TDX33029/Cubli-STM32F407-ESP32/Hardware/gif-demo.gif

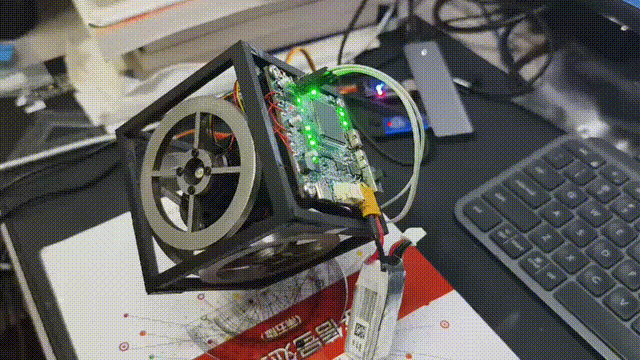
Hardware/gif-demo.gif
