TDX33029/Cubli-STM32F407-ESP32/Hardware/MB_RC.PNG

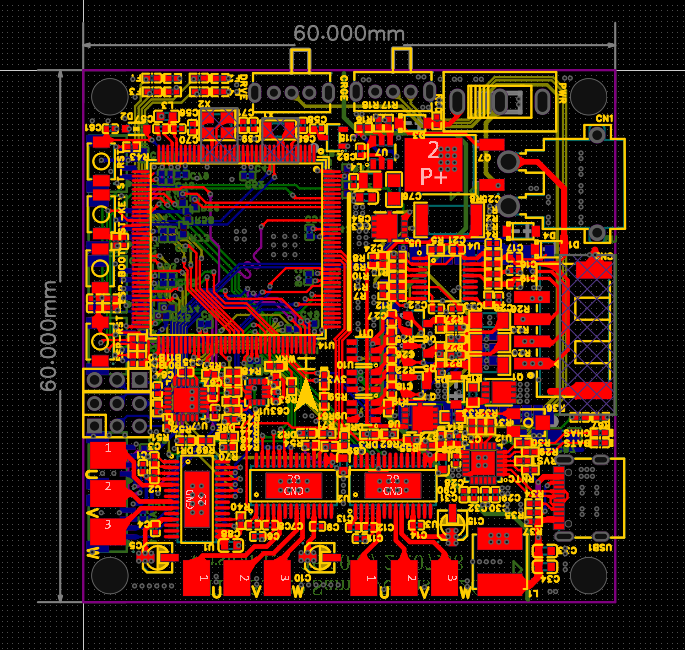
Hardware/MB_RC.PNG
