TDX33029/Cubli-STM32F407-ESP32/README.md

# Cubli Wireless

[🇨🇳 简体中文](README.md) | [🇬🇧 English](README_EN.md)

> LQR 平衡控制器算法 · STM32F407ZGT6 + ESP32-WROOM32 联合工程 支持二次开发学习

## 简介

本工程为 Cubli 平衡控制器的完整开源实现，包含固件、硬件、机械结构、上位机软件及全部必要文档，所有材料均已提供，不再赘述。

## 编译与构建

| 组件 | 工具链 |
| --- | --- |
| STM32F407ZGT6 固件 | Keil MDK V5.06 |
| ESP32-WROOM32 固件 | PlatformIO |

## 文件结构

| 目录 | 内容 |
| --- | --- |
| `Docs/` | 必要的数据手册文档 |
| `Firmware/` | STM32F407ZGT6 与 ESP32-WROOM32 固件源码 |
| `Hardware/` | PCB 相关资源文件 |
| `History/` | 历史提交归档 |
| `Mechanical/` | 机械结构相关资源文件 |
| `Software/` | 上位机控制器源码与可执行文件 |
| `Statistics/` | 参数统计数据与曲线 |

## 演示与预览

### 平衡控制器演示

https://github.com/user-attachments/assets/ebfe2009-a91b-4555-8b46-bfa3d13127df

### PCB 渲染与 Layout

| PCB 正面渲染 | PCB 背面渲染 |
| :---: | :---: |
| MB-3D-TOP | MB-3D-BOTTOM |

<p align="center">
  PCB Layout
  <br />
  <em>PCB 本体 Layout</em>
</p>

### 机械结构

<p align="center">
  3D 结构框架透视图
  <br />
  <em>3D 结构框架透视图</em>
</p>
