TDX33029/Cubli-STM32F407-ESP32/Hardware/README.md

# Hardware

[🇨🇳 简体中文](README.md) | [🇬🇧 English](README_EN.md)

> PCB 相关设计工程、生产制造文件及渲染图

## 文件列表

| 文件 | 说明 |
| --- | --- |
| `Cubli-Ver1.4-BLE.epro2` | 嘉立创PCB工程文件 包含主板与编码器小板 |
| `Gerber_MB.zip` | Gerber工程制板文件 |
| `Netlist_MB_Schematic.net` | 主板网表文件 |
| `MB_RC.PNG` | PCB隐藏铺铜透视图 |
| `MB-3D-TOP.PNG` | PCB顶层3D渲染图 |
| `MB-3D-BOTTOM.PNG` | PCB底层3D渲染图 |
