TDX33029/Cubli-STM32F407-ESP32/Hardware/README_EN.md

# Hardware

[🇨🇳 简体中文](README.md) | [🇬🇧 English](README_EN.md)

> PCB design project files, fabrication files, and renderings

## File List

| File | Description |
| --- | --- |
| `Cubli-Ver1.4-BLE.epro2` | JLC PCB project file, including the mainboard and encoder board |
| `Gerber_MB.zip` | Gerber fabrication files |
| `Netlist_MB_Schematic.net` | Mainboard netlist file |
| `MB_RC.PNG` | PCB hidden copper pour perspective view |
| `MB-3D-TOP.PNG` | PCB top-layer 3D rendering |
| `MB-3D-BOTTOM.PNG` | PCB bottom-layer 3D rendering |
