TDX33029/Cubli-STM32F407-ESP32/Firmware/README.md

# Firmware

[🇨🇳 简体中文](README.md) | [🇬🇧 English](README_EN.md)

> STM32F407ZGT6 与 ESP32-WROOM32 固件源码及调试工具链

## 文件结构

| 目录 | 内容 |
| --- | --- |
| `Cubli-ST/` | STM32F407ZGT6固件源码 |
| `Cubli-ESP/` | ESP32-WROOM32固件源码 |
| `Diagnostics/` | 硬件与功能块诊断代码 |
| `Tests/` | 测试代码 |
| `README/` | 详细调试与验证说明文档归档 |
