TDX33029/Cubli-STM32F407-ESP32/Firmware/README_EN.md

# Firmware

[🇨🇳 简体中文](README.md) | [🇬🇧 English](README_EN.md)

> STM32F407ZGT6 and ESP32-WROOM32 firmware source code and debugging toolchain

## Directory Structure

| Directory | Contents |
| --- | --- |
| `Cubli-ST/` | STM32F407ZGT6 firmware source code |
| `Cubli-ESP/` | ESP32-WROOM32 firmware source code |
| `Diagnostics/` | Hardware and functional block diagnostic code |
| `Tests/` | Test code |
| `README/` | Detailed debugging and verification documentation archive |
