TDX33029/Cubli-STM32F407-ESP32/Statistics/06_平衡性能指标对比/README.md

# 图 6：平衡性能指标对比

## 目标

在同一台设备、同一中性参考种子下，对比三组 LQR 参数的平衡性能：

- 基线：`Kp=80, Kd=5, Kw=-0.030, Ki=0`
- 低增益：`Kp=60, Kd=4, Kw=-0.030, Ki=0`
- 高增益：`Kp=110, Kd=7, Kw=-0.030, Ki=0`

## 实验与数据

每组 30 s 连续平衡，参数切换与数据采集由 `capture_compare.py` 自动完成。每组开始前
都重新下发同一组配置：

```
BREF -0.702828789 0.397786931 0.589743377
BNEUTRAL 1 0.00025 0.5 5 23.40 48.60
LQR1/2/3 <Kp> <Kd> -0.030 0
BAUTO 1 2
```

> 必须保持 `BNEUTRAL` 种子，否则固定 `BREF` 的 1–2° 重心偏置会使飞轮在 3 s 内
> 饱和跌倒（见 `05_扰动恢复能力测试/README.md`）。

| 数据文件 | 参数 | 平衡时长 | 数据帧 |
|---|---|---|---|
| `compare_base.csv` | 80 / 5 | 30.14 s | 604 |
| `compare_low.csv` | 60 / 4 | 30.07 s | 603 |
| `compare_high.csv` | 110 / 7 | 30.13 s | 604 |

采集过程中三组都出现了 **2–4 次重复扰动**（角速度峰值 30–38°/s，间隔约 6 s），
可能是线缆牵拉、桌面滑动或连续轻敲，并非单次受控冲击。因此本图的“恢复时间”取
每组检测到的扰动的**中位数**，并在括号内给出范围；单次受控三次冲击的重复性测试
见 [图 5](../05_扰动恢复能力测试/README.md)。

## 指标定义

| 指标 | 定义 |
|---|---|
| RMS 倾角 | 30 s 内 `sqrt(ePitch²+eRoll²)` 的 RMS |
| 最大倾角 | 30 s 内姿态偏差模长的最大值 |
| 恢复时间 | 扰动后平滑偏差回到冲击前包络并保持 0.5 s；取各组扰动中位数 |
| 初始稳定时间 | 从接管起，偏差连续 1 s 保持在 ±0.5° 内所需时间 |
| 飞轮转速峰值 | 三只飞轮 `|S|` 的最大值 |
| 电压峰值 / RMS | 三只电机控制电压的最大值 / RMS |

## 结果

| 指标 | 基线 80/5 | 低增益 60/4 | 高增益 110/7 |
|---|---|---|---|
| RMS 倾角 | **0.61°** | 0.87° | 0.63° |
| 最大倾角 | **3.04°** | 5.08° | 3.89° |
| 恢复时间中位数 | 1.30 s | 1.24 s | **0.70 s** |
| 恢复时间范围 | 1.29–1.31 s | 1.19–1.83 s | 0.44–2.79 s |
| 扰动次数 | 2 | 3 | 4 |
| 初始稳定时间 | 0.81 s | 0.00 s | 0.57 s |
| 飞轮峰值 | 103 rad/s | 108 rad/s | 122 rad/s |
| 电压峰值 | 4.65 V | **4.32 V** | 6.00 V |
| 电压 RMS | 0.95 V | 0.85 V | 1.21 V |

## 解读

1. **基线 80/5 是综合最稳的一组。** RMS 0.61° 最低，最大倾角 3.04° 最小，两次
   扰动的恢复时间几乎一致（1.29–1.31 s），电压峰值 4.65 V 仍有余量。
2. **低增益 60/4 抗扰最差。** RMS 0.87°、最大倾角 5.08°，约为基线的 1.4/1.7 倍；
   虽然控制电压最低（RMS 0.85 V），但姿态误差和振荡幅度明显变大，不建议用于
   需要抗扰的场合。
3. **高增益 110/7 恢复最快但不稳定。** 恢复时间中位数 0.70 s，明显快于基线；
   代价是电压峰值顶到 6 V 限幅、飞轮峰值 122 rad/s、电压 RMS 最高，而且有一次
   扰动需要 2.79 s 才恢复，说明一致性较差、接近权限边界。
4. **初始稳定都很快（<1 s）。** 三组接管时都在 0.5° 入位窗口内，初始稳定时间
   差异不显著；真正的差别体现在持续扰动下的 RMS 和最大偏差。
5. **建议：** 保留基线 80/5 作为默认参数。如果确实需要更快的扰动恢复，可把
   `Kp/Kd` 提高到 100/6 左右，同时把 `U` 限幅提高到 7 V 或降低重心偏置；不建议
   直接使用 110/7 + 6 V 限幅，因为已经出现饱和。

## 文件

| 文件 | 说明 |
|---|---|
| `capture_compare.py` | 三组参数自动切换 + BAUTO + 30 s 采集 |
| `compare_base.csv` / `compare_low.csv` / `compare_high.csv` | 三组原始遥测 |
| `compare_meta.csv` | 组别、增益、帧数、结果 |
| `plot_compare.m` | 指标计算与三联图（时序 + 6 项柱状图） |
| `performance_compare.png` | 输出图 |

## 复现

```bash
py capture_compare.py COM10 --balance=30 --wait=600
matlab -batch "cd('<本目录>'); plot_compare"
```

现场共 3 轮，每轮扶到 **PG8 常亮**、PG6 亮起瞬间松手；原计划每组敲一次，
实际数据中每组检测到 2–4 次扰动。若要做严格单次冲击对比，请使用图 5 的
`capture_seeded.py` / `plot_disturbance.m` 流程。
