TDX33029/Cubli-STM32F407-ESP32/Firmware/单点姿态观测对照_2026-10-16.md

# 单点姿态观测对照

三轴正负脉冲支持现有 BAXIS2/3/1 和 BDIR-1/-1/-1；启动电机校准用于编码器映射、方向与换相零点，脉冲的主要用途是测整机响应与轴间耦合。完整配对响应反推惯量违反主惯量三角不等式，未用于推荐增益。

四条控制日志中，融合姿态与 FAST 陀螺仪逐帧预测有约0.14～0.21°的20ms中位差，校正量与倾斜角加速度呈负相关，拟合系数约-0.017～-0.026秒。相关性有重力、采样和接触误差，不能直接认定IMU故障；见 diagnostics/2026-10-16/corner_observer_acceleration_consistency_review.json。

固定支点转动会在偏离支点的IMU上产生 `alpha x r + omega x (omega x r)`。这些加速度的方向会影响加速度计的倾角估计，即使加速度模长接近1g。用生产姿态估计代码进行已知真值仿真（3Hz、角速度幅值0.15rad/s、传感器位置y35mm/z70mm），加速度校正时间常数0.25秒时RMS误差0.1762°，1秒时0.0372°。该结果只是仿真，不能替代实机验证。

## 可选试验参数

新增失能命令 `BATTAU .25..2`，状态回读 `ATune:1 / AttTau`。默认仍为0.25秒；换模式、重新校准或复位恢复0.25秒。STOP保留当前值。拒绝活动状态、功率级仍使能、非有限值及越界值。

有限试验 `serial_corner_trial.py --attitude-tau 1` 会验证固件能力并回读实际值；未指定时在支持的固件上显式恢复0.25秒。既有长期自动脚本也恢复0.25秒，避免实验值留入旧基线。入位、陀螺仪积分、校准、传感器有效性与所有电机/倾倒保护不变。

第一轮只改变该时间常数：Kp80/Kd8/Kw-0.040（三轴）、Ki0、BYAW6、BTRIM0、参考24.70°/49.72°、自动寻点关闭、1°入位/2秒倒计时、6V、主机220rad/s/1.5rad/s/10°、固件L240/BTRIP20。先最多5秒，依据日志延长；不调方向、不增加电压或保护阈值。

## 软件验证与固件

生产C控制/UART测试通过，包括固定支点传感器仿真、静态收敛、参数边界、非有限数据、活动设置拒绝、模式/校准复位及既有控制律和保护回归。42项串口诊断测试通过，含默认清除实验值、显式设置回读及不支持/设置失败拒绝启动。实际UART六位小数回读修复沿用。

固件单独保存于 Cubli-ST/MDK-ARM/CubeMX-corner-observer。38个ARMCC输入、0错误、0警告；HEX校验和、烧录及实机结果以该目录 review_manifest.json 和后续日志为准。历史镜像保留。

## 首次实机结果

`corner_observer_tau1_comref_kd8_kw040_yaw6_trial5s_01` 的 ATune/AttTau 回读确认1.00秒，运行3.875秒后主机角速度1.614rad/s保护。M1=-163.64rad/s、M3=-193.38rad/s，两轴均达到-6V；最终三轴失能。没有完成5秒，不提升为默认配置。

逐帧观测校正率中位值由历史0.25秒日志约7.98°/秒降为这轮4.56°/秒，但释放条件和运动轨迹有差异，不能当作精确因果比较；幅度降低没有自动带来稳定。详见 diagnostics/2026-10-16/corner_observer_tau1_correction_review.json。下一轮在同一固件/同一次校准恢复0.25秒，保持所有其他参数，进行5秒对照。

该0.25秒对照 `corner_observer_tau025_comref_kd8_kw040_yaw6_trial5s_01` 在600秒等待中始终平放，未接管，active_samples=0；不能记为平衡失败或定时完成。已自动STOP/FAST0并确认 `Bal0/EN000/Auto0/Fault0/Aligned111/Cal1/AttTau0.25/NOn0`，停机限压2.5V、轮速15。后台仅剩只读角度窗口PID27020，没有电机调控进程。下一步待现场能手扶原角点时，直接重启同配置5秒对照；不复位就无需重新自检，不重新询问电池/支点/线材，不重新辨识转向。

用户选择后续每轮用弹出消息提醒。已在只读实时窗口实现无模态提醒：每个新试验首次进入等待/倒计时弹出一次，显示试验内容、实时和目标角度；没有确认或记录按钮，关闭消息不影响试验，摆好后MCU自动倒计时。PG6接管、停机或姿态过期时收起提示。元数据由有限试验脚本发布，窗口不发送控制命令/心跳。12项窗口测试和42项串口测试通过。串口连接正常但缺姿态时也不再误写成“自动重连”，会显示等待姿态数据。

## 弹窗版实机继续

窗口已重启为PID19356，系统枚举确认准备提醒在右上角可见（1432,20～1908,289），主实时窗口在中间，可同时看数据。`_trial5s_02` 开始前检测到设备复位（Aligned000/Cal0），没有启动；用户确认准备后 `corner_observer_popup_reset_prep01` 重新完成自检/校准。因此后续0.25秒数据与之前1秒数据不是严格同一次校准配对，不以时长差直接判断滤波优劣。

`corner_observer_tau025_comref_kd8_kw040_yaw6_trial5s_03` 完成真实入位与接管，运行2.672秒角速度1.548rad/s保护，M3约-204.61rad/s/-6V。随后只换旧参考23.44°/50°，`corner_observer_oldref_tau025_kd8_kw040_yaw6_trial5s_01` 运行3.735秒角速度1.735保护，M1/M3均-6V。两轮最终三轴失能。均未完成5秒；单独换参考/滤波尚未解决。

下一轮以同一次校准恢复历史已确认5秒的完整备份参数80/5/-0.040/0、BYAW6、旧参考23.44/50，τ0.25、寻点关闭；只把Kd8恢复Kd5，先5秒复现，记录 `corner_observer_verified_profile_kd5_trial5s_01`。尚未验证，不视为恢复成功。

另用六次既有启动扫描离线检查等电场相位的编码器重复性：正反向均值的电角度偏移跨度M1约34°、M2约44°、M3约43°。动态扫描的跟随滞后、齿槽和编码器非线性均可能贡献；M3谐波拟合的留出误差反而较大，不能据此建立校正表或断言编码器损坏。数据见 diagnostics/2026-10-16/encoder_bidirectional_phase_repeatability_review.json。没有改编码器校正、极对数或换相零点算法。

## 用户暂停断点

完整历史参数复测 `corner_observer_verified_profile_kd5_trial5s_01` 实际运行4.110秒后角速度1.914rad/s保护，M1=-211.47rad/s/-6V，M3=-70.22rad/s/-5.10V，最终确认EN000/Bal0。没有复现5秒成功，不能当成恢复完成。

下一候选只提高Kp80→120，保留Kd5/Kw-0.040/BYAW6/τ0.25、旧参考23.44/50、寻点关闭、6V及原保护，最多5秒。`corner_observer_oldref_kp120_kd5_trial5s_01` 打开串口即失败：CH340/COM7不存在，仅蓝牙COM3/COM4，active_samples=0、没有发送命令，**该Kp120试验尚未执行**。

用户明确要求“先停止等待我手动恢复”。已停止等待和调试，不后台轮询或自动重试。恢复必须由用户消息触发，再发现实际CH340端口、读取新STATE，检查是否复位；只在需要时恢复常规自检/校准。只读窗口原PID19356已不存在，恢复时按实际端口重新启动弹窗版窗口。最后一次实际失能确认来自Kd5复测；离线期间无法验证设备状态，不能把live.json缓存当作当前状态。下次Kp120试验需新tag，避免覆盖已有失败日志。
