TDX33029/Cubli-STM32F407-ESP32/Firmware/单点自动寻点说明_2026-10-16.md

# 单点自动寻点试验

目的：在原始重心候选附近缓慢移动控制目标，减少固定姿态偏差导致的持续飞轮加速。它是待实机验证的慢速外环，不保证真实重心已识别，也不增加电机力矩或改变保护阈值。

## 控制与边界

- 快环保留 Kp=80、Kd=8、Kw=-0.040（三轴）、BYAW=6 的试验配置；Ki=0、BTRIM=0。
- 将飞轮转速按已确认轴映射和机械方向转成机体向量，去除原始重力方向分量，只用倾斜平面的分量移动目标。相同飞轮惯量是此投影的前提。
- 低通时间常数 0.3 秒，轮速向量死区 3 rad/s。首轮增益 0.00025、最大速度 0.5°/秒；首轮失败后增加有界调参，默认降为 0.000025 和 0.1°/秒。总角度仍不超过原始参考的 2°。
- 接管前 300 ms、角速度达到 0.5 rad/s、跟踪误差超过 5°、任一电机输出达到限压的 95%、传感器异常或数据过期时冻结调整并清除轮速滤波值。
- 原始参考仍作保护锚点。相对原始参考或动态目标任一偏差超过固件倾倒阈值均保护；主机仍检查原始参考 10°、机体 1.5 rad/s、飞轮 220 rad/s。6 V 限压和固件 240 rad/s 立即超速阈值沿用有限试验设置。
- STOP 保留本次学习偏移，清除瞬态滤波；重新设参考、换模式/轴/方向、校准或复位清除学习。没有写入 Flash，也没有自动覆盖备份参数。

## 使用

新增失能时命令 `BNEUTRAL 0/1 [gain rate_deg_s]`，默认关闭。NTune:2 允许增益 0.000005～0.00025、最大速度 0.01～0.5°/秒，越界拒绝。启用要求单点模式、有效参考/IMU 校准、三轴映射与方向确认，且 Ki/BTRIM 均为零；启用后拒绝非零积分设置。

有限试验脚本 `diagnostics/serial_corner_trial.py` 增加 `--neutral-learning`、`--neutral-gain`、`--neutral-rate`，要求显式固定参考，校验 NTune/NOn/NLimit/NRate/NGain 回读，并记录动态目标、相对原始参考最大偏移及实际跟踪偏差。主机额外检查遥测目标没有越过 2°（含 0.03°显示量化余量）。默认试验与既有自动长测脚本显式关闭学习，保证历史配置可复测；尚未把本功能提升为长期自动默认配置。

STATE 新增 NTune/NOn/NPit/NRol/NOff/NLimit/NRate/NGain。FAST 启用学习时以 NPit/NRol 替换三个始终为零的倾角积分字段，保持原 280 字节预算。只读角度窗口持续采样并显示“自动寻点目标”，定时剩余秒数和停机原因不变。

## 验证记录

生产 C 控制/UART 测试通过：开关条件、机械方向、纯自转不漂移、目标单位长度、范围/速度限制、异常冻结、STOP 保留与配置重置、学习后入位，以及原始参考保护不会随目标移动。35 个串口诊断测试及 10 个只读窗口测试通过。关闭功能时原控制律回归测试仍通过。

ARMCC 编译 38 个输入，0 错误、0 警告。固件单独保存在 `Cubli-ST/MDK-ARM/CubeMX-corner-neutral`，历史可用版本保留。实机效果与烧录状态见该目录 review_manifest.json 和后续试验日志；本文件的测试通过仅指软件测试。

## 首轮实机结果

`corner_neutral_comref_kd8_kw040_yaw6_trial5s_01` 实际运行 4.36 秒，触发主机角速度保护（1.645 rad/s），最终三轴失能确认。动态目标移动约 1.47°，从 24.70°/49.72° 到 23.53°/48.75°，M3 仍达到约 -200 rad/s、-6 V。相对动态目标最大偏差约 3.89°（不含最终保护帧），没有完成 5 秒运行，也没有证明找到重心。用户要求以日志分析为主。

调整在 M3 饱和后正确冻结，但此轮稳定时间没有改善。初始释放姿态与固定参考对照并非完全相同，不能仅凭一次时长断言因果。下一步只降低慢环增益/速度，与原快环做对照，不把该学习结果提升为默认参考。

## 慢速对照与回读修复

慢速镜像初次试验 `_trial8s_01` 没有接管：新增 NGain 回读需要 6 位小数，原 UART 固定格式最多输出 3 位，脚本发现回读不符后拒绝启动。已修复真实 UART 格式器并补充其输出回归测试；修复后 HEX SHA256 为 `fb1c4312be9587ca89f76d03fda778fde98983ccb7b5320dfa6ae2769876db68`，重新完成三轴自检及校准。

`corner_neutral_slow_comref_kd8_kw040_yaw6_trial8s_02` 使用增益 0.000025、速度 0.1°/秒，运行 5.797 秒后角速度 1.538 rad/s 保护，最终失能。目标移动约 0.43°，末值 Pitch24.40°/Roll49.38°。M3 轮速从约 -84 转到 +197 rad/s 并达到 +6 V。未完成 8 秒，不能称为长期平衡成功。

结合四条日志，以 0.2 秒积分窗口拟合电机电压/轮速响应，排除释放最初 0.4 秒和角速度超过 0.5 rad/s 的窗口，等效速度电压系数约为 0.0239/0.0235/0.0262 V/(rad/s)。留一轮验证的增量误差约 0.9～4.3 rad/s，故它只是观测模型，不能当作准确反电势、力矩或惯量测量。详细数据见 `diagnostics/2026-10-16/neutral_search_motor_response_review.json`。下一次只将 Kw 从 -0.040 小幅改为 -0.035，其余沿用慢速对照，不提高保护阈值。

## 本次收尾状态与下一步

Kw=-0.035 的对照 `corner_neutral_slow_comref_kd8_kw035_yaw6_trial8s_01` 运行 6.000 秒，仍以角速度 1.593 rad/s 保护，M3 为 +163.31 rad/s、+6 V，目标移动约 0.48°到 Pitch24.24°/Roll49.60°。也没有完成 8 秒。

| 试验 | 寻点增益 / 最大速度 | Kw | 实际运行 | 结果 |
| --- | --- | --- | --- | --- |
| 首轮 | 0.00025 / 0.5°每秒 | -0.040 | 4.36秒 | 角速度保护，偏移约1.47° |
| 慢速 | 0.000025 / 0.1°每秒 | -0.040 | 5.797秒 | 角速度保护，偏移约0.43° |
| 轮速项对照 | 0.000025 / 0.1°每秒 | -0.035 | 6.000秒 | 角速度保护，偏移约0.48° |

入位误差和释放瞬态不完全相同，因此时长差不是严格的因果证明。现有证据仅证明有界参考调整、保护和日志链路按设计运行，**没有证明长期平衡或重心识别收敛**。三轮均在 M3 达到限压后出现较大机体角速度；下一步应先验证多轴动态响应、控制余量与姿态估计的一致性，分离执行器补偿、耦合和重心误差，不应继续仅靠扩大寻点范围或提高保护阈值解决。

本次已执行 `corner_neutral_restore_baseline_disabled01`（仅配置、没有接管）：恢复测试前的 80/8/-0.040/0、BYAW6、BTRIM0、原始候选 Pitch24.70°/Roll49.72°。最终 `Bal0 / EN000 / Auto0 / Fault0 / NOn0 / NOff0`，三轴对齐和 IMU 校准有效；停止后限压回到 2.5 V、轮速限制 15 rad/s。自动寻点保留为默认关闭的实验功能，所有学习结果只在日志中保存。

当前固件为 `CubeMX-corner-neutral-slow`（含六位回读修复），SHA256 `fb1c4312be9587ca89f76d03fda778fde98983ccb7b5320dfa6ae2769876db68`。只读窗口 PID6760 持续读取 COM7（不发送心跳）；没有后台电机调控脚本。后续从日志和该文档继续，无需重复询问电池、支点、线材或每轮记录按钮。
