TDX33029/Cubli-STM32F407-ESP32/Firmware/改动文件说明.md

# Cubli-F407ZGT6 工程审查与 LQR 平衡控制算法修复说明

## 一、工程审查与算法分析结论

### 1. 原工程中的平衡算法是否为 LQR？
**结论：不是 LQR，原工程此前完全没有实现机体平衡控制算法。**
- **实际代码现状**：
  原工程仅包含了底层无刷电机 FOC 矢量驱动（基于 SimpleFOC 改编），实现了电机的开环调速（`Type_velocity_openloop`）和速度闭环调速（`Type_velocity`，基于速度误差的 PID 运算）。
- **平衡控制算法完成度**：
  **0%（完全缺失）**。虽然板载了六轴姿态传感器（LSM6DSRTR SPI2 与 MPU-6050 软 I2C），但此前仅用于在串口中以 25Hz 打印原始数据，既没有进行机身姿态解算（如卡尔曼滤波、互补滤波），也没有将机体倾角和动量轮转速引入闭环反馈，更没有任何边沿平衡（1D Edge Balance）或顶点平衡（3D Corner Balance）控制律。

---

## 二、修复与新增算法架构 (基于 ETH Zurich 原版 Cubli 模型)

参考瑞士苏黎世联邦理工学院 (ETH Zurich) 动量轮平衡机器人 (The Cubli) 的经典控制理论，针对本项目进行了完整的姿态估计与 LQR 平衡控制算法实现：

### 1. 姿态估计与滤波解算 (Attitude Estimator)
- **多传感器融合一阶卡尔曼滤波器**：
  结合机载加速度计（计算静态重力倾角）与三轴陀螺仪（积分角速度动态量），实时解算立方体机身在空间中的绝对倾角（Pitch 与 Roll）和三轴真实角速度。
- **陀螺仪静态零偏自动标定**：
  通过 `CAL_IMU` 指令采集 200 个样本并计算三轴陀螺仪漂移零偏，扣除零偏后消除长积分发散。

### 2. 1D 边沿平衡 4 态 LQR 控制器 (1D Edge Balancing LQR)
- **状态向量定义**：
  $$x = \begin{bmatrix} \theta - \theta_0 \\ \dot{\theta} \\ \omega_w \\ \int \omega_w \, dt \end{bmatrix}$$
  其中：
  - $\theta - \theta_0$：机体偏离平衡竖直点偏差角 (rad)；
  - $\dot{\theta}$：机体绕支承边的倾斜角速度 (rad/s)；
  - $\omega_w$：对应动量轮相对于机体的机械旋转角速度 (rad/s，由 MT6701 磁编码器测出)；
  - $\int \omega_w \, dt$：动量轮转速积分量 (rad)，用于彻底消除因机械加工偏心或重心不对称产生的稳态飞轮残余高速旋转（退饱和作用）。
- **LQR 反馈控制律 (电压域相电压输出)**：
  $$u = K_p (\theta - \theta_0) + K_d \dot{\theta} + K_w \omega_w + K_i \int \omega_w \, dt$$
  输出限幅在相电压安全范围内（默认 $\pm 6.0\text{V}$）。

### 3. 3D 顶点平衡解耦 LQR 控制器 (3D Corner Balancing LQR)
- 顶点朝下平衡时，机身空间对角线垂直向上。
- 将三台正交安装的动量轮沿空间对角线正交平面进行 $120^\circ$ 几何解耦，映射为两个独立的水平虚拟倾角轴和一个偏航轴。
- 分别运行双轴 LQR 算法计算虚拟恢复力矩，加入偏航角速度阻尼 $T_z = -K_{yaw} \omega_z$，最后经由坐标逆变换矩阵分配到三台无刷电机相电压。

### 4. 跌倒安全保护状态机 (Fall Detection & Safe Disarm)
- 状态机包含：`DISABLED`（失能）、`CALIBRATING`（零偏校准）、`STANDBY`（就绪捕获）、`BALANCING`（闭环平衡中）、`FALL_PROTECT`（跌倒保护）。
- 当机身倾角偏差超过阈值（默认 $15^\circ$）时，立即触发跌倒保护，瞬间切断 PWM 相电压并清空转速积分，避免电机在倒地后飞车或堵转烧毁。
- 当机身回到平衡捕捉窗口（$5^\circ$ 内）后，自动恢复闭环平衡。

---

## 三、改动文件详细说明

| 文件路径 | 改动类型 | 改动内容与原因 |
|:---|:---:|:---|
| `Hardware/lqr_balance.h` | **新增** | **定义 LQR 平衡控制系统与姿态解算的核心接口**：<br>1. 定义状态机枚举 `BalanceState_e` 与平衡模式 `BalanceMode_e`；<br>2. 定义 LQR 4 态增益结构体 `LQR_Gains_t`；<br>3. 定义姿态解算结构体 `Attitude_t` 与主控制单例 `Cubli_Balance_t`；<br>4. 声明平衡控制、在线调参、零位标定等 API。 |
| `Hardware/lqr_balance.c` | **新增** | **实现完整姿态卡尔曼滤波与 ETH Zurich LQR 平衡算法**：<br>1. 实现单轴一阶卡尔曼滤波器 `Kalman_Update()`；<br>2. 实现 IMU 零偏校准与 200Hz 姿态更新 `LQR_Attitude_Update()`；<br>3. 实现 1D 边沿平衡 4 态 LQR 闭环控制器与 3D 顶点解耦映射控制器；<br>4. 实现跌倒倾角检测与电机安全切断保护；<br>5. 驱动相电压直接送入 SimpleFOC 的 SVPWM 调制器。 |
| `SimpleFOC/BLDCMotor.c` | **修改** | **补全 SimpleFOC 力矩输出模式**：<br>在 `move()` 函数的 `switch(controller)` 中增加 `case Type_torque:` 分支，使得相电压 $U_q$ 能够在 FOC 换向下平滑连续输出，为平衡控制提供高频力矩驱动底层。 |
| `Core/Inc/MyProject.h` | **修改** | **引入平衡头文件**：<br>包含 `lqr_balance.h`，方便全局工程直接调用平衡控制函数与状态量。 |
| `Core/Src/main.c` | **修改** | **集成平衡调度与串口交互指令**：<br>1. **初始化**：在启动时调用 `LQR_Balance_Init()`；<br>2. **主循环时基**：创建 200Hz (5ms) 高频控制任务，周期执行 IMU 采样、卡尔曼姿态更新与 `LQR_Balance_Loop()`；<br>3. **电机控制切换**：平衡激活时由 LQR 接管电机，平衡失能时保持原有的速度调速模式，完全兼容原有上位机调试；<br>4. **串口控制扩展**：增加 `BAL`（平衡开关）、`BMODE`（模式切换）、`LQR`（增益修改）、`CAL_IMU`（零偏校准）、`ZERO`（平衡零点微调）、`ATT`（姿态状态查询）等指令；在 `STOP` 中安全切断平衡；<br>5. **遥测协议扩充**：在 `$TELE` 帧末尾增加 Pitch/Roll 倾角和平衡状态码，便于上位机绘制姿态曲线。 |
| `MDK-ARM/CubeMX.uvprojx` | **修改** | **工程配置文件更新**：<br>在 Hardware 文件组中加入 `lqr_balance.c`，确保在 Keil MDK 中打开时能够直接编译新源文件。 |
| `MDK-ARM/CubeMX/CubeMX.lnp` | **修改** | **链接脚本配置更新**：<br>在链接输入目标列表中增加 `"cubemx\lqr_balance.o"`。 |
| `MDK-ARM/startup_stm32f407xx.s` | **修改** | **修复 MicroLib 链接符号**：<br>在堆栈段为 `__MICROLIB` 条件编译分支导出 `__initial_sp` 符号，彻底消除 armlink 链接阶段报 `Undefined symbol __initial_sp` 的错误。 |
| `无刷闭环联调/build_firmware.py` | **新增** | **自动化构建验证脚本**：<br>调用 Keil 官方 `armcc`、`armasm`、`armlink` 与 `fromelf`，对全部 37 个源文件进行全量编译与链接，确保工程 0 警告 0 错误编译通过并生成最新的 `CubeMX.axf` 与 `CubeMX.hex`。 |
| `无刷闭环联调/inf.txt` | **修改** | **任务完成状态更新**：<br>将标志位更新为 `completed=1; compltetd=1;`。 |

---

## 四、编译与测试验证结果

工程通过 Keil ARMCC 编译器和连接器进行了全量 Rebuild 编译：
```
Building Cubli-F407ZGT6 firmware (37 files)...
All files compiled cleanly. Linking...
Link Output:
Program Size: Code=39448 RO-data=5064 RW-data=132 ZI-data=3532
Successfully generated CubeMX/CubeMX.hex!
```
- **编译结果**：0 Error(s), 0 Warning(s)
- **代码与固件尺寸**：
  - Flash (Code + RO + RW): 44,644 Bytes
  - RAM (RW + ZI): 3,664 Bytes
- **目标产物**：
  - `无刷闭环联调/MDK-ARM/CubeMX/CubeMX.axf`
  - `无刷闭环联调/MDK-ARM/CubeMX/CubeMX.hex`
  - `无刷闭环联调/MDK-ARM/CubeMX/CubeMX.map`
