TDX33029/Cubli-STM32F407-ESP32/Firmware/本次检查与双模式联调说明.md

# 2026-10-12 检查修复与双模式联调记录

本次实际检查 `Cubli-ST`、`Cubli-ESP`、`Software` 和 `Netlist_MB_Schematic_2026-10-07.net`，并修改源码。现已实现上位机控制的**单电机调试模式**和**平衡工作模式**，三端协议配套更新。历史改动说明中的算法与构建记录属于旧版本，以本文及当前源码为准。

## 网表核对

| 对象 | 硬件连接 | 当前软件配置 |
| --- | --- | --- |
| M1 DRV8313 | EN=PD0，IN1/2/3=PE9/PE11/PE13 | TIM1三路PWM |
| M2 DRV8313 | EN=PD1，IN1/2/3=PA6/PA7/PB0 | TIM3三路PWM |
| M3 DRV8313 | EN=PD2，IN1/2/3=PD12/PD13/PD14 | TIM4三路PWM |
| 驱动故障 | FAULT1/2/3=PG9/PG10/PG11，低有效 | 新增上拉输入与1ms故障检查，故障关闭全部EN |
| MT6701 | M1=I2C1 PB6/PB7；M2=I2C2 PF1/PF0；M3=I2C3 PA8/PC9 | 默认绝对角度读取，固定网表映射 |
| 主IMU | LSM6DSR SPI2 PB12～PB15 | 416Hz输出，200Hz重力姿态更新 |
| 备用IMU | MPU6050 PB10/PB11软件I2C | 200Hz采样，减少原5Hz滤波造成的延迟 |
| 板载无线 | PA9→ESP IO26；ESP IO25→PA10 | USART1，115200/8N1，TCP3333 |
| 晶振 | 网表25MHz | PLLM=25，系统168MHz，与配置匹配 |

DRV8313的SLEEP由网表中的硬件开关控制，RESET上拉；软件通过每颗驱动共用的三个EN实现失能。未虚构可控的SLEEP/RESET引脚。

## 已修复问题

1. **HAL时基重复累加**：原SysTick、TIM6都调用HAL_IncTick，延时和控制周期约快一倍。现在只有SysTick维护HAL时间，TIM6用于1ms安全检查和遥测计数。
2. **没有独立调试/工作模式**：增加APP状态，固件强制互锁；调试只能使能选中的一台电机，工作模式拒绝手动调速和驱动使能。
3. **退出平衡恢复历史速度**：全部模式/轴/开闭环切换先清零、失能并复位控制状态；BAL 0和STOP同样处理。
4. **校准会自行启动平衡**：IMU校准只校准，不使能；连续200个静止样本后回到失能状态，启动必须单独执行BAL 1。
5. **跌倒后自动复转**：改为锁存停机，重新扶正后必须显式启动。
6. **平衡换相只有200Hz**：把200Hz姿态/状态反馈与主循环中的快速编码器采样/SVPWM换相分开。200Hz保持的是Uq目标，电角度持续更新；实际换相频率受I2C吞吐限制，尚未在板上测量。
7. **顶点模式越界**：原LQR/ATT等按mode=3访问长度3数组。参数接口统一通过边沿/顶点的三轴参数组访问，避免越界，也可回读顶点增益。
8. **顶点姿态与输出轴不一致**：取消把机体Euler角直接当水平虚拟轴角的120°分配；改为机体系归一化重力方向与目标方向的叉乘误差，三轴分配与机体轴一致。M3边沿也使用重力投影，不再依赖漂移的yaw积分。
9. **安装方向与编码器方向混用**：增加独立BDIR机架方向，编码器自动旋向只用于FOC/测速；BZERO采集真实平衡姿态。
10. **对齐可能假成功**：编码器离线、扫动无位移、位移与7极对数明显不符或停机中止，均判为失败。单轴自检/对齐完成保持失能，不再自动使能所有已安装电机。
11. **串口连续命令丢失**：将原单条接收标志改为16槽队列。PING和STOP由接收中断优先处理；超长/损坏行整行丢弃，队列溢出停机。严格解析命令token和有限数值，避免前缀误匹配和NaN控制量。
12. **printf可能阻塞控制**：发送缓冲满时不再自旋等待；遥测根据缓冲余量跳过整帧。状态周期改为5Hz，避免和25Hz遥测一起占满115200链路。
13. **没有断链停机**：上位机250ms心跳、STM32 1500ms超时失能；ESP不代发心跳。ESP仅允许一个控制客户端，连接/断开均发送STOP。TCP EOF和发送/接收错误向界面报告并关闭链路。
14. **急停可能被防抖队列覆盖**：上位机急停清空待发指令和速度防抖，STOP置于队首；断开/重连清空历史队列。
15. **驱动/阻塞/堵转保护不足**：新增nFAULT检测、主循环超过30ms未更新停机；调试与平衡持续高输出但低速堵转800ms时失能。异常处理器也拉低EN。停止不是主动制动，动量轮可能继续惯性旋转。
16. **界面状态错误**：开闭环按钮不再按文字猜测或提前显示成功；APP、轴、使能、校准、故障、倾斜、Uq由固件STATE回读。调试显示单轴卡片，工作显示平衡配置；增加参数查询、安装方向、姿态采集和停机复位入口。
17. **正交编码器时基边界**：修复备用TIM7微秒计数在溢出待处理时的读取竞争。默认仍用I2C；正交模式无法仅凭计数器判断编码器掉线，且每圈计数配置必须与器件设置一致。
18. **构建可信度**：构建脚本检查链接输入都有源码并完整编译，显示编译警告并检查HEX导出返回值；栈扩为4KB以留出串口解析、浮点printf和中断嵌套空间。

原PP长时间扫场、SCAN与三轴自动映射自检不再由命令入口执行。网表映射保持固定，自检采用选定单轴电角度对齐，避免无意驱动其它电机或覆盖已校准映射。

## 验证结果

- **STM32**：Keil ARMCC 全量编译38个输入，0错误、0警告，链接及HEX导出成功。Code=36256、RO=1912、RW=164、ZI=10876；ROM合计38332字节，RAM合计11040字节。
- **ESP32**：PlatformIO espressif32 7.1.3 / Arduino 2.0.17 构建成功；RAM 45024字节，Flash 751749字节。输出为应用分区固件；首次烧录通过PlatformIO上传会包含引导程序与分区表。
- **控制C回归**：MSVC运行生产解析器、状态机、FOC、SVPWM、姿态及平衡控制函数，仅替换硬件边界。覆盖单轴互锁、旧目标清零、校准不启动、顶点参数访问、机架/编码器方向分离、捕获、跌倒锁存、IMU过期、编码器故障、nFAULT、心跳超时、主循环超时、堵转、计时回绕、零速输出。
- **UART回归**：运行实际接收中断与队列代码，验证粘连多条命令、混合大小写STOP/PING、超长行、ORE错误、队列溢出、发送缓冲满不阻塞。
- **上位机**：13项自动测试通过，覆盖模式互锁、急停清队列、单轴指令、防抖取消、闭环按钮应答、顶点轴完整性、增益回读、新旧遥测、非法状态帧、方向编辑、TCP EOF和实际本地TCP心跳/断开。
- **界面**：窗口实例化与Windows Qt渲染检查通过。未连接真实串口/电机，没有烧录或启动实机。

测试入口在 `tests/`。产物及关键源码SHA256见 `tests/verification.json`。

## 使用与实机待确认项

详细操作见 `Software/README.md`。通常先进入调试模式，逐轴自检/对齐、切闭环并单轴调速；之后切工作模式，选择边沿/顶点、静止校准IMU、扶在实际平衡点采集姿态、确认安装方向和增益，最后显式启动平衡。

**软件构建和模拟测试已完成，实际稳定平衡未验证。** 网表只确定电气连接，不能确定IMU与轮轴的机械坐标、重心、惯量及电机力矩常数。当前默认增益为待整定电压域状态反馈参数，没有根据本机模型求解最优LQR；其数值、飞轮反馈符号和输出能力需要实机识别。默认轴映射要求M1/M2/M3沿IMU的X/Y/Z正交安装，BDIR仅能修改正负方向。

本机当前没有有效相电流闭环、母线电压/温度反馈，软件失能与堵转检测不能等同于电流保护。实机验证应在限流电源、单轴固定机架条件下先确认换相方向、测速、急停和故障保护，再验证平衡；不应将本次测试结果当作可直接无人值守运行的证明。所有参数和标定结果仅在RAM保存，掉电需重新设置。

## F4正交方法复查补充

已进一步核对三路AB引脚与四倍频配置，修复任意PPR回绕、分辨率换算和计数器就绪检查，新增独立正交版HEX与模拟回归。公共宏按1024 PPR（4096 CPR）配置，可分轴修改，默认I2C版保持可用。详细结论见 `F4硬件正交编码器检查说明.md`。
