TDX33029/Cubli-STM32F407-ESP32/Firmware/联调记录_2026-10-18.md

# 2026-10-18 单点调试

用户恢复设备并要求开始调试，串口现为COM9。工作区新增的b1c5f7a仅为结构/硬件资料清理，控制源码未变。

## 固件版本核对与默认输出修正

初始STATE没有NTune/ATune。只读SWD HOTPLUG回传64KB并逐字节比对，板上是旧默认CubeMX/entry2s（49940数据字节），不是当前控制源码对应镜像。读回备份、比对、初始STATE见 diagnostics/2026-10-18/initial_*。

从当前源码完整重建默认CubeMX（38输入，0错误0警告），新HEX与已验证observer镜像完全一致，SHA256 `fc2b4c2bd48e200d78c7fb094de2150e3ce23f0787d696df2477db035051adec`，52524数据字节。默认目录已烧录并通过校验，历史entry2s保留。没有更改控制源码或默认参数。后续使用MDK-ARM/CubeMX/CubeMX.hex，参见同目录《当前固件说明.md》。此块提交97aa872。

用户确认飞轮悬空静止后，startup_prep01完成三轴自检/IMU校准：映射3/1/2、传感器方向+1、PP7，Aligned111/Cal1/EN000/Fault0，固件NTune2/ATune1。已知机体映射BAXIS2/3/1、BDIR全部-1，不重复物理方向辨识。

只读弹窗窗口PID8072，COM9，live文件 `.codex-debug/20261018-validation/live.json`。每轮等待入位会弹出无模态提醒，摆好后自动倒计时，PG6亮即松手；GUI不发心跳或电机命令。

## 已完成测试

共同设置：旧参考Pitch23.4399°/Roll50°，Kw=-0.040三轴，Ki/BTRIM0，BYAW6，自动寻点关闭，1°/2秒入位，6V，固件L240/BTRIP20，主机220rad/s、1.5rad/s、相对原参考10°。不放宽保护来延长运行。

| 日志tag | Kp/Kd | 姿态常数 | 实际运行 | 结果 |
| --- | --- | --- | --- | --- |
| kp120_kd5_trial5s_01 | 120/5 | 0.25秒 | 1.563秒 | 角速度1.530保护；M1-158.59/-6V，M2+171.01/+3.57V |
| kp120_kd10_trial5s_01 | 120/10 | 0.25秒 | 2.516秒 | 角速度1.562保护；M1-193.09/-6V，M3-146.65/-6V |

两轮均最终EN000/Bal0/Fault0。更强角度反馈/阻尼尚未稳定，也未完成5秒。结合FAST角度、陀螺仪和轮速重建第一轮的生产控制律，三轴电压RMSE约0.028/0.031/0.022V，说明控制输出与参数相符；首次限压约0.78秒。结果见 kp120_kd5_control_reconstruction.json，不能凭某个时刻角度与角速度不同就证明IMU故障。

下一轮仅将姿态校正常数0.25→2秒，保持120/10及其他参数：kp120_kd10_tau2_trial5s_01，最多5秒。目的是检查动态加速度校正造成的角度摆动是否减轻，不是已验证配置；需要依据实际日志继续。

该τ2试验实际运行2.079秒，角速度1.631rad/s保护，M1/M3均-6V，最终EN000。尚未改善。

## 用户指定自动寻点与角速度保护调整

用户观察到先保持、飞轮持续加速后保护，要求改为自己寻找平衡点，并提出增加角加速度/提高角速度保护。此前本日三轮为单独比较增益/观测参数，NOn均为0，未启用寻点。

下一组恢复80/5/-0.040/BYAW6/τ0.25和旧参考，只启用有界寻点：增益0.000075、最大目标速度0.3°/秒、2°总范围，排除竖直自转分量，限压/大角速度等条件仍冻结学习。先8秒，判断目标调整是否降低轮速积累，不能把达到偏移边界当作真实重心已找到。

按用户本次明确提出的保护调整，有限诊断增加 --body-rate-bound：默认仍1.5rad/s，显式允许到2.0rad/s；本轮用2.0。硬件3rad/s保护不改，电压6V、飞轮220rad/s、主机相对原参考10°/固件20°保护不变。该参数指机体陀螺仪角速度，不是飞轮速度。脉冲辨识继续限制1.5，不能借此提高脉冲保护。45项串口模拟测试通过，验证新阈值、超阈值停机、倾倒保护与正确停机原因。此改变不需要烧录/重新校准。

## 2°寻点结果与5°范围扩展

`neutral_mid_oldref_rate2_trial8s_01` 实际5.109秒后角速度2.295rad/s、相对原参考倾角约10°触发主机保护。目标偏移1.060°，由23.4399°/50°移至23.27°/48.86°，M1轮速回到+15.25，M3仍-200.42且-6V。目标有移动，但未找到长期平衡，不将其记为成功。

用户明确授权扩大至5°。实现NTune3：BNEUTRAL可设2～5°总范围，仍以原始BREF为锚；单位重力向量的旋转范数限制目标，速率限制仍独立，5°不是每轴可累加5°。缺省/旧命令保持2°，模式切换/IMU校准后恢复默认；失能时可用附加种子角恢复已学目标，越界种子、低于已有偏移的缩范围、运行中配置均拒绝。原20°倾倒保护仍以原始参考判断。

诊断脚本新增 `--neutral-limit`、`--resume-neutral-from`、`--seed-neutral-from`。同一次上电STOP后可验证固件/校准/映射/参数/目标快照并跳过会清空学习量的配置命令；复位后使用保存目标作为种子，保留原始23.4399°/50°锚点。保存的是运行记录，未声称固件掉电自动持久化。默认/固定参考路径显式关闭NTune3学习。

验证：生产C测试（5°夹紧/速率/种子方向与单位长度、越界和运行中拒绝、原始20°保护、遥测容量）通过；50项串口模拟和12项提示窗测试通过。默认CubeMX完整重建、烧录及校验通过，镜像详情见MDK当前说明。下一轮从23.27°/48.86°种子继续，80/5/-0.040、yaw6、tau0.25、gain0.000075、rate0.3°/秒、总范围5°，6V/220rad/s/机体2rad/s/原参考10°主机保护不变，最多8秒。

### 5°首轮真机结果

`neutral5_seed_trial8s_01` 已确认板上NTune3/NLimit5.00，种子23.27°/48.86°、NOff1.060°读取匹配。实际7.110秒后机体角速度2.098rad/s保护（原锚点倾角7.48°），最后M1+145.19/M2+19.32/M3-189.18rad/s，M3-6V。失能读回EN000/Bal0/Fault0，学习目标23.32°/47.58°、NOff2.227°，没有清空原BREF。已越过旧2°上限，但没有完成8秒；不能据此声称长期稳定。

下一轮同参数使用resume，严格快照匹配后不重发BMODE/BAXIS/BDIR/BREF，不清学习，从2.227°继续。用户无需点击或逐轮确认，弹窗后自动等入位。

### 第二轮与竖直轮速反馈隔离

`neutral5_resume_trial8s_02` 新鲜状态验证保留2.227°后直接运行，无重发BREF/模式映射。实际6.219秒后机体角速度2.279保护；最后M1+162.11/M2+64.53/M3-191.50rad/s，目标22.94°/48.11°、偏移1.811°，最终EN000。目标未碰5°上限，单纯扩大范围尚未解决持续加速。

对两轮按原参考g分解陀螺仪与轮速（neutral5_two_run_comparison.json）：第二轮前3秒角速均值0.04～0.06rad/s，4～5秒竖直自转分量开始增长，5秒段机体角速均值0.246、自转分量0.220rad/s，随后M3限压、倾倒。旧控制的Kw=-.04给每轴+.04*wheel电压，自转分量也有同一反馈，原寻点器却正确排除了竖直动量，不能靠改变重心参考消除这条自转通道。

修正WPlane1：以机械轴/符号把每轴Kw*wheel+Ki*wheel_int转换为机体系，去掉沿当前控制参考重力的分量，再分配给电机；保持倾斜反馈的原强度、PG接管时刻、独立BYAW阻尼和单边公式。不是提高保护阈值。新生产C测试验证不同机械符号下纯竖直轮速输出为0、纯倾斜反馈不变、不同Kw/Ki时加权反馈仍无竖直分量、自转阻尼仍有效；原保护/遥测容量测试仍通过，50串口模拟/12窗口测试通过。

WPlane1已从默认CubeMX重建（38输入0错误0警告）并烧录校验。NTune3初版保存在592f998，当前HEX详情见review_manifest。用户已确认本次自检就绪，neutral5_plane_startup_prep01进行中。计划用第二轮最终22.94°/48.11°种子做8秒对照，其余80/5/-.04/yaw6/tau.25/5°/.3°每秒/6V/220rad/s/2rad/s不变。此修正仍需真机验证。

### WPlane1首轮8秒完成

`neutral5_plane_trial8s_03` 满8.000秒定时结束，无主机或固件保护。相对学习目标最大偏角1.268°、相对原锚点最大2.577°；三轴轮速范围M1[-28.92,12.18]、M2[-12.86,47.80]、M3[-18.27,28.75]rad/s，较修正前约190rad/s大幅下降。目标由22.94/48.11移至23.60/47.81、最终偏移2.012°，未碰5°边界。最终EN000已确认；停机后的大姿态/角速度变化不算控制期间失稳。现场自由释放条件沿用用户既定操作，不再次问同一条件，也不把hands_off_verified自动改为true。

下一组保持同参数、resume保留学习，延长至15秒；未将8秒结果称为长期稳定。

### WPlane1续测15秒完成

`neutral5_plane_resume_trial15s_04` 满15.000秒定时结束，无保护。学习目标最大跟踪偏角1.421°、原锚点最大2.876°；M1[-12.00,88.28]、M2[-36.10,14.68]、M3[-10.88,17.92]rad/s。轮速并非持续增长，末段已回落到个位数。目标23.60/47.81→23.36/49.05，最终偏移0.877°。读回EN000，保留学习。

为继续观察，将有限诊断的可设时长从最多15秒扩展至120秒；缺省仍3秒，所有逐帧倾角、角速度、轮速、遥测超时与最终STOP/失能确认保持不变。新增60秒模拟完成及运行中轮速越界立即停机测试，51项通过。无需烧录或再次校准。正在同参数60秒resume，neutral5_plane_resume_trial60s_05。

### WPlane1续测60秒完成

`neutral5_plane_resume_trial60s_05` 满60.000秒定时结束，无主机/固件保护、最终EN000。学习目标跟踪最大1.3335°，原锚点最大2.4454°，三轴M1[-61.27,16.66]、M2[-13.61,31.29]、M3[-32.12,14.57]rad/s；没有重现持续加速至超速。目标最终23.49°/48.20°、偏移1.649°。此为60秒有界观察，不能等同无限时长认证。当前同参数继续120秒resume：neutral5_plane_resume_trial120s_06，不重置已学目标。
