TDX33029/Cubli-STM32F407-ESP32/Firmware/Software/界面精简说明_2026-10-18.md

# 上位机界面精简说明（2026-10-18）

本次只修改上位机 `Software/main.py` 与 `tests/test_upper_computer.py` 及配套文档，**固件源码、烧录镜像、串口协议均未改动**，无需重新烧录或校准。

## 修改原因

1. 左侧界面包含大量单电机工作模式（三轴独立调速、同步联动、速度环 PID、开/闭环切换、单轴电角度对齐）控件，日常平衡操作不需要，界面复杂。
2. 平衡流程里只有“M1硬件自检”，缺少三电机校准入口；仅 M1 对齐时三轴 `Aligned` 不是 111，顶点平衡无法启动。

## 界面调整内容

左侧面板现为三段：**三轴自检/对齐互锁卡片 → 平衡控制 → 参数配置与驱动限制**。

### 移除（改为终端手动命令，协议不变）

- M1/M2/M3 单电机控制卡片（调速滑条/数值框、独立使能、换向）
- 三轴同步联动卡片（此前默认隐藏）
- 速度闭环卡片的开/闭环模式切换（`MODE`）、PID 在线整定（`PID`/`TF`）、单轴电角度对齐按钮（`ALIGN`）
- 运行模式下拉框（调试/工作 `APP`）、自检轴下拉框（`DBG`）
- 备用传感器切换按钮（`SENSOR`）与重复的“查询IMU”按钮

### 新增/变化

- **三轴自检/对齐**：自检卡片主按钮与平衡面板“三轴自检/对齐”按钮等效，点击后自动按 M1→M2→M3 依次发送 `TEST 1/2/3`，逐轴显示结果；单轴失败不中断其余轴，全部结束统一判定，三轴通过才解锁。停止/急停会中止检测。
- **自动模式切换**：上位机自动管理固件 `APP 0/1`——自检/对齐前自动 `APP 0`，启动平衡/倒计时/自动平衡前自动 `APP 1`，界面不再暴露该选项。
- **通道映射显示**：自检卡片新增一行 `通道映射: M1→ENCx(PPx) | ...`，由 `$STATE` 的 Map/PP 字段刷新。
- 右侧“M1/M2/M3 目标 / 实测转速”指标框改为显示实测飞轮转速。
- “复位停机锁存”按钮保留在平衡控制顶部（发送当前 `APP` 清锁存）。
- 参数区保留相电压限制（`U`）、极速限制（`L`）、遥测开关（`TELE`）、查询状态（`?`）、查询编码器（`HALL`）。

### 不变

- 平衡相关全部功能：BMODE 选择、CAL_IMU/BZERO、平衡启停、倒计时入位、自动平衡（BAUTO）、已验证配置加载、BAXIS/BDIR、平衡增益、BTRIP/BFULL/BCAP、遥测与波形、串口终端与自定义指令。
- 心跳、看门狗、互锁拦截逻辑（未自检时终端仍拦截致动类命令）。

## 验证

- `python tests/test_upper_computer.py`：38 项全部通过（含新增的三轴自检序列、合并判定、失败锁定、急停中止、自动 APP 切换、通道映射显示用例）。
- `python tests/test_pose_monitor.py`：12 项全部通过（姿态弹窗未受影响）。
- 固件 C 测试与串口模拟测试未运行，因为本次未改动固件与诊断脚本。

## 补充（同日晚些时候）：单点验证配置同步

此前的自动寻点单点调参是通过 `diagnostics/serial_corner_trial.py` 脚本完成的，参数一直没写进上位机，导致界面“加载已验证单点配置”仍按旧参数（80/5/−0.030/0、BYAW 3、BCAP 0.5、无寻点）运行。本次把实测参数组同步进 GUI，**同样只改上位机与测试**。

### 配置变化

- 已验证单点配置改为：三轴 80/5/−0.04/0、`BYAW 6`、`BATTAU .25`、`BCAP 1`、BTRIM 0、U/BU6V、L330、BREF 参考不变。
- 默认随配置下发 `BNEUTRAL 1 0.000075 0.3 5`（有界自动寻点，增益0.000075、速率0.3°/s、总范围5°）。
- 回读校验扩展：CapDeg 1.0、YawD 6.0、AttTau 0.25 及 NOn=1、NTune=3、NLimit/NGain/NRate 与下发值一致；任一不符继续等待状态帧，5秒超时停止。勾掉“启用自动寻点”时改为校验 NOn=0。

### 新增界面功能

- **寻点控制行**：启用开关、增益/速率/范围输入（与固件 BNEUTRAL 范围一致：2~5°、0.01~0.5°/s、5e-6~2.5e-4）、“重载配置时恢复学习目标”开关（把最近学习目标作为 seed，超出锥范围自动从锚点开始）。
- **固件寻点状态行**：显示 NOn 开关、当前目标 Pitch/Roll、偏移 NOff；关闭时显示记忆目标。
- **“启动限时平衡（到时自动停止）”**：发送 BSTART 2（单点）/BSTART 8（单边），接管（Bal=3）后开始计时，状态行显示剩余秒数，到时发 `BAL 0` 失能并保留寻点学习；保护停机（Bal=4）或急停取消计时。
- 解析器新增 NOn/NTune/NPit/NRol/NOff/NLimit/NRate/NGain/AttTau 字段及范围校验，非法帧整帧丢弃。

### 数据依据

参数与寻点组合来自 2026-10-18 的串口脚本记录（`diagnostics/2026-10-18/neutral5_plane_resume_trial8s/15s/60s/120s*`）：带监护限时运行全部正常计时结束，最长120秒无触发保护；不含长期无人值守自由平衡验证。

### 验证

- `python tests/test_upper_computer.py`：44 项全部通过（新增寻点命令与seed恢复、范围外跳过seed、关闭寻点跳过BNEUTRAL、限时运行计时/停止/保护取消、自动转限时、非法寻点字段丢弃等用例）。
- `python tests/test_pose_monitor.py`：12 项全部通过。
- 固件未改动，无需重新烧录。
