TDX33029/Cubli-STM32F407-ESP32/Firmware/diagnostics/2026-10-14/70mm机械参数与中午联调准备.md

# 70mm Cubli：机械参数补充与中午联调准备

用户已明确设备为了安全主动断电、人不在现场，中午再测试。本次只做离线计算和记录，没有进行串口、电机动作或烧录。板上最后校验的是20°停机版本；接管过渡版本已编译、尚未烧录。

## 已知尺寸与图纸差异

- 框架外边长70mm。
- 外环：304不锈钢，外径66mm、内径51mm、厚5mm。
- 用户描述内轮：外径20mm、内径16mm，同材料/厚度，与外环激光切割一体成型。
- 电机2804/220KV，单台质量未知；框架和主板合计约50g，整机尚未称重。

工程中的`Mechanical/2D/动量轮CAD.dxf`与外径66、外环内径51、内轮外径20吻合，含四根约2.5mm宽辐条、四个直径2.5mm螺孔。不过图纸**中心孔为12mm，16mm是四个螺孔的分布圆直径PCD**。用户描述的16mm可能对应实际中心孔，也可能对应螺孔分布圆，中午确认实物即可。原图纸未修改，下面保留两种情况。

| 计算对象 | 单轮质量 | 绕电机轴的转动惯量 |
| --- | ---: | ---: |
| 仅按用户两个完整圆环，未计辐条/螺孔 | 59.14g | 4.789×10⁻⁵kg·m² |
| 原DXF完整轮，中心孔12mm | 68.00g | 5.008×10⁻⁵kg·m² |
| 保留DXF辐条/孔布局，假设中心孔改为16mm | 64.89g | 4.993×10⁻⁵kg·m² |

密度取7930kg/m³。完整轮的两种孔径解释对质量影响约3.1g，对惯量影响约0.31%；外环主导惯量。内轮和外轮一体成型，因此后续不能只把内轮作为转动件计算。

计算使用闭合轮廓布尔运算，并核对了几何连通性和收敛；另以圆弧/直线的解析面积积分独立校验原DXF，质量和惯量相对误差均小于0.001%。这些数字仍不包含电机转子、螺钉以及材料/板厚公差。

## 整机质量与力矩需求

仅两圆环与50g框架/主板的名义小计约227g，电机、辐条和孔需另计。若沿用图纸辐条并按16mm中心孔计算，三轮约194.7g；加上框架/主板约244.7g，再加三台电机。不能继续把“三轮占整机2/3以上”当作已经称量确认的条件。

下表的电机质量是**条件示例，既不是实测值，也不是型号质量范围**。重力力矩以几何重心高度70/√2mm估算，采用短脉冲加速数据推算的电压力矩系数约0.00654N·m/V；还未计损耗、电流限制和旋转反电势。

| 假设每台电机质量 | 条件整机质量 | 补偿5°重力约需 | 10°约需 | 20°约需 |
| --- | ---: | ---: | ---: | ---: |
| 20g | 305g | 1.97V | 3.93V | 7.74V |
| 30g | 335g | 2.17V | 4.32V | 8.50V |
| 40g | 365g | 2.36V | 4.70V | 9.26V |

这说明此前1.5～2.5V限压对于稍大倾角可能没有足够恢复余量。飞轮已经较快旋转时，同方向继续加速还会消耗反电势余量，例如按实测前馈系数0.024V/(rad/s)，80rad/s约占1.92V。反向制动不能直接套用这个减法估计。

**20°是当前姿态停机设置，不是已验证的恢复角度。** 表中也不能据此决定直接满压试验：力矩为短时速度数据与惯量推算，尚无相电流/实测力矩数据。2804/220KV的母线KV与FOC相q轴电压系数不是同一个量，不能直接用标称KV替换代码中的q轴反电势系数。

图纸核对与条件力矩估算

## 重心零点优先于增益

用户给出1号面主板、2号面M3、3号面M1、6号面M2。M1→IMU Y已手动实测；估算中使用面2→−X、面6→−Z等关系，属于依据摆放与重力方向作的模型假设，不能替代另外两轴的安装验证。

三只较重的轮及电机集中在三个面，会让重心偏离几何中心。以各电机30g、质量位于面中心为例，将50g其他质量分别视为集中在几何中心、部分或全部位于主板面，可给出约56～61°的中性姿态示例。电机安装深度、主板/框架分布和实际所选支撑棱会改变该结果，**不能直接把这个示例范围编程为真实零点**。

此前约42.91°只是一条用户手扶采集的参考候选，55.6°也曾是靠着限位时的静止姿态，两者均没有经过自由响应确认。换一条同样平行M1轴的支撑棱，也必须重新核对零点。中午首先找实际重心位于支撑棱上方、松线且没有端点承重时的姿态，再采集BZERO。

## 离线反馈候选

结合70mm尺寸、上述惯量与短脉冲加速系数，按自由反作用飞轮的近似状态方程计算了一组极点配置候选；在“16mm中心孔模型、各电机30g、均匀立方体惯量”的条件下，约为：

`Kθ=60、K机体角速度=3.6、K飞轮=-0.034、Ki=0`

这是**离线初值，未自动下发、未改成固件默认值、未实机验证**。它假设正q电压产生正机体轴响应，对应程序机架方向−1；真正方向必须在无手扶/端点反力掩盖的响应中复核。极点仅针对完整增益、无饱和且已在真实零点附近的模型；不保证接管过渡或20°大角度时稳定。不同电机质量和图纸孔径的候选都保存在JSON中，供中午核对后逐步试验。

## 中午接回后的顺序

1. 接回USB串口、ST-LINK和12V供电，先确认三轴失能；对齐/标定参数掉电后需重新建立。
2. 烧录并校验已构建的`CubeMX-edge-handover/CubeMX.hex`；仅对齐健康M1，静止校准IMU。M2继续保持失能。
3. 确认实物中心孔是12还是16mm；有条件称整机总重即可，不强求逐件拆解。
4. 在限位中间核对真实重心零点和恢复方向；正常运行时限位端点不能承担支撑力。BZERO采集当前正确姿态，旧参考不直接当作已验证零点。
5. 新版PG6亮后机体反馈已经生效，移开支撑时飞轮反馈在0.5秒后、用1秒渐入；从小角度、短时限位试验开始，再逐级增加输出和时长。
6. 保留±20°姿态停机及速度、角速度、心跳、驱动和采样保护；目前真正越过20°的硬件触发仍未实测，不能把之前最大4.53°的零输出试验记成已通过。

复现离线计算：`python 无刷闭环联调/diagnostics/estimate_wheel_dynamics.py`。依赖ezdxf、shapely、numpy、PyQt5和pyqtgraph。数据为`wheel_and_body_estimate.json`，独立解析校验为`cad_numeric_verification.json`。
