TDX33029/Cubli-STM32F407-ESP32/Firmware/diagnostics/2026-10-14/三轴修复后复检.md

# 三轴修复后复检

2026-10-14，串口 COM7，115200，用户确认 12V 供电、三轴已修复。

本次上电初始 Aligned=000，重新逐轴对齐全部通过。映射 M1→ENC3、M2→ENC1、M3→ENC2；极对数均为7，编码器方向均为+1，与旧记录一致。电角度零位重新测得，不能沿用上次上电值。

逐轴2.5V限压、目标±5rad/s短时闭环：最后0.6秒平均速度分别为 M1 +5.080/−5.055、M2 +4.986/−5.082、M3 +5.065/−4.998rad/s。M2启动瞬间峰值约±7.6rad/s，稳态样本范围约4.7～5.42rad/s；尚未进行修复后的高速、快速换向测试。运行轴读取频率约6.37kHz，错误计数0。当前 EncType=0，为I2C读取，不是AB硬件计数实测。

全程失能、逐轴手动绕支撑棱摆动15秒的陀螺仪分析：

| 电机 | IMU轴 | 主成分方差占比 | 依据 |
| --- | --- | --- | --- |
| M1（M4） | Y | 旧验证 | 用户确认原M1仍正常 |
| M2 | Z | 99.89% | repaired_m2_body_axis.jsonl |
| M3 | X | 99.66% | repaired_m3_body_axis.jsonl |

机体力矩方向与编码器方向是不同参数。上述轴识别没有确认M2/M3的BDIR，尚不能宣称其已能单边/单点平衡。后续先在限位下逐轴测力矩方向、参考姿态和单边自由响应，再进行三轴单点联调。旧M1参考仅适用于原安装及支撑棱。

辅助脚本：`analyze_body_axis.py` 对失能采集做主成分分析；`serial_torque_probe.py` 新增串口、电机轴和IMU轴参数（M2/M3必须显式提供；旧M1命令仍默认Y），保留固件脉冲限时及其他轴失能检查；静止校准脚本支持指定串口。`serial_edge_trial.py` 同样支持逐轴，轮速、失能掩码、参考回读、增益、FAST和FREQ均选择该轴；旧M1专用起跳接管路径仍限于M1。

原始日志及稳态统计见同目录 `repaired_threeaxis_*`，轴识别见 `repaired_m2_body_axis*`、`repaired_m3_body_axis*`。

## M2力矩方向

静止校准是陀螺仪零偏校准，不要求水平；保持静止即可，不会将端点设为水平或平衡目标。

M2在限位端点、无手扶的+3V/60ms与−3V/60ms脉冲分别产生正Z与负Z反应。−5V/80ms再次产生负Z反应（峰值约−0.306rad/s、轮速约34.58rad/s），用户确认有无手扶起跳。因此M2恢复方向取BDIR2=−1。试验均由MCU定时结束，M1/M3保持失能。

第一次“参考已扶稳”实际仍靠在−53°端点，已排除该端点作为参考。明确手扶后采集得到候选Pitch=−51.055°、Roll=91.69°，记录为`repaired_m2_reference51_candidate.json`。该候选尚不能等同于真实重心平衡点。

首次5秒试验参数：LQR2=80/5/−0.045/0，U=BU=6V，硬轮速330rad/s、主机保护300rad/s、倾倒20°。试验按时结束，无故障；姿态和轮速几乎不动。需要现场确认是否真正松手且不接触限位，不能仅凭这组遥测判定自主平衡成功。

## M2硬面复测

用户说明首次5秒已松手，但使用软桌面；因此换成硬面再测。相同参数完成8秒、15秒试验，均按时停机，无保护触发。

| 时长 | 偏角范围 | 轮速范围 | 输出电压范围 |
| --- | --- | --- | --- |
| 8秒 | −0.65～+0.17° | −8.16～+17.61rad/s | −0.40～+0.87V |
| 15秒 | −3.20～+1.62° | −158.53～+93.89rad/s | −4.76～+2.44V |

8秒后用户报告“完全没有手扶保持立住”，可能有线材微小干扰，主动手动干扰时有复位动作。15秒后报告“自主复位效果明显，状态很好”。这构成M2单边恢复控制的短时实机证据；不能推定已排除每一瞬间的线材/限位接触，也未验证长期轮速不饱和。15秒末轮速约+79rad/s。

参数及现场反馈保存于`repaired_m2_edge_profile.json`；原始遥测和统计见`repaired_m2_hard_edge51_*`。结束后Auto=0、EN=000。

## 更换电池后的重新对齐

用户更换同规格电池并确认供电条件不变；设备复位后Aligned=000、Cal=0，软件记录仍保留。首次2.5V重对齐M1通过；M2测得PP_est=6.48，M3静止角度散布0.076rad，均按原有阈值拒绝使能。

让用户保持机体静止、飞轮无接触，以3V校准限压重试M2/M3，分别PP_est=6.81、6.71，均通过7极对判定及静止检查。映射和编码器方向未变，随后静止校准成功，最终Aligned=111、Cal=1、EN=000。记录见`repaired_after_battery_*`。首次失败原因尚未独立定位，不将其归因于某个确定硬件故障；未放宽校准判定。

## M3方向与未成功的单边调试（继续至10月15日）

M3→IMU X。正/负短脉冲分别产生正/负X反应。进一步从Pitch≈45.78°静止端点施加−6V/100ms和120ms，角度向较小Pitch变化并返回原端点；用户明确确认全程无手扶、有回弹。保留BDIR3=−1。轮速峰值约63/69rad/s，脉冲由MCU限时结束。

37.53°手扶采集参考、41.53°探索参考分别进行5秒试验；用户随后说明41.53°试验没有松手，故两组轮速积累不能作为自由平衡成功或可靠中性点依据。关闭轮速反馈的3秒试验也未稳定，现场松手/接触情况未能确认。

38.5°参考、80/5/−0.045/0的自由试验在约2.5秒触发主机角速度2rad/s保护。用户说明已松手、短暂平衡后失控由线材接住。要求修正两侧限位、避免线材承重后，用户确认修正。轮速项减至−0.030后再次试验，约3.42秒触发固件20°倾倒保护（BReason=1）。均已失能，未提高任何保护阈值。

现阶段M3恢复方向有独立脉冲证据，但单边平衡尚未成功，不能进入三轴单点实机测试。下一步零输出松手，取得自然倾倒方向，再修正参考/增益。离线拟合已有含接触/手扶及高速振动的记录未得到符合倒立摆符号的可靠参数，未采用拟合结果设置目标。

脉冲脚本已补充：无论是否指定预期端点角度，均必须收到新鲜STATE、其他轴失能、轮速接近0、至少5个静止角速度样本才允许发脉冲。

## M3零输出与34°候选短时成功

零输出试验中U3始终0、飞轮基本不转，机体约35°附近仍向较大Pitch自然加速；约0.94秒触发角速度保护。对初始自由段估算得到中性角约34°（非可靠机械中性点标定）。用户随后说明因线材拆除了限位，靠手在倾倒后接住/扶回；后续扶回段不能用于估算，也不能将此试验描述为全程无接触。

改用34°候选、LQR3=80/5/−0.030/0、U=BU=6V、硬轮速160rad/s、主机150rad/s、20°倾倒保护，分别完成3秒和8秒。用户确认3秒期间正常平衡、结束后才手动纠正；8秒反馈“平衡正常，我没有介入”。

| 时长 | 偏角范围 | 轮速范围 | 输出电压范围 |
| --- | --- | --- | --- |
| 3秒 | −0.97～+2.21° | −127.49～−2.29rad/s | −4.53～−0.98V |
| 8秒 | −0.62～+2.08° | −78.71～+113.25rad/s | −2.94～+3.07V |

两轮均按时停机，无保护触发。成功参数及现场反馈保存于`repaired_m3_edge_profile.json`。当前外挂电池的安装方式尚待用户说明；电池位置变化会改变平衡参考与惯量。短时单边成功不等于长期动量不饱和，也不等于三轴单点成功。

## 单点首轮与程序支持

用户确认外挂电池牢固固定于机体、随整机转动。单点静止候选约Pitch=23.56°、Roll=46.79°。首轮限时脚本配置三轴轴映射2/3/1、方向−1/−1/−1，限压3.5V、3秒，轮速100rad/s主机保护。实际手扶采集参考变为27.39°/50.38°，与最初候选有偏差；M2超过100rad/s后停止，停止前记录的姿态偏离最大约3.06°。用户说明立即松手，要求复测；第二轮尝试时CH340断开，没有发出任何驱动指令。换线前后均保持失能。

为固定目标和改善观测，新固件加入：单点BREF归一化参考加载；BSTART支持三轴逐一检查、入位/离位及MCU灯光倒计时；单点FAST包含全姿态角速度、Pitch/Roll和倾角，并扩大TX空间预留，避免报文截断。BAUTO仍只允许单边。重新自检无论成功/失败均撤销该电机机体方向确认、该边沿与单点参考，其他边沿保留。

STATE新增CornerStart=1能力字段。上位机据此解锁单点倒计时按钮，旧固件保持禁用。限时单点脚本支持新固件快速遥测/倒计时/固定参考，同时保留旧固件的主机等待和普通遥测兼容路径。

验证：固件与UART模拟测试通过；上位机34项、单点脚本8项测试通过；ARMCC编译38个输入文件、0错误0警告。产物为`Cubli-ST/MDK-ARM/CubeMX-corner-countdown/CubeMX.hex`，独立目录。编译及SHA256见`corner_firmware_validation.json`。

基于M1的49°和M3的34°投影得到单点探索参考，见`repaired_corner_reference_from_edges_candidate.json`。这是尚未验证的候选，尤其M1记录早于换电池，不应视为重心标定或单点成功结果。

新版固件已由STM32CubeProgrammer烧录并校验成功，启动回读CornerStart=1、默认三轴失能。M1/M3重新对齐通过；M2首次6.39未通过，重试6.96通过。用户随后说明M2一侧可能压在桌上，并要求重新悬空测M2；该次测得6.85并通过，当前Aligned=111、Cal=1、EN=000。未放宽极对数判定。记录与校验日志已保存。

固定单点参考试验接管约2.344秒后触发1.5rad/s角速度保护。倾角最大约2.58°；触发前总角速度1.515rad/s，其中竖直自转分量约−1.508rad/s，倾斜角速度约0.147rad/s。用户确认及时松手、无须线材支撑，前半段平衡良好但有自转。三轴轮速系数统一−0.030后的复测约0.719秒触发保护，尚未稳定。

加入独立自转阻尼BYAW（失能时0～10），默认由0.3增至3.0；STATE增加YawD/YawTune供回读确认，脚本可单独设置该参数。验证了阻尼输出确实反抗竖直角速度、活动期间拒绝修改、超界值拒绝。上位机34项、单点脚本10项、固件/UART模拟测试通过，38输入文件0错误0警告；新产物使用独立目录`CubeMX-corner-yaw`。增加阻尼后的实机效果尚待验证。

用户确认三轮悬空后，重对齐M2仍曾出现PP_est=6.28。代码检查发现开始仅固定等待500ms，未验证扫描起点静止；同电角度扫描前后相差约0.095rad。新增起点/前向终点/反向终点的静止检测：连续两个80ms窗口角度散布≤0.02rad，窗口平均差≤0.01rad，每个端点最多等待1.6秒，超时或读取失败拒绝对齐。原极对数判定不变。最终零位取已经稳定的反向终点均值。模拟移动后静止、持续移动超时、读取失败均已验证，ARMCC零错误零警告。新产物为`CubeMX-corner-yaw-settle`；限时自检脚本对单轴对齐等待上限调整为15秒。

该版本已烧录校验成功，三轴重新对齐一次通过，估计极对数7.14/7.02/6.86，随后IMU校准完成。自转阻尼3.0使总角速度明显下降；6V限压改善恢复输出，但49°参考下M1持续积累到150rad/s触发保护。

## 首组单点3秒成功

单点参考从Roll49°修正到50°，保留M3方向的Y/Z重力比，目标重力向量为[-0.7028287888,0.3977869309,0.5897433775]，Pitch≈23.4399°。三轴LQR=80/5/−0.030/0，BYAW=3，U=BU=6V，硬轮速170、主机150rad/s，主机倾角10°/角速度1.5rad/s，固件倾倒20°，MCU8秒倒计时。

`repaired_corner_roll50_yawd3_u6_trial1`按时完成3秒，无保护触发，149个运行FAST样本，总倾角最大约1.81°。轮速范围M1 −54.73～+17.52、M2 −120.63～+38.86、M3 −81.04～+5.15rad/s。用户确认“短时间内保持平衡，没有手扶和任何外界干扰”。保存为`corner_balance_verified3s_profile.json`，不能推定已经长期稳定。

用户随后更换电池并复位，并明确从整个对话开始所有电池参数、固定安装方式完全相同；后续默认不变，除非用户另行说明。复位后补做对齐与静止校准。单点脚本默认轮速系数统一−0.030，允许分阶段设置主机轮速30～250rad/s，默认仍100，其他保护不变。

换电池后再次三轴对齐一次通过（6.80/6.59/6.82），IMU校准完成。5秒尝试未跑满：初始偏角约2.8°，约1.219秒M3达到150.65rad/s触发主机保护；触发前倾角约1.2°、总角速度约0.264rad/s。尚未获得5秒自主单点结果。

用户指出实际重心与几何中心差异大，初始扶持角度影响接管。新增只读`Software/pose_monitor.py`显示实时Pitch/Roll、候选目标、2°入位圈、轮速和运行状态；窗口可记录失能姿态候选，不控制电机。调试脚本可发布实时姿态文件，显示失败不影响控制；新鲜度按姿态实际接收时间标记，状态报文不会刷新旧姿态的时间。已做示例渲染并验证中文字体。单点脚本显式BCAP=2收紧入位；串口模拟10项通过。

只读窗口定位后，用户记录扶持力最小候选Pitch23.55°/Roll49.86°，距成功参考约0.17°。“0,0”表示误差接近零，不是姿态角为零。读取窗口由30秒采样改为最多3分钟或记录新候选后结束；整个过程三轴失能。

## 单点5秒成功

`repaired_corner_roll50_capture2_bound220_trial5s`完整完成5秒，无保护触发。固定参考仍Pitch23.4399°/Roll50°、三轴80/5/−0.030/0、BYAW3、6V；BCAP2，主机轮速220、固件硬轮速240rad/s，主机倾角10°/角速度1.5rad/s，固件倾倒20°。250个受监测FAST样本，总倾角最大约0.976°，角速度最大约0.146rad/s，自转角速度最大约0.122rad/s。

轮速范围：M1 +1.30～+107.99、M2 −12.22～+41.15、M3 −41.04～+32.12rad/s。三轴控制电压范围：M1 0.17～3.07、M2 −0.55～1.65、M3 −1.45～1.03V。用户明确确认“无手扶、无线材干扰、全程无干预”。备份`corner_balance_verified5s_profile.json`。尚未证明长期动量稳定。

单点限时脚本允许最多15秒，默认仍3秒；补充非有限数遥测保护，串口模拟11项通过。接管后的日志阶段明确标为corner_run；下一步10秒复测。
