TDX33029/Cubli-STM32F407-ESP32/Firmware/diagnostics/2026-10-14/联调结论与平衡准备.md

# 2026-10-14 串口实测、快速变速修复与平衡准备

后续已完成高转速测试，并修复追加使能第二轴的反馈过期问题；最新固件、150～180rad/s未通过项、双轴120rad/s收尾结果及M2迁移步骤见[高转速实测与M2迁移](高转速实测与M2迁移.md)。下文保留此前低速联调阶段记录，当前源码/HEX哈希以`highspeed_verification.json`为准。

本次通过COM9（CH340）、115200/8N1实际调试旧板USART2，并通过ST-LINK备份、烧录及读回校验诊断修复固件。测试使用用户确认的12V电机供电，运动实验将Uq限制为2.5V，主要验证±5/±10 rad/s和每100ms切换方向。没有进行180 rad/s运行、长期温升或实际机体平衡实验。

## 电机编号

| 用户称呼 | 程序/串口编号 | 驱动 | 实际编码器通道 | 当前结论 |
| --- | --- | --- | --- | --- |
| 侧面M4，刚才最先转动的一台 | M1 / EN1 / TEST 1 | TIM1，PD0使能 | ENC3 | 7极对数扫描、闭环与快速变向通过 |
| 侧面M2 | M2 / EN2 / TEST 2 | TIM3，PD1使能 | ENC1（映射实验所得） | 准静态换相扫描失败；暂不继续驱动 |
| 顶层电机 | M3 / EN3 / TEST 3 | TIM4，PD2使能 | ENC2 | 7极对数扫描、闭环与快速变向通过 |

未自检的轴仍显示初始默认映射，例如最后重启后M2未再次自检，STATE中的Map2=2只是初始化值，不能替代上表的实测映射。对应Aligned位为0，控制卡保持锁定。

用户补充：曾发生三台电机堵转严重发热约十分钟；M2与M4位于侧面。测试后现场反馈未再出现明显高频震颤/卡转，M4切换时有轻微声响，顶层电机无声。声响是用户现场观察，本次未采集声音或振动传感器数据。

## 实测与定位

### M2异常

旧版自检能检测到M2→ENC1，却仍把M2判为对齐成功。在2 rad/s闭环测试中，M2实测均值约−0.076 rad/s，输出已饱和到2V；同条件M1/M3约为1.96/2.02 rad/s。

新增双向电角度扫描后，M2在2.5V下正向/反向机械位移约−0.178/+1.048 rad，严重不对称。放慢扫描并提高到3V后，中间位置仍来回跳变，辨向在不同试验中改变，极对数估计出现62.89这种不可信结果。新程序因此拒绝对齐并禁止正常使能，不再给出假成功。

正常M1/M3的相同扫描单调、往返一致，估计极对数约7.28/6.97，与配置7一致。M2异常不能仅归结为串口波形刷新频率；结合长期堵转过热史，需要检查绕组/相线、DRV8313输出和磁铁/编码器安装，当前证据尚不能确定损坏的是哪一个部件。用户表示焊接不便交换，硬件隔离留到明天。

### 采样与阻塞

| 状态 | 每轴平均采样率 | 最大采样间隔 | 单次I2C读取 | I2C错误 |
| --- | ---: | ---: | ---: | ---: |
| 修复前单轴M1 | 7175 Hz | 1561 μs | 126 μs | 0 |
| 修复前单轴M3 | 7188 Hz | 1572 μs | 124 μs | 0 |
| 快速格式化后单轴M1/M3 | 约7320～7340 Hz | 约360～402 μs | 约125 μs | 0 |
| 最终双轴同时M1/M3 | 各3666 Hz | 531 / 532 μs | 126 μs | 0 |

原程序UART发送虽然异步，`printf %f`的浮点转换仍会阻塞主循环。最大间隔1.57ms在180 rad/s、7极对数时相当于约113°电角度。现在TELE、STATE、FAST和FREQ采用有界定点格式化，避免长时间浮点转换；关闭遥测时也不在运行中打印慢速浮点调试行。

这修复的是采样/换相抖动，不是把上位机曲线刷新改快。I2C仍为400kHz，硬件正交方法保留，本次实机始终使用I2C。

### 快速变速参数

实测稳态5/10 rad/s所需Uq后，M1/M3采用下列值；M2未整定，保留旧参数等待检修。

| 参数 | M1（用户M4）/M3 |
| --- | ---: |
| PID P / I / D | 0.30 / 0.80 / 0 |
| 速度反馈低通Tf | 0.004 s |
| 摩擦前馈 | 0.12 V，使用tanh平滑过渡 |
| 反电势前馈 | 0.024 V/(rad/s) |
| 速度目标最大斜率ACC | 400 rad/s²，仍可配置100～1500 |

原参数在±10 rad/s阶跃中观测到约14.5～15.5 rad/s峰值。整定后单轴约10.5～10.7 rad/s。最终双轴100Hz抓数中M1范围−10.67～+10.67，M3范围−10.70～+10.55 rad/s；测试中无运行故障/停机。

两轴同时每100ms换向的抓取共716帧，帧间隔中位数10.061ms、最大10.272ms。43次斜坡参考过零均找到实际速度过零，延迟中位数M1为21.58ms、M3为21.65ms，最大约23～24ms。这是相对于**斜坡后参考速度过零**的滞后，不是整个+10到−10动作的总时间；400rad/s²的参考斜坡本身约50ms。

实测曲线

上排原/新参数对比均已启用快速遥测格式化，采用25Hz遥测；下排为最终固件双轴同时运行的100Hz数据。原始日志、汇总和计算结果均保留在本目录。

## 源码修复

- 默认启动改为闭环且三路硬件失能，所有正常使能均要求该轴对齐成功。开环仅限低速调试，默认上限10 rad/s、斜率不超过100 rad/s²；闭环仍保留180 rad/s可设置范围。
- 自动映射后增加慢速正/反电角度扫描、配置极对数核验、静止稳定性验证和多样本电角度零位平均。校准电压不超过用户当前U限值。
- 支持逐轴极对数：PP1/PP2/PP3，默认7；修改后必须重新对齐。异常扫描不是建议把M2改成63极对数。
- 删除“持续饱和且速度误差大”就锁到1.8V的逻辑。该条件会把正常加速或跟不上过高目标误判成堵转。持续低速堵转仍锁存停机，5ms未更新编码器也会失能。
- 停机/重新使能复位斜坡时间戳，避免旧时间差造成初次目标跳变。
- I2C失能滑行时按轮询约333Hz采样，减少原25Hz单圈读取的速度混叠。
- 新增FREQ诊断和100Hz紧凑FAST抓数；保持原TELE字段及USART2通信。
- 平衡模式要求校准IMU、明确确认轮轴/机架方向、采集目标重力姿态。捕获窗口内需低角速度保持100ms，跌倒保护仍锁存而不自动重启。
- 新增BAXIS轮轴到IMU轴的配置及上位机入口；改变映射后需重新确认BDIR并采集BZERO。未确认的默认轴映射不会直接允许启动平衡。
- 上位机显示实测编码器映射/极对数，并保持三轴独立调试。原单电机互锁/USART1测试断言已适配当前三轴/USART2版本。

## 当前平衡能力与开始条件

**电机闭环、IMU姿态、200Hz状态反馈、高速FOC、使能互锁及保护链路具备；实际稳定平衡尚未验证，当前不具备开始三轴顶点平衡的条件。** M2扫描未通过；默认增益也未基于本机质量、重心、惯量与电机参数求解/整定，不能将调速阶跃测试等同于平衡测试。

当前静止IMU校准已实机完成（Cal=1、IMU=1）。但目前重力主要沿IMU X轴，程序默认轮轴映射仍为X/Y/Z；结合顶层电机位置，轴映射必须现场验证。仅改变编码器方向或采集零点不能修正错误的轮轴对应。

准备在健康的M4（程序M1）或顶层M3上先调**单边沿**时：

1. 停机，在对应飞轮轴方向缓慢转动机身，观察Gx/Gy/Gz哪个轴响应，确定每个轮轴对应的IMU轴。BAXIS参数是三轴排列，X=1、Y=2、Z=3，不应照抄未经验证的默认值。
2. 确认机架正方向BDIR。它表示正电机电压对应机体哪个旋转方向，与FOC编码器方向是两件事。
3. 切工作模式，选择BMODE 1（M4/程序M1）或BMODE 3（顶层M3），设置已核实的BAXIS、BDIR，保持静止执行CAL_IMU。
4. 扶住机体放在实际支撑边平衡点，执行BZERO采集目标姿态。不要把任意桌面平放姿态当作平衡点。
5. 首先在扶持条件下、低BU限压验证恢复力矩方向，再整定倾角/角速度/飞轮反馈增益。当前没有执行BAL 1，没有让机体自由平衡。
6. 顶点平衡需M2硬件修复并通过同样的电机扫描与动态测试，再确认完整三轴安装映射及参数。

本工程仍无有效相电流、温度和母线电压反馈。此次低压短时测试和软件保护不能证明180 rad/s或长时间运行的温升安全性；存在严重过热史的M2应先做断电相间电阻比较、相线/驱动及磁铁检查。

## 固件、备份及最终设备状态

当前已实际烧录并校验的固件：

`Cubli-ST/MDK-ARM/CubeMX-motor-diagnostics/CubeMX.hex`

正交备用构建（未烧录，接好AB且参数正确后再用）：

`Cubli-ST/MDK-ARM/CubeMX-motor-diagnostics-quad/CubeMX.hex`

烧录前已读回完整1MB Flash备份：

`D:/Document/tempPrj/Cubli-F407ZGT6/.codex-debug/20261014/firmware_before.bin`

结束时COM9已释放，三台驱动EN=000、Bal=0，正常调速模式为闭环；保留本次台架限压2.5V、速度上限15 rad/s。停机码Trip=1来自主动STOP锁存，不是本次出现了驱动故障；Fault=0。标定状态Aligned=101，M2保持未对齐。轮轴/机架方向未确认、目标平衡姿态未采集（AxesOK=0、DirOK=0、Ref=0）。掉电后RAM标定/设置失效，需要重新执行。

请重启上位机加载更新的Python代码。当前原始CubeMX-threeaxis-speed HEX不是本次最终诊断修复版。

## 验证与文件

- ARMCC两种方法各38个输入，0错误、0警告。
- 生产控制C回归通过：三轴命令、50ms斜坡、真正堵转与正常旋转饱和区分、采样过期停机、双向对齐/极对数不符拒绝、轴映射、平衡捕获与锁存。
- 生产UART接收/发送与有界格式化回归通过，含负数/小数和32位边界。
- 正交/I2C兼容、每轴CPR及TIM7边界测试通过。
- 上位机16项回归通过。
- 本目录 `verification.json`记录最终源码、HEX、固件备份、原始串口日志及曲线的SHA256。

常用新增诊断：`PP?`、`PP1 7`、`FREQ 1`（重置统计）、`FREQ?`（采样率/最大间隔/读取耗时/错误）、`FAST 5`（M1和M3紧凑速度/电压抓数）、`FAST 0`（恢复普通遥测）。FAST是串口诊断流，带宽有限时允许跳过整帧，时间以帧中T为准。
