TDX33029/Cubli-STM32F407-ESP32/Firmware/diagnostics/2026-10-14/边沿平衡试验.md

# 2026-10-14 单边沿平衡调试记录

## 当前已确认与尚未确认的事项

M4对应程序M1/TIM1/ENC3，7极对数。用户选择与该电机轴平行的支撑棱。15秒失能手动倾斜记录中，Gy标准差约4.95°/s，Gx/Gz约0.23/0.27°/s，因此M1的实际旋转轴为IMU Y，使用`BAXIS1 2`。此前默认M1→X不适合本机安装。

用户给出的六面布置：1号面为主板，IMU正面朝外；2号面为M3；3号面为M1；6号面为M2。本轮没有把其他两台的轴和机架方向标记为已确认。机体姿态由IMU取得，飞轮位置由MT6701取得；本轮轴映射结果不能用来断言所有位置显示或编码器都已正确。

**恢复力矩方向仍未可靠确认，自由平衡尚未成功验证。** 早期手扶弱脉冲得到的−1判断、之后因现场感受改成+1的判断均不能作为最终安装方向。用户最新明确表示反作用太小，先前感受可能受到串口等线材影响，撤回此前方向结论。下一步采用物理限位，保留绕支撑棱的小角度摆动，放松线材后用更明显的短时正反对称脉冲重新测方向，再整定增益。不得照抄历史试验中的BDIR作为已验证配置。

## 已实现并实机运行的流程

当前20°阈值固件为`Cubli-ST/MDK-ARM/CubeMX-edge-trip20/CubeMX.hex`，ASCII留档`.codex-debug/20261014/edge_trip20_i2c.hex`。此前`edge-torque-probe`与`edge-waitpose-wide`为前序功能阶段留档。

1. 静止校准IMU。手扶晃动会令校准重新计数，实测应放在桌面静止后执行。
2. 对所用电机重新对齐，仅确认该轴的BAXIS与机架方向。`BAXIS1 2`和`BDIR1 +/-1`只确认M1，其他轴不会被顺带解锁。
3. 手扶到真实平衡点，以`BZERO`采集一次固定目标；程序不会自动追随之后的偏移姿态。
4. `BSTART 8`进入失能等待。进入目标±10°附近、短时低角速度后开始8秒倒计时。倒计时期间离开窗口即取消并回到等待；小幅晃动不再直接取消。
5. 倒计时末尾，需处于约±3°内且角速度低于0.2rad/s持续至少0.5秒，随后才接管。`BCAP 2..10`可在失能时调整入位窗口。
6. 实际运行后，选定边沿误差或完整重力姿态偏差超过配置角度（按用户要求更新为20°）、机体角速度超过3rad/s、传感器/心跳/采样过期等会失能。跌倒锁存，不会自动再次运行；明确重新启动才可复位。

灯光：PG5为倒计时（末秒快闪），PG6为实际运行，PG7为跌倒/故障停机，PG8窗口内闪烁表示需进一步靠近或扶稳，常亮表示接近目标且角速度较低。用户要求的“离位取消→回归重新计时”已在第四次实机试验观察到多次5/6状态转换，当时始终失能。最新固件将入位窗口扩大为10°，并将倒计时取消条件与末尾接管稳定条件分开。

边沿控制仍是电压域状态反馈，缺少有效相电流反馈。短时限位试验不能替代实际动力学识别或证明自由平衡稳定。

## 阶段试验

全部通过COM9/115200操作，M2和M3始终失能。每次脚本结束均发送STOP、恢复限压2.5V/速度上限15并释放串口。RAM配置掉电失效。

| 记录 | 条件与结果 |
| --- | --- |
| `edge_pose_identification.jsonl` | 失能15秒手动倾斜，确认M1对应IMU Y |
| `edge_direction_probe_held*` | ±5rad/s、ACC100、1V弱脉冲；手扶反应较小，方向推断已撤回 |
| `edge_first_held_trial*` | −1方向，1.5V，增益20/1.2/0.02/0；扶持运行5秒，约2°误差后主动STOP；不是自由平衡证明 |
| `edge_second_held_trial*` | 未持续进入保存目标的5°窗口，未使能，超时STOP |
| `edge_third_held_trial*` | −1方向，运行约7.6秒后超过脚本40rad/s观察界限而停机 |
| `edge_fourth_held_trial*` | 多次入位、倒计时、离位回等候，未进入运行；暴露5°窗口与晃动条件过于敏感 |
| `edge_wide_fifth_held_trial*` | 最新10°流程，−1方向，运行约2.6秒，达到55rad/s脚本界限；1.5V饱和，未稳住 |
| `edge_sixth_direction_corrected*` | 改+1后机体仍平放，保持失能等待，超时STOP |
| `edge_seventh_direction_corrected*` | +1方向，运行约9.1秒，达到脚本8°倾角观察界限而停机；不能据此证明方向正确 |

早期工作模式FAST名义100Hz与状态帧共同占用115200带宽，存在串口队列延迟；最新版本改为工作模式FAST约50Hz，调试模式仍约100Hz。所有控制/保护在MCU上执行，脚本界限是额外台架限制。主机先于15°固件保护停机的试验不能记成“固件跌倒保护已实机触发”；该保护已通过生产C回归，真实受控倾斜触发尚待核对。

## 当前回归和提交范围

各阶段I2C/正交构建均38个输入，0错误、0警告。生产控制C/UART回归、正交/I2C兼容回归通过；最新上位机18项回归通过。覆盖单轴确认不解锁顶点、失能等待/倒计时、离位取消并保留固定参考、末尾未稳定不使能、STOP/心跳取消、偏离支撑轴方向的跌倒锁存等。

当前源代码、上位机和诊断脚本是已完成的功能块。Keil原有生成目录、用户的IDE工程配置修改、缓存、Flash备份及中间构建文件继续保留在工作区，不混入该功能提交。用户已要求后续每个完成块或有进展即提交本地commit。

## 物理限位与定时力矩探测

用户已布置约±30°物理限位，并授权自主调整。±20rad/s、ACC400、2.5V、150ms速度脉冲确认飞轮能正常加速，但机体变化仍很小，不能据手感确定方向。

新增`BPROBE volts ms`：20～120ms、幅值不超过3V与全局U限压，先真实读取传感器并确认所选轴对齐及IMU校准。无需猜BDIR即可测量。F4的快速电机循环检查截止时间并自行切断输出；主机不是脉冲持续时间的唯一保证。相对探测起始姿态变化超过10°、机体角速度超过2rad/s、飞轮速度超过60rad/s会提前停机。探测中抑制大型周期STATE，FAST为100Hz并带Wx/Wy/Wz，避免短脉冲被25Hz普通遥测漏掉。

`edge_fixture_timed_torque_probe*`完成±1V/80ms、±1.5V/80ms、±2V/60ms、±2.5V/50ms共8次实测，每次F4均自行结束并回到EN=000。正脉冲初始Wy通常为正、负脉冲初始Wy通常为负，较强两对支持以−1作为下一轮闭环候选；响应仍存在限位接触和弹性振动，不能直接宣布方向最终确认。该块的生产C测试包含无主机STOP时80ms自动结束、负脉冲、未确认轮轴拒绝、探测姿态超限停机。

机体在限位支撑时约55.6°，此前手扶目标约44～45°。用户已将机体扶回限位中间，后续才开始提高目标附近的电压指令增益并复核恢复效果。已完成的流程已按功能块提交，当前提交记录见文末。

## 加力、参考偏置与限位端点

定时力矩探测块已提交。随后试验将倾角增益20→70、机体角速度增益1.2→2.4，U/BU=2.5V，飞轮反馈仍为0.02。`edge_fixture_gain70_dirminus`完成约12秒运行，误差0.03～0.07°、飞轮几乎静止、Uq约0.03～0.08V，FREQ约6454Hz、最大间隔446μs、错误0。由于姿态没有扰动，该记录不能证明自由平衡。

`edge_fixture_gain70_offset_plus1`在同组增益下加入1°参考偏置，运行约4秒：误差仍为0.92～1.13°、末值0.94°，飞轮约25.7rad/s、末尾Uq约0.64V。机体实际偏移仅约0.06°。用户随后明确说明此前一直靠在限位端点；因此这些数据用于受约束的电机/流程检查，不能当作自由机体的恢复响应。2°偏置那次未满足接管窗口，始终失能。

限位下响应

接下来必须扶在限位中间保持到PG6接管，再逐渐松手。轮轴角度与程序使能正常，不代表贴着限位时能整定平衡增益。

另对飞轮速度反馈作了模型检查：用相对轮速、包含反电势的简化自由反作用飞轮模型，当前`u=机架项-Kw*轮速`的正Kw与反电势共同产生不稳定模态。`wheel_feedback_model_check.json`保存示例参数与极点，Kw=+0.02时存在+2.796/s极点，Kw=−0.03时该示例模型极点实部均负。模型参数不是本机辨识结果，不能用这些极点证明硬件稳定；该检查用于确定后续试验应复核反馈符号，而不是只提高倾角增益。

## 20°阈值与下一阶段

加力数据块已提交。试用90/5/−0.03/0时，约0.89秒即达到80rad/s脚本速度界限；当时倾角不到1°，因此该次停机不是角度阈值触发。手扶接管和限位受力使该次不能直接用于判断自由模型的稳定性。

用户要求将姿态停机阈值扩大到±20°。已加入`BTRIP`失能配置、STATE的TripDeg回读和上位机设置入口，默认20°；生产C回归确认约17.2°仍运行、超过20°失能。其他速度、角速度、驱动、采样与心跳保护仍保留。

重烧录后重新校准时若机体在动，Cal会保持0并拒绝启动。新增`BREF`可从此前用户手扶的真实目标恢复参考；`edge_saved_reference.json`记录源日志、约42.91°的保存姿态与单位重力向量，避免在靠限位静止校准时误把端点采成平衡零点。恢复参考仍要求当前轴/机架方向明确确认、IMU已校准且全部失能。

注意：保存的是用户手扶时的**参考候选**，不是已经辨识出的重心零点。后续新增轮质量与面分布信息表明几何45°不一定是实际平衡点。

## 飞轮尺寸与接管过渡块

用户确认飞轮已锁紧：外环304不锈钢，外径66mm、内径51mm、厚5mm；内小圆为电机螺丝固定轮，电机2804/220KV。整机3D打印框架，用户估计三只动量轮占整机质量2/3以上，但未提供实测整机质量、内轮惯量与框架边长。

按密度7930kg/m³，单外环质量约54.65g、转动惯量约4.753×10⁻⁵kg·m²，三只外环总重约163.96g，未计内轮和电机转子。对短时定时脉冲作粗略回归，电压加速度系数约131rad/s²/V，按外环惯量推算力矩系数约0.0062N·m/V；这是短样本推算，不是电流/力矩传感器测量。分别见`wheel_geometry_estimate.json`、`motor_pulse_identification.json`。

三个较重的轮在2/3/6面不对称分布，会影响重心。仅在“三轮等重、其余质量位于几何中心”的简化模型下，轮质量占比2/3～1可给出约57.5～63.4°的中性姿态估计；主板、电机、内轮和线材可显著改变结果，**不能直接把这些模型角度写成已验证零点**。此前43°手扶候选与55.6°限位支撑姿态也都不能未经自由响应核对就认定为真实平衡点。

新增接管过渡：机体PD反馈立即生效，飞轮速度/积分反馈在接管后前0.5秒暂不加入，再用1秒逐步加入；轮速积分从过渡结束后才累积。这用于减小手还在托住机体时飞轮反馈产生的快速升速，不是自由稳定性的证明。生产C回归核对轮速项无突变、连续到达设定输出。FAST/STATE新增有符号Angle，避免只有绝对倾角无法判读方向。

主机脚本也修复了等待入位的总超时截短实际运行时间的问题；零输出保护检查可延长观察，并可保留已确认失能的固件跌倒锁存。第一次20°实机核对最大倾角仅约4.53°，未越界，因此**实际20°触发仍未验证**，不能将该次超时STOP记为跌倒触发。

`CubeMX-edge-handover/CubeMX.hex`为本块新构建，生产C/UART与上位机18项回归通过。烧录时USB连接丢失，系统仅剩蓝牙COM3/COM4，没有CH340和ST-LINK；**接管过渡版尚未烧录，板上最后成功校验的是CubeMX-edge-trip20版本**。最后成功回读为EN=000、Fault=0、Trip=1、TripDeg=20.0。恢复USB后才能继续烧录与自由响应实测。

## 当前Git功能记录

- `baf02a5`：初始逐轴诊断与控制整定。
- `945725d`：高转速实测记录。
- `1d0c7d9`：单边沿姿态与电机诊断流程。
- `1188ee1`：定时力矩探测、扶持试验及20°阈值。
- `f680a83`：接管时渐入飞轮反馈、带符号倾角与飞轮参数估算；已构建，未烧录。

旧阶段记录中的提交标识以此处当前可回溯的Git历史为准。代码构建、实际烧录与实机验证是不同状态，不能仅凭提交存在推断已上板验证。

## 设备断电后的机械参数补充

用户确认目前人不在现场、设备已主动安全断电，中午再测试。补充框架70mm、内轮内径16/外径20mm、与外环同材质厚度并激光一体成型、框架和主板约50g。已完成离线CAD核对、惯量/质量估算及条件控制初值，详见[70mm机械参数与中午联调准备](70mm机械参数与中午联调准备.md)。图纸中心孔12mm与用户16mm描述存在差异，后者也恰为螺孔PCD，保留两种情况而未修改CAD。设备断电期间未执行硬件操作，新接管过渡版仍未烧录。

## 恢复供电后的接管版部署

2026-10-14用户确认设备供电和调试连接恢复。COM9初始回读为EN=000、Cal=0、Aligned=000、Ref=0，符合掉电后RAM参数丢失。接管过渡I2C版本已通过ST-LINK写入和Flash校验（SHA256 ac37386984ef1794e44c43449655fcb75817199674fe930ab34578f0f285bf95）；QUAD版本未烧录。

仅执行M1自检：ENC3、方向+1、估计7.05对极，配置7对极，正反扫描通过；M2/M3未使能。M1采样6482Hz、最大间隔405μs、读取124μs、错误0。零速短运行后停机，完成IMU静止校准。再次回读EN=000、Fault=0、Trip=1（STOP主动锁存）、Cal=1、Aligned=100、Ref=0、TripDeg=20.0，串口已释放。Map2/Map3仍是未对齐的默认映射，不能据此认定实际接线发生变化。

新增仅失能姿态记录脚本serial_passive_pose.py，发送STOP/PING/FAST 0/STATE?，记录姿态范围，不采集BZERO、不使能电机。当前静置姿态Rol约90.18°，没有把它当作边沿平衡参考。等待用户将机体扶回所选棱、寻找扶持力最小的位置，再采集候选参考和无端点承重的响应。

本块确认烧录、对齐与静止校准完成；接管过渡的自由实测、真实重心零点、恢复方向和20°硬件越界触发仍待验证。

## 新候选姿态与零输出窗口

用户将机体扶回中间后，5秒失能采集123帧，Rol中位43.01°、范围42.15～43.80°，Pit中位−1.17°。保存新的候选重力向量，neutral_verified仍为false；没有以离线重心角估计替换实际手扶参考。

随后BAXIS1=Y、BDIR1=−1，当前姿态重新BZERO，启动8秒倒计时；全零增益、限压0.5V下记录约1.53秒，实际77个FAST运行帧：Angle为−0.89～−0.65°、Rate为−0.044～0.021rad/s、飞轮速度和Uq均为0，随后STOP。FREQ6439Hz、Gap335μs、错误0。只是零输出窗口测试，不验证恢复方向/接管增益，也未越过20°。已询问用户PG6期间是否真正松手且无端点接触，待确认后才解释为自由响应。

最后回读EN=000、Bal=0、Fault=0、Trip=1（STOP锁存）、Cal=1、Aligned=100、Ref=1、TripDeg=20.0，U恢复2.5V、L恢复15rad/s。保存候选由前一段姿态中位数推算，并非后续BZERO瞬间参考的精确导出。

用户明确确认零输出窗口期间仍有手扶或靠限位，因此该数据不能确认真实重心零点，也不能视作自由响应。

随后保留同一RAM参考，在±30°限位下测试离线候选60/3.6/−0.034/0、U/BU=3V、固件轮速上限100rad/s、主机界限80rad/s，8秒倒计时后最多4秒。约1.234秒主机轮速保护触发：FAST Angle范围0.61～1.24°，Rate范围−0.066～0.114rad/s，轮速0→−80.84rad/s，Uq从约−1.10V至−3V饱和。启用飞轮反馈前的前0.5秒也在持续升速，之后负Kw项逐渐增强同向输出。姿态几乎不动，接管过渡本身不能解决该工况；是否仍由外部支撑抑制响应，已向用户询问。此时既不能宣称方向错误，也不能宣称该模型候选已验证。后续不继续盲目加力。

试验结束回读EN=000、Bal=0、Fault=0、Trip=1（STOP主动锁存），已恢复U2.5/L15并释放串口。该次不是20°角度触发，未完成自由平衡。

用户确认加力轮期间仍用手扶着，主观感受恢复力小、轻倾后停止。因此两轮均受外部约束，不能由这些数据整定自由平衡；这次停止原因经遥测明确为轮速保护。已在失能下将运行时增益改为60/3.6/0/0，并收到OK LQR1回读，去掉手扶时会同向增强输出的负轮速项；未改固件默认值。最后仍EN=000。随后失能状态下读到姿态18.5～23.17°，只能证明传感器观察到越过20°，因为Bal=0，仍不算运行中20°跌倒锁存验证。等待用户具备PG6后完全松手、不滑出支撑棱的布置，再执行短时PD试验。

## 姿态PD、限位行程及60°台架设置

按用户表示PG6后完全松手，运行60/3.6/0/0、U4V的5秒窗口。实际完成5.046秒后定时STOP，没有姿态/轮速提前保护：Angle范围−2.61～2.18°，Rate−0.133～0.070rad/s，轮速−43.68～92.70rad/s，Uq−2.13～2.84V；采样6454Hz、错误0。用户随后明确表示期间触碰了限位，因此不能称为5秒自由平衡成功，也不能用末段小幅姿态变化辨识自由模型。

用户要求12秒试验和±60°倾倒检测。BTRIP失能配置范围由10～25°扩大到10～60°，固件上电默认仍20°；上位机范围同步，主机试验脚本新增--trip-angle及回读核对，主机倾角上限可配到所选固件阈值。速度、角速度、堵转、采样、驱动、心跳保护保留。60°为受限台架设置，不代表60°恢复能力。生产C测试覆盖59°仍运行、61°失能锁存、运行中拒绝改阈值、垂直所选轴跌倒仍锁存；上位机18项测试通过。

用户确认触碰的是整个立方体，支撑棱不移动。首次定时扫角采集实际一直静止约50.95°，没有记录到扫角；改为逐端确认后读取，端点A约34.94°，B约50.77°，实测总行程约15.83°，不是±30°。端点相对当时RAM参考约−6.57°、+9.25°，该参考Roll约41.5°，与早先5秒采集43.01°候选有约1.5°差别。两个姿态均未验证为重心中性点。

已构建CubeMX-edge-fixture60（I2C）和对应quad版，各38输入、0错误/警告；I2C HEX SHA256为1ee14408952877b6f99c4c11ce7447757b75cd22edfc5e1fd79be20f0b14900c，已烧录并通过Flash校验。quad版仅构建，未上板。随后仅对齐M1：ENC3、7对极，估计6.99对极，正反扫描通过；IMU静止校准完成。

使用43.01°候选BREF重新配置后，BTRIP60回读正确，执行12.016秒全零增益窗口。Angle范围1.74～3.29°，Rate−0.065～0.040rad/s，Uq为0，轮速仅−0.02～0.05rad/s量化/读取噪声；前约9秒几乎不动，之后才缓慢变化。用户确认这12秒期间一直手扶中间、没有松手，因此不是自由响应，也不验证零点。没有真正越过60°；该阈值的硬件跌倒触发仍未验证。

为消除松手时机的不确定，改成用户先将机体靠端点、明确移开手后才启动。失能读取Rol35.45°后，新增单次脉冲参数，在无手扶A端进行+3V120ms探测：12个100Hz运行样本，轮速峰36.36rad/s；Wy初始正向峰0.133rad/s、随后负向−0.068rad/s，响应包含端点/结构弹性回摆。F4自行结束，最终EN=000。该脉冲约为此前2.5V50ms的2.88倍电压时间积，但电压时间积不是实测力矩冲量，不能以此证明恢复力度增加2.88倍。仍不能仅凭端点振动认定已脱离接触或方向最终确认。BAXIS1重新确认会使Ref/Dir失效，后续平衡需显式配置方向和参考。

最后EN=000、Bal=0、Fault=0、Trip=1（STOP）、Cal=1、Aligned=100、TripDeg=60，U2.5/L15，端口已释放。正在核对B端完全松手后能否自然停住，以判断重心中性点是否在现有限位行程内。

## 6V短脉冲与接管时机核对

用户明确确认手已离开，并说明两端均能无手扶自主停靠。读取当前位置为B端约50.71°。扩展定时探测至±6V，超过3V时持续时间硬限80ms，原本≤3V仍最多120ms；同时保留相对位移10°、机体角速度2rad/s和飞轮60rad/s保护。生产C测试通过：−6V80ms实际设定q轴输出并自动失能，81ms拒绝，U4时6V拒绝。I2C/QUAD各38输入0错误/警告，新I2C HEX已写入并Flash校验，SHA256 e0320ddaa52abdee9a5f5b04c1c34dab1795d4332a7dfdda0efeb252ac753b74；QUAD未烧录。再次完成M1对齐与静止校准，M2/M3保持失能。

无手扶B端的−4.5V80ms：Wy负峰−0.451rad/s，脉冲内轮速峰38.26rad/s；随后绝对姿态最低约47.98°，比起点50.70°离开约2.72°后返回B端。−6V80ms：Wy负峰−0.819rad/s，脉冲内轮速峰49.72rad/s；切断后最低约43.53°，相对50.69°回拉约7.16°后返回B端。脉冲均由F4自行结束。负q使机体负Y运动，这组无手扶、脱离端点的响应支持BDIR1=−1；仍没有证明整体闭环稳定。坐标用IMU姿态，动态加速度会影响融合角，不能把7.16°当作精密测角结果。

为了消除松手时机不确定，主机试验脚本新增可选限位脉冲启动：仅M1、已校准/对齐、方向−1已确认、保存参考可用、端点相对参考4～12°且机体/飞轮静止；命令必须朝参考方向。F4探测结束必须被遥测确认，随后才发BAL1，仍由原有3°、低角速度且持续100ms的STANDBY条件决定使能，2秒未捕获即STOP。没有增加固件自动自起立模式，也没有绕过正常BSTART的手扶入位流程。

共3次可选脉冲启动均未接管：B端−6V80ms在参考附近角速度约−1.1～−1.5rad/s，穿过至A端，原有入位门限正确拒绝；A端+6V60ms仅很小位移，未进窗口；用户移回B端后−6V60ms也未进窗口。用户随后确认在此期间放宽过限位器，最终B端约54.49°，因此不同次的端点、脉冲轨迹不能视为完全相同初态。没有将这些超时记为平衡或倾倒触发。

恢复普通8秒倒计时手扶入位，尝试80/5/0/0、U6、固件轮速180、主机150rad/s界限，最多12秒。运行3.672秒后轮速150.52rad/s触发主机保护，末段倾角约2.9°、Uq4.14V；用户确认尚未松手，因此仍是受约束响应，不是自由平衡，不应继续据此提高速度/电压界限。已询问未及时松手的原因，以区分指示灯可见性、等待聊天提示和等待电机托稳等情况。

当前全部失能、串口释放；最后EN=000、Bal=0、Fault=0、Trip=1（STOP）、Cal=1、Aligned=100、Ref=1、BDIR1=−1、TripDeg=60、U2.5/L15。运行时增益仍80/5/0/0；正常重启默认停机角20°，60°需要失能配置。尚无已确认无手扶、无端点接触的持续平衡结果。

## 300rad/s保护对比、零点候选与现场核对

用户解释此前等待“电机先托稳再松手”，因此多数较长运行仍被手扶约束。已说明反作用飞轮力矩来自加减速，匀速旋转不会持续托住机体；PG6亮即松手，才能整定自由机体。再次试验时主机曾在收到OK BREF后仍看到旧Ref0，200ms固定等待导致误取消，固件实际已接受参考。主机改为发送STATE?并等待新一帧且目标字段匹配，超时仍STOP；同时核对SLimit实际回读，避免只改主机界限、固件仍被截断。该误取消未使能电机。

按用户明确PG6即松手的新一轮80/5/0/0、6V、主机150rad/s，0.718秒达到155.55rad/s并停机，期间误差约−1.8→−10.5°、负向机体角速度增大。用户确认本次真正松手。用户要求超速保护至少提高到原来200%，因此主机试验配置300rad/s、固件330rad/s；固件L可配置到360，上电默认仍180。原始速度反馈限幅300→600，以保证超过300的轮速仍可被观测；上位机全局Limit可读写至360，调速卡片仍±180。生产C测试覆盖高于350的真实计算速度不会截在300、330界限仍失能；上位机19项通过。

已构建I2C/QUAD的CubeMX-edge-wheel300，各38输入、0错误/警告；I2C HEX205bc2b0b0035e5b9babe4213b80ecf4f2fc95451819b758d09bacaf544951d9已烧录并Flash校验，QUAD未上板。重做M1对齐和静止校准，采样约6442Hz、错误0。

保持43°候选、80/5/0/0、6V的300上限对比完成3.047秒，FAST角度−11.17～2.51°、轮速−27.77～253.46rad/s。用户确认已松手、触碰A端并尝试扶回一次；因此后段回摆不能解释为自主恢复。

再试47°探索候选（仅向B端移动4°，neutral_verified=false），同样增益/限压完成5.031秒，角度1.16～2.40°、轮速−75.59～−1.47rad/s，末段约−70rad/s/−1.7V。用户称没有手扶、曾保持，随后指出可能与数据线有关，不能将此确定为无外力平衡。

用户放松数据线后同参数12.032秒复测，角度−10.78～0.73°、轮速0.17～278.31rad/s，输出−0.91～6V；采样6455Hz、最大间隔509μs、错误0。用户确认无手扶、触碰A端且持续高速旋转，主观怀疑方向反。该次只是完整定时窗口、不是平衡成功，也未真正超过300或60°。

按方向疑问进行+1、3V的1秒及3秒对比：1秒偏角扩大至约+5.9°；3秒末段约−4°、q=−3V、轮速约−122rad/s，均定时STOP。用户最终明确3秒全程没有松手、感觉不出方向，因此这些受约束数据不能作为方向翻转的依据。先前无手扶脱离B端的负q/负Y短脉冲仍支持−1；方向的闭环自由复核未完成。新增可选--brake-wheel用于对比前在M1零速闭环下制停飞轮，M2/M3继续禁用。

本阶段没有已确认无手扶、无端点接触的持续平衡结果。真实重心零点、线材反力、完整轮速反馈/反电势余量均需继续分开核对，不能仅提高电压或超速阈值就认定解决。F4硬件正交版本已构建，本次上板实测仍为I2C（EncType0），未把编译通过当作AB硬件实测通过。

结束时先M1零速闭环制停，遥测速度约−0.13～0.11rad/s，然后失能。恢复BDIR1=−1，最后确认App=0、EN=000、Bal=0、Fault=0、Trip=1（STOP锁存）、Cal=1、Aligned=100、Ref=1（47°候选）、TripDeg=60、U2.5/L15、运行时增益80/5/0/0，串口已释放。未触发真正的60°或300rad/s越界，相关硬件边界触发仍未验证。

## B端等幅双向探测与复测

用户主动将机体靠B端，要求通过两个方向探测恢复正方向。失能基线Rol53.69°、静止，M1对齐/IMU校准有效。新增探测脚本可选端点Angle门限与新STATE回读、1秒脉冲后观察；每次先制停飞轮，再核对端点姿态、机体角速度与轮速，任一不符即拒绝脉冲。

两组均为+6V80ms后−6V80ms，B端基线相对旧47°参考分别6.73/6.71°、6.83/6.86°，因此初态相近。正脉冲初始Wy正峰0.199和0.137rad/s，随即受B端约束回摆；第一组正脉冲后的姿态相对初态仅−0.32～+0.24°。负脉冲Wy负峰−0.632和−0.612rad/s，第一组离开B端约4.43°后返回B端，重复结果见b_endpoint_direction_result.json。第一组陀螺积分：正脉冲有效采样区间约+0.136°，负脉冲约−1.691°，与初始方向一致。正脉冲含端点接触振动，不能把后面的负向回摆误认为驱动初始方向。

用户第一次未留意现场，要求复测；复测时明确观察到两次动作、第二次有明显起跳，并要求加大第二次力度尝试到A端。该观察与负输出回拉B端的遥测一致。结论：正q对应机体正Y/朝B端，负q对应机体负Y/离开B端，恢复反馈仍取BDIR1=−1；编码器电角度方向仍+1，两者不能混用。该方向探测不验证重心零点或自由平衡。

第一组结束曾制停飞轮并回读全失能、BDIR1−1/DirMask1、Ref0；复测会再次确认BAXIS并清除参考/方向确认，需在本轮最终收尾重新确认BDIR。当前第二组脉冲均已自行结束、EN000、U2.5/L15，未启动平衡。下一块按用户请求扩展受限脉冲的持续时间，尚未执行长脉冲。

## 无手扶B→A冲量实测

用户观察到第二次负脉冲有明显起跳，要求加大第二次力度，观察是否能直接到A端。先保持电压6V，延长脉冲时间来增加冲量。BPROBE现在统一支持20～120ms；只有abs(U)>3V且时间>80ms的明确长脉冲把飞轮保护配置为100rad/s，其他脉冲仍60rad/s。10°相对姿态、2rad/s机体角速度、驱动/编码器/心跳保护不变。10°探测保护针对输出有效阶段，失能后的惯性运动仍可能跨越更大角度。

生产C/UART测试通过，无警告：6V120ms在119ms仍启用、到120ms自行失能，121ms拒绝；普通80ms轮速61保护，长120ms轮速95允许/101保护，长脉冲机体2.01rad/s仍保护。I2C与QUAD各38输入，ARMCC0错误/警告。I2C CubeMX-edge-impulse120 HEX（d15c18e956b614fe08c43fa59a55ebf94184aca4a0ea3eabdba0d67af61862c4）已写入并Flash校验，QUAD仅构建。仅重新对齐M1（ENC3、7对极）及静止校准；M2/M3未使能。

只实测了一次−6V100ms，未继续120ms。基线姿态约54.05°，Wy负峰−0.927rad/s，脉冲内轮速峰61.93rad/s，F4到时自动失能。切断后继续靠动量摆动，姿态最低约34.04°，2秒观察结束约35.97°；最终STATE约35.99°。用户明确确认全程无手扶、从B跳到A、限位器和支撑棱均未移动。因此本轮无歧义确认负输出将机体从B推向A，支持恢复反馈BDIR1=−1，并证明这组冲量足以跨过限位中间。不能把B→A跃迁等同于持续平衡成功。

本次烧录后参考为默认Z且Ref0，BAXIS1确认Y后约54°/34°是当前轴的姿态角，近似对应Rol；不是已经建立的平衡零点误差。没有将A端停靠姿态采为BZERO。100ms已达到用户要求，无需再升到120ms。

结束时M1零速闭环制停，最后速度样本为0；全失能并恢复BDIR1−1/DirMask1、TripDeg60、U2.5/L15，App0、Bal0、Fault0、Trip1（STOP）、Cal1、Aligned100、Ref0，串口释放。Ref0使后续平衡必须重新明确采集/恢复中性参考。该块不会自动重启平衡。

## 首次现场确认：49°参考、负轮速反馈、自主站立5秒

用户要求在方向确定后重新测试单边稳定。开场回读M1已对齐、IMU已校准、EN000、Ref0，当前A端姿态约36.55°。依据前一轮明确无手扶B→A自由摆动，在约49°附近机体角速度由减速转向持续朝A增大，选择49°探索参考；这是结合自由轨迹的候选，不是精确无控制重心零点辨识。

配置BDIR1−1、BAXIS1Y、参考Rol49°/Pit−1.3°，增益80/5/−0.045/0，U/BU6V、固件L330、主机轮速300rad/s、BTRIP60、BCAP10、BSTART8秒，M2/M3保持失能。负轮速项按既有固件在接管前0.5秒不加入、随后1秒渐入。初始曾离目标约5°，用户移回窗口后接管；倒计时离开10°窗口会取消并等待，最终在约0.6°误差处接管。

实际运行5.015秒后主机定时STOP，未触发提前保护。FAST角度−0.62～+0.98°，机体角速度−0.064～0.100rad/s，轮速−18.58～57.99rad/s，q轴电压−0.74～1.66V，末段轮速约35rad/s。采样6448Hz、最大间隔459μs、读取125μs、错误0。用户明确反馈：“自主立住，完全没有手扶，没有触碰到限位，没有线材干扰”，并要求立即提交备份。因此本次可以明确记为有限5秒的自主单边站立，不再只是受约束静止记录。

完整可复现配置保存为edge_balance_verified5s_profile.json，含当前固件SHA256、参考重力向量、映射/极对数/编码器与机架方向、全部控制参数和复现命令。此结果不证明长期稳定、抗扰范围或三轴平衡；49°也未据此标为精确被动重心零点。掉电后需重新TEST1和静止CAL_IMU，再显式恢复轴/方向/参考及限压轮速参数。脚本结束仍恢复U2.5/L15并全部失能，不能直接用清理后的15rad/s上限复现本轮工作配置。

## 自动单边流程实现（尚未上板）

用户要求在备份后设置自动入位、持续运行、超过±20°停机等待下一次、满速持续3秒保护，并加入上位机单边检测。用户选择满速250rad/s；硬超速仍330。新增BAUTO自动边沿状态、BFULL阈值、3秒连续计时、1秒冷却与飞轮低于5rad/s后重试；自动接管需±3°/低角速度稳定1秒，再完成倒计时。倾倒和满速事件回到失能等待；急停、断连及硬故障退出自动并锁停。

上位机新增靠前显示的单边检测面板、已验证M1配置加载、自动启停与满速配置。加载需BREF应答与匹配的新状态帧，失败STOP；默认不开机自转。CLI可显式连接COM9加载并启用自动检测，人工急停可取消尚未执行的延后启动；串口打开前关闭DTR/RTS避免重置校准。连接后保持心跳，无固定时长的控制由F4执行。

生产C/UART回归通过，覆盖两次自动重试、满速中断清零、未停飞轮禁止入位、急停/断连不重启、60秒不定时停止、HAL tick回绕和状态帧发送余量。测试修正了首次接管后重试倒计时秒数被清零的问题。上位机28项通过；I2C/QUAD各38输入0错误/警告。状态帧增长后预留900字节发送空间，周期状态优先，跳过同周期普通遥测，避免半帧/串口堆积。UI界面已生成并检查。此时仅构建与软件测试，尚未烧录；原3546f32的5秒成功备份保持可回溯。

## 自动单边上板、常驻上位机与用户操作

94f0ea0实现提交后，已写入并Flash校验CubeMX-edge-auto/I2C，HEX69eece089d77b56013f499f27aa3717efba8f9668b1e8c9a49a1f4bebdcf9704，QUAD仅构建。M1重新对齐：ENC3、7对极，估计6.93，正反扫描通过；随后IMU静止校准完成。

实际GUI启动发现旧解析器用Dir前缀校验误把DirOK0当作编码器方向，导致新烧录后的所有未确认状态被丢弃、配置流程无法开始。已改为只校验Dir1/2/3，新增未确认启动状态测试。29项上位机测试通过，COM9实际启动、加载配置、BAUTO1与状态回读随后成功。当前GUI为持续运行进程，提供心跳，控制不依赖有时长上限的串口试验脚本。

实机回读Auto1/Bal3/EN100/TripDeg20/FullSpeed250/L330，M2/M3失能，用户反馈非常稳定、没有外部干扰。只读状态采集不发硬件命令、不停止控制。第一次记录连续约20秒后遇到Windows短暂文件占用，仅采集器退出、控制继续；采集器增加短暂读失败重试后再记录60秒窗口，其中前段持续平衡，后段为用户手动停止。精确时长和运行期范围见edge_auto_runtime_result.json，不能把包含手动停机的窗口标为完整60秒持续平衡。

用户确认自己正在研究上位机、手动点过控制，故保留其停机，不自动覆盖或重新启用。后续回读Cal0/Aligned000/Ref0，提示需要重新自检和静止校准。给出M1操作顺序：调试模式选M1自检→工作模式静止校准→加载已验证M1配置（失能）→启动自动单边→扶到参考附近PG6亮即松手。修改映射会使参考失效，重新加载验证配置可恢复。连续站立反馈与保护逻辑的软件回归已确认，本次实机未故意触发真正20°和250rad/s连续3秒边界。

新配置备份为edge_balance_auto_profile.json。原始3546f32的5秒成功备份保持不变。上位机运行中无需满足用于启动的低轮速条件，检测面板文案已修正为“正在平衡”；该文案修正保存在源码中，不为更新文案而打断已运行的控制进程。

## 上位机滚轮误操作与准备入口修复

用户反馈下拉框滚轮误切换造成配置混乱，加载验证配置和自动启动按钮均不可点。所有下拉框改为NoWheelComboBox，滚轮事件始终忽略、点击/明确选择仍保留。新增测试枚举全部下拉框，发送正负滚轮事件（含获得焦点），检查索引不变且无命令下发。

回读实机Aligned000/Cal0/Ref0，确认加载/启动被实际准备条件锁住。修复交互：单边面板在调试/工作模式均可见，直接提供M1自检、静止校准两个入口，显示“配置准备”“自动启动”缺少条件；自检入口显式只发送APP0/DBG1/TEST1，电机会短时转动。配置加载仍保持失能并需自检/校准；参考和全部条件确认后才允许自动启动，没有绕过固件前提。串口连接后同步显示实际端口，避免CLI连COM9而下拉仍显示COM3。

33项上位机测试通过，覆盖滚轮不改值、不下发命令，冷启动状态准备按钮可用，校准/配置依次解锁，以及连接端口同步。已检查WindowsQt界面预览。关闭旧Cubli窗口并打开修复版，保持无自动启动，当前由新版GUI持有COM9；本块没有执行实际自检或启动电机，保留用户操作准备步骤。固件未改动。M1操作说明已更新为同面板顺序：自检→静止校准→加载配置→自动单边。
