TDX33029/Cubli-STM32F407-ESP32/Firmware/diagnostics/2026-10-14/高转速实测与M2迁移.md

# 2026-10-14 高转速实测与 M2 迁移准备

本次 COM9 实测结论：M4（程序 M1）和顶层 M3 **单轴短时达到 ±180 rad/s**；双轴 **±120 rad/s 稳速及换向通过**，但高速快速变速有明显跟随滞后。双轴 150～180 rad/s 未通过持续跟随检查，不能认定整个高转速范围已稳定。M2 始终失能。本次没有实际平衡实验。

用户在测试过程中多次现场确认：声音正常，电机、驱动没有明显温升或摩擦。没有温度、电流、实际母线电压的仪表记录，不能据此排除电源变化或证明长时间温升安全。

## 条件与逐级结果

旧板 USART2，COM9 / 115200 / 8N1；用户确认电机供电 12V，固件配置母线 12V。编码器使用 I2C（EncType=0），7 极对数。PI=0.30/0.80，D=0，Tf=4ms，摩擦前馈 0.12V，反电势前馈 0.024V/(rad/s)，ACC=400rad/s²；本次没有改变这组整定值。

| 测试 | Uq 限压 | 结果 |
| --- | ---: | --- |
| 分别运行 ±20/40/60rad/s | 2.5V | 跟随、换向、停车正常 |
| 分别运行 ±90rad/s | 3V | 跟随正常；M4 速度波动比 M3 大 |
| 分别运行 ±120rad/s | 3.5V | 跟随正常 |
| 分别运行 ±150rad/s | 4.2V | 短时跟随正常 |
| 分别运行 ±180rad/s（约1719rpm） | 5V | 两轴短时可达到；M4 部分饱和，重标定后 M3 负向持续达到限压 |
| 双轴初次启动 | 5V，尚未升速 | 第二轴使能触发 Trip8，已定位并修复，见下文 |
| 修复后双轴逐级20/60/120/150/180rad/s | 5V | 到150时短时跟随；180时M3目标−180、实测约−161.3，Uq=−5V持续饱和，脚本停机 |
| 延长双轴150rad/s保持时间 | 5V | M4约150.0，M3目标−150、实测约−130.8，Uq=−5V持续饱和，脚本停机；后续换向/脉动未执行 |
| 最终双轴±120rad/s，每段约5秒保持 | 5V | 两方向稳速、换向、回零完成，无运行故障 |
| 最终双轴90↔120rad/s，每150ms切换、共20次 | 5V | 无失速，但M3高速加速跟随不足；不能把“未停转”当作动态性能已达标 |

初次180失败后未继续提高限压。第二次150试验推翻了“短时达到150就可持续稳定”的判断，最终以收尾复测结果为准。

最终双轴稳态窗口（各保持段末尾约0.7秒，取自脚本在线汇总）：

| 轴 | 目标 rad/s | 实测均值 rad/s | 标准差 rad/s | 平均Uq |
| --- | ---: | ---: | ---: | ---: |
| M4/程序M1 | +120（第一段） | 119.935 | 2.385 | +2.821V |
| M3 | −120（第一段） | −119.363 | 0.633 | −4.923V |
| M4/程序M1 | −120 | −119.962 | 2.165 | −3.071V |
| M3 | +120 | 120.066 | 0.631 | +2.787V |
| M4/程序M1 | +120（返回段） | 120.008 | 2.400 | +2.736V |
| M3 | −120（返回段） | −119.830 | 0.607 | −3.953V |

M3负向的电压需求在不同阶段有变化，即使120rad/s第一段也一度接近限压，余量不稳定。当前证据只能确认饱和时跟随不足，尚不能确定由供电、换相相位/延迟、安装负载或其他硬件因素中的哪一项造成；没有直接证据将其归因于发热或单纯编码器读取频率不足。

90↔120脉动共311帧：相对斜坡后参考的速度误差，M4 RMS约7.18、最大15.69rad/s；M3 RMS约12.16、最大24.58rad/s。M3在连续高速脉动中多次来不及到达120就开始下一次减速。ACC=400时，90→120参考斜坡本身需75ms，+120→−120需600ms，+180→−180需900ms，实际响应还要考虑电压和惯量。

高转速实测

## 本次发现并修复的程序问题

原I2C失能轴轮询只在三轴全部失能时执行。一轴运行后，其他轴采样停滞；晚些时候再使能第二轴，5ms反馈过期保护可能在第一轮FOC之前触发Trip8。

`main.c`现改为每毫秒轮询一个失能轴，其他轴运行时仍更新滑行反馈；使能前在未屏蔽中断的条件下实际读取该轴编码器，读取失败锁存停机，读取成功才进入使能检查。没有伪造采样时间，也没有放宽5ms保护。增加了“旧反馈后第二轴使能”和“使能前读取失败”生产C回归测试。

代价是I2C轮询占用少量FOC时间。最终双轴运行每轴约3203～3213Hz，最大间隔M1/M3约719/720μs，读取耗时约126/127μs，错误数0；失能M2逻辑槽位约1000Hz。单轴约6.4kHz。FREQ为角度更新统计，速度差分窗口仍至少1ms；上位机波形刷新率不是编码器采样率。运行中没有Trip8复发。

高转速数据均在当前I2C方法取得，未切换AB硬件正交，不能声称硬件正交已通过实机高速测试。

## 明天 M2 的迁移步骤

相同电机型号可以复用下面的**初始控制参数**，但对齐零位、编码器映射/方向与故障结论必须逐轴重新测量，尤其M2有十分钟严重堵转过热史。三轴同时运行的I2C负载也高于本次双轴，必须另测采样间隔与动态响应。

1. 完全断电后检查M2相线/焊点、相间电阻与健康轴的差异、驱动和编码器磁铁。具备条件时按此前方案交换电机三相连接，区分电机与驱动通道；交换后所有受影响轴重新映射/对齐。
2. 上位机持续PING（约250ms），先停机，再`APP 0`、`MODE 1`、`U 2.5`、`L 15`、`ACC 400`，执行`TEST 2`。扫描失败就停在这里，不强行使能或修改极对数凑通过。
3. 自检通过后、驱动保持失能，设置`PID2 0.30 0.80 0`、`TF2 0.004`、`FF2 0.12 0.024`。这些是M2待验证初值；程序没有将其自动写入M2默认值。
4. 单轴从±2、±5、±10rad/s开始，再逐级20/40/60/90/120，每级检查实际转速、饱和和现场状态。先复现本次低速快速换向效果，不直接从180开始。
5. M2通过后再验证三轴同时运行。150～180rad/s以及高速大幅度快速变速暂不作为已通过的能力；M3负向限压问题应结合实际母线/电流或独立转速数据进一步定位。
6. 平衡仍需确认BAXIS/BDIR、采集实际支撑点BZERO并扶持验证恢复方向；速度测试不等于平衡验证。

## 固件与结束状态

本次已构建并实际烧录、校验：`Cubli-ST/MDK-ARM/CubeMX-motor-diagnostics/CubeMX.hex`；ASCII留档：`.codex-debug/20261014/diagnostic_i2c_highspeed.hex`。

硬件正交备用HEX也同步重建为`CubeMX-motor-diagnostics-quad/CubeMX.hex`，**未烧录**。两种构建各38个输入，0错误、0警告；生产C/UART回归、正交/I2C兼容回归通过。本轮没有修改上位机代码。

结束已全部停机并释放COM9：EN=000、Fault=0、Trip=1（主动STOP）、Mode=1、U限压2.5V、速度上限15rad/s。Aligned=101，M2未对齐；重烧录后已重新静止校准IMU，Cal=1、IMU=1，Ref/AxesOK/DirOK仍为0。掉电后RAM标定需重做。

原始日志以`highspeed_*.jsonl`保存；在线窗口统计见对应`*_summary.json`，离线末尾窗口统计见`highspeed_metrics.json`。在线汇总在查询FREQ前计算，离线按整个phase的末尾窗口计算，两者存在少量窗口偏移。首轮20～60脚本在清理时曾误将主动STOP的Trip1作为异常，已修正清理逻辑；其运动数据完整保留，不能将该脚本退出码误记为电机运行故障。`highspeed_verification.json`记录本轮源码、HEX和证据文件SHA256，先前`verification.json`对应前一版固件。
