TDX33029/Cubli-STM32F407-ESP32/Docs/README.md

# Docs

[🇨🇳 简体中文](README.md) | [🇬🇧 English](README_EN.md)

> 必要的数据手册与芯片规格书文档

## 简介

必要的数据手册
