TDX33029/Cubli-STM32F407-ESP32/Docs/README_EN.md

# Docs

[🇨🇳 简体中文](README.md) | [🇬🇧 English](README_EN.md)

> Necessary datasheets and hardware component documentation

## Introduction

Necessary Datasheets
