TDX33029/Cubli-STM32F407-ESP32/Software/README.md

# Software

[🇨🇳 简体中文](README.md) | [🇬🇧 English](README_EN.md)

> 上位机控制器源码与可执行文件

## 简介

上位机控制器 存在Python与Go两种版本 负责控制设备初始化与参数调节

## 组件说明

| 组件 | 说明 |
| --- | --- |
| Python 上位机 | 基于 Python 开发的控制调试上位机界面 |
| Go 上位机 | 基于 Go 开发的高性能控制与通信组件 |
