TDX33029/Cubli-STM32F407-ESP32/Software/README_EN.md

# Software

[🇨🇳 简体中文](README.md) | [🇬🇧 English](README_EN.md)

> Host controller source code and executables

## Introduction

Host controller – available in both Python and Go versions, responsible for device initialization control and parameter adjustment.

## Component Overview

| Component | Description |
| --- | --- |
| Python Host | Control and debugging GUI developed in Python |
| Go Host | High-performance control and communication component developed in Go |
