TDX33029/Cubli-STM32F407-ESP32/Firmware/Codex接续任务_单点平衡_2026-10-15.md

## 2026-10-18 更新：倾斜轮速反馈隔离WPlane1

当前默认HEX为347585feec8ead64fa2c10b319b94ef9b7b21698b0e068321af12d70e3d8b259，53396字节，NTune3/WPlane1，已烧录校验并完成neutral5_plane_startup_prep01（Aligned111/Cal1/EN000）。用户已确认本次自检就绪，不要重复问。COM9和只读窗口PID8072不变。

前两轮5°寻点7.110秒/6.219秒均机体角速度保护，未碰5°边界。第二轮最终目标22.94/48.11、偏移1.811°。两轮数据与控制公式提示持续加速有竖直轮速反馈分量，原寻点排除竖直分量无法处理它；加入WPlane1把加权Kw/Ki反馈投影到倾斜平面，BYAW独立自转阻尼保留、单边控制不改。生产C向量/符号/保护测试、50串口模拟、12窗口测试通过。NTune3初版在592f998，本次是其后续单变量实测，不能声称长期稳定。

正在neutral5_plane_trial8s_03：种子取第二轮目标22.94/48.11，原BREF23.4399/50保留，其他80/5/-.04/yaw6/tau.25/gain.000075/rate.3/总范围5°/6V/轮220/机体2不变，最多8秒。弹窗后自动等入位，不逐轮确认。若完成，按实际日志继续，保存学习而不重置；若需要同次续测使用 --resume-neutral-from 本轮summary，WPlane状态也要匹配。复位后才用seed。

---

## 2026-10-18 最新接续：5°寻点版已烧录

默认CubeMX为NTune3，SHA256 d65fca81c96584df2b3e498d7d457833c68d523d1c2454dce4e6b69e2e0f51bd，53244字节；38输入0错误0警告。已烧录校验并完成neutral5_startup_prep01，Aligned111/Cal1/EN000，COM9。用户已确认本次启动自检就绪，不需要再问。已知三轴方向不重测。

新增总范围2～5°、学习种子、主机resume/seed。用户明确选择5°总范围；主机机体角速度2rad/s，其余6V、220rad/s、原锚点10°/MCU20°不变。50串口模拟+12窗口测试及生产C测试通过。参见联调记录_2026-10-18.md。

上一轮2°寻点5.109秒保护、目标偏移1.060°到23.27/48.86°，尚未长期稳定。将以该summary作为种子从原23.4399/50锚点继续5°试验，Kp80/Kd5/Kw-.04/yaw6/tau.25/gain.000075/rate.3。STOP不清学习，同次上电下一轮用 --resume-neutral-from；重新配置/复位后用 --seed-neutral-from。不要对每轮重发BMODE/BAXIS/BDIR/BREF清空学习。日志只表示目标候选，未证实重心。

---

# Codex接续任务：先确定真实重心参考，再完成单点长期平衡

> **2026-10-18 用户已恢复设备并要求开始调试，之前暂停已解除。** CH340现为COM9。初始STATE缺少NTune/ATune，只读SWD回传逐字节确认实际烧录的是旧默认CubeMX/entry2s（49940数据字节）。已将默认 `MDK-ARM/CubeMX` 从当前源码完整重建（38输入、0错0警告），HEX与observer逐字节一致（SHA fc2b4c2b...、52524字节），并完成烧录校验；旧板上64KB读回备份保留在2026-10-18诊断目录，历史entry2s不删除。后续默认路径已修正，详见MDK-ARM/当前固件说明.md。用户已确认飞轮悬空静止，正在执行startup_prep01恢复启动对齐/IMU校准；完成后接续尚未执行的Kp120/Kd5/-0.040/BYAW6/τ.25、旧参考23.44/50的5秒测试，6V及原保护保持。弹窗版只读窗口已启动PID8072，COM9，live文件 `.codex-debug/20261018-validation/live.json`。勿把下方10月16日串口/暂停状态当成当前状态。

> **最新状态：用户明确要求“先停止等待我手动恢复”，任务已停止等待和硬件调试。** 不后台轮询串口、不自动重试，不在收到用户恢复消息前启动电机。CH340/COM7和ST-LINK当前均未检测到，仅蓝牙COM3/COM4；旧只读窗口PID19356也已退出，live.json为缓存。用户恢复后先发现真实端口、读取新STATE，必要时才常规自检/校准，并重新启动弹窗版窗口。不要把历史Cal1或EN000当作离线设备当前状态。

> 最近真实复测：历史完整80/5/-.040/BYAW6/τ.25/旧参考23.44/50的 `corner_observer_verified_profile_kd5_trial5s_01` 运行4.110秒后角速度1.914rad/s保护，M1-211.47/U-6，最终EN000/Bal0；未复现5秒成功。下一候选仅Kp80→120、其余不变，最多5秒，原220rad/s/1.5rad/s/10°主机和L240/BTRIP20/6V保护不变。`corner_observer_oldref_kp120_kd5_trial5s_01` 因COM7不存在未发送任何命令（active0），**尚未执行Kp120候选**。恢复后用新tag如_02，不覆盖日志。固件仍observer SHA fc2b4c2b...，不用为改该运行参数烧录；方向已配对确认，不重测转向。下方为历史进行中状态。

> **最新设备状态：弹窗版只读窗口已启动为PID19356，替代27020，COM7正常。** 重试τ0.25对照 `_trial5s_02` 在新STATE中检测到Aligned000/Cal0/默认映射，符合设备复位状态，正确拒绝启动（active_samples0）。没有再次烧录；现等用户把机体放稳、飞轮悬空后完成常规自检/静止校准，之后直接以新tag启动同配置5秒对照，等待入位时会弹出消息。无需重新辨识反作用方向。最新UI提交c78e0cf；固件仍observer SHA fc2b4c2b...。用户的每轮弹窗偏好已经确认，无需再询问。下方“校准仍有效/PID27020”是较早状态。

> **最新协作偏好：用户已明确选择每轮弹出消息提醒，摆好后自动开始。** 只读 pose_monitor 已增加无模态提醒，按 live.json 中 trial_id 每个有限试验首次进入Bal6/5弹出一次，显示本轮内容/目标/实时角度，关闭消息不影响倒计时，无确认按钮；Bal3/停机/姿态过期收起。有限试验发布 trial_id/trial_text，passive reader接回串口后保留；GUI不发控制命令或心跳。12项窗口测试、42项串口测试通过。接下来重启窗口加载该功能，并直接重新执行同τ0.25/80/8/-.04/BYAW6/数学参考5秒对照。以下“通知偏好未答复”为旧断点。

> **最新现场等待断点：下述τ0.25对照已在600秒未入位后自动结束，没有接管（active_samples0），不能算闭环失败。** 最终Bal0/EN000/Auto0/Fault0/Aligned111/Cal1/AttTau0.25/NOn0，U2.5/L15，COM7正常。只有只读窗口PID27020，没有调控脚本。用户通知偏好问题尚未答复（弹出提醒或仅看窗口）；需要现场扶回24.70°/49.72°附近才能进行下一轮。用户恢复现场操作时直接以同配置重新启动5秒对照，勿再次烧录或校准，除非检测到主板复位使对齐/校准失效。长期稳定目标仍未完成；已完成的代码/日志已提交，不能用三轮收尾代替目标完成。下方“正在运行”是上一个进行中快照。

> **2026-10-16 最新进行中：用户要求持续推进，不能把完成三轮试验当作长期稳定目标完成。** 目前固件为 `CubeMX-corner-observer`，HEX SHA256 `fc2b4c2bd48e200d78c7fb094de2150e3ce23f0787d696df2477db035051adec`，已烧录校验、自检与IMU校准。新增 BATTAU .25..2 失能设置（ATune1/AttTau），默认/换模式/校准/复位仍0.25秒。42项串口测试、生产C控制/UART及固定支点观测仿真通过；仿真0.25s误差0.1762°/1s误差0.0372°，不能代替实机。实机τ1、80/8/-.04/BYAW6、数学参考24.70/49.72、寻点关闭在3.875秒角速度1.614rad/s保护，M1/M3均-6V，最终失能，未提升默认。当前正运行同校准τ0.25的5秒对照 `corner_observer_tau025_comref_kd8_kw040_yaw6_trial5s_01`（串口COM7；启动时--wait-seconds600自动等入位；进程会在超时/保护/5秒后STOP/FAST0并确认失能）。不要重复启动占用串口；先检查现有进程与日志。该轮尚未完成时不要提交打开的jsonl。操作/结果详见《单点姿态观测对照_2026-10-16.md》。真实长期平衡尚未达成。

> 三轴反作用配对已补齐：M1旧正负脉冲+M2/M3新±3V/80ms，支持现有BAXIS2/3/1、BDIR全部-1。响应审阅 `corner_paired_response_review_complete01.json` 的反推主惯量违反三角不等式，不能据此推荐增益。启动校准确定编码器/电角度；这轮脉冲用于整机响应与轴间耦合，用户已经问过区别并已解释，**无需再重复转向辨识**。脉冲准备旧姿态覆盖/保护包打断finally/串口查询丢失延迟等问题已修复，详见 corner_identification_notes.md。窗口“自动重连”曾是FAST边沿包缺姿态导致，并非主板挂了；当前STOP/FAST0收尾已恢复完整姿态流。

> 当前只读窗口PID27020、COM7、同 `.codex-debug/20261016-com-validation/live.json`；不发心跳，试验通过 SerialMonitorHandoff 借口。用户确认窗口可见；需手扶入位后PG6亮即松手，保持既定支点/线材/电池条件，不重复询问或要求点击记录。有时用户在平放等待，提醒“扶回同一目标”即可；用户通知偏好问题正在等待答复（弹出提示或仅看窗口），不要把未摆到目标当成电机故障。等待期EN000，不要放宽入位/保护以强行启动。

> 后续：先完成当前τ0.25对照；如未证实τ1改善，保留0.25。自动寻点快/慢两端已经失败，若继续有界慢环对照，可考虑中间强度（增益0.000075、速度0.3°/秒，仍2°范围）而非放宽保护；该中间值**尚未执行、不是已验证参数**。主机220rad/s、1.5rad/s、原参考10°，固件L240/BTRIP20及6V限压保持。每完成一块提交本地commit，不push。根目录用户删除的《主控板原理图审查报告_2026-10-07.md》一直保留未暂存，不能混入提交。以下条目为更早历史。

> **2026-10-16 最新断点：自动寻点已实现并完成三轮有界实测，尚未长期稳定。** 详见《单点自动寻点说明_2026-10-16.md》。当前板载 `CubeMX-corner-neutral-slow`，HEX SHA256 `fb1c4312be9587ca89f76d03fda778fde98983ccb7b5320dfa6ae2769876db68`，NTune2；新增失能命令 BNEUTRAL 0/1 [gain rate]，默认关闭。去除飞轮竖直自转分量，2°总范围，默认增益0.000025、最大0.1°/秒，硬上限0.5°/秒；保留即时快环、Ki/BTRIM0及原始参考保护。首轮快寻点4.36秒、慢寻点5.797秒、Kw-.035对照6.000秒，均M3达到6V后角速度保护，不是定时完成，不能宣称识别了真实重心或长期稳定。真实UART六位微小增益回读已修复并测试，35项串口诊断及10项窗口测试、生产C控制/UART测试通过。最终仅配置恢复测试前80/8/-.040、BYAW6、候选24.70/49.72并停机：Bal0/EN000/Auto0/Fault0/NOn0/NOff0，Aligned111/Cal1，停止后U2.5/L15。COM7仍可用，只读角度窗口PID6760持续运行，不发心跳；没有调控脚本。下一步先验证多轴动态响应和电压余量，不能继续只调整参考或放宽保护。原现场条件沿用，用户要求自行分析日志，勿重复就绪/点击记录/电池/支点确认。以下条目为历史过程。

> 当前候选数学参考+Kd8完成5秒遥测：corner_immediate_comref_kd8_kw040_yaw6_trial5s_01，80/8/−.04、BYAW6、BTRIM0、24.70/49.72、新版立即反馈；5秒定时完成，maxTilt1.391°、三轴峰值均<127rad/s，无保护。暂无新的独立现场反馈，下一轮同参数8秒。为解决用户无法分辨定时/保护停机，简洁窗口状态行现显示运行剩余秒数及上次停机原因；不新增按钮/记录。停机确认失败会明确显示“停机未确认”。30项诊断模拟与9项窗口测试通过。当前只读窗口已重启为PID7364（替代21652），同live文件路径持续读COM7；试验自动借口。该Python界面变更未改固件。下一次硬件脚本新启动才含剩余/结果字段。

> 数学参考8秒在6.141秒触发轮速保护：corner_immediate_comref_kw040_yaw6_trial8s_01，M3+221.31rad/s越过主机220，M2−195.75，U2−6/U3+6，Tilt4.67/Rate1.261（未触发1.5角速度）。M3先−99后+219，仍有较大摆动/积累，不能放宽保护或认定精确重心。下一组保持数学参考24.70/49.72、新版完整反馈、Kw−.04、BYAW6，仅倾斜Kd5->8，先5秒，自动等入位。早前Kd8试验在Kw0隔离状态，与本轮完整闭环不同。未启用Ki；如后续考虑轮角积分，必须处理竖直分量，否则纯自转模式可能不稳定，不能直接三轴全加负Ki。

> 数学参考在修正控制器下5秒遥测完成：corner_immediate_comref_kw040_yaw6_trial5s_01，24.70299°/49.71596°，80/5/−.04三轴、BYAW6，新固件立即完整反馈。5秒计时结束无保护，maxTilt3.175°，M1最高171.26、M2最高76.52、M3最高116.14rad/s。没有新的独立现场反馈，尚不能把数学参考记为中性点/长期成功。下一组同数学参考/全部参数，仅延长8秒，自动等入位。不要把旧参考5秒用户成功与本轮数学参考自动混同。考虑轮速仍积累，后续若需积分应区分轮角积分与姿态积分，且三轴积分的竖直分量可能激发自转，不能随意对全部轴直接启用Ki。

> BYAW6同参数8秒复测在5.110秒保护：corner_immediate_kw040_yaw6_trial8s_01，Rate1.708、Tilt7.32，M1−187.17/M3−187.97rad/s、两轴U−6V，最终失能。5秒成功仍不是长期稳定，profile已附后续失败。下一步仅把旧23.4399°/50°参考更换为三挂点数学候选24.70299°/49.71596°（g=−.693037404,.417914491,.587406703），继续新版立即反馈、80/5/−.04三轴、BYAW6、原保护，先5秒。该候选此前只在旧延迟/Kw−.03控制器测过，需在当前修正控制器下重新验证，不依赖已拒绝的动态惯量拟合。目标由live文件自动更新，无新增就绪/点击记录步骤。

> 新版完整反馈+BYAW6已有用户确认5秒成功：corner_immediate_kw040_yaw6_trial5s_01，80/5/−.04三轴、BYAW6、BTRIM0、旧23.4399°/50°，1°/2秒、6V及原保护。5.000秒正常定时结束，maxTilt2.116°，peakRate0.252、peakYaw0.239rad/s，M1max127/M3max76rad/s，无保护。用户“可观测到的稳定平衡 纠偏现象明显 没有外界干扰”，已确认本轮为计时结束。备份corner_immediate_verified5s_profile.json。M3末1秒速度仍增加约60.8rad/s²，尚不能证明长期稳定；下一步**同参数8秒**，不要因为短时成功更新为长期自动默认。窗口持续、原现场条件沿用，无额外就绪确认。

> M3−.050候选未改善：corner_immediate_kw040_040_050_trial5s_01，3.203秒Rate1.669保护，Tilt2.71°，M3−189.91/U3−6V。按参考重力投影，保护帧竖直自转约−1.522rad/s，倾斜平面角速度约0.684；上一轮全−.04的8秒试验保护帧也主要含竖直分量（约−1.38）。下一组恢复三轴Kw−.040，仅BYAW3->6，提高独立自转阻尼，保持80/5、原参考及所有保护，先5秒自动等入位。不要提高总角速度保护掩盖自转。此段为最新待执行候选；尚未进行BYAW6实测。

> 新版8秒复测未完成：corner_immediate_kw040_trial8s_01，实际4.688秒因主机Rate1.593>1.5保护，Tilt3.09°，Wx1.473为主，M3−198.63rad/s/U3−6V，M1−81.34/U1−4.03，M2+76.46/U2+1.07。不是定时停机或轮速保护；最终EN000/Bal0/Fault0。说明新版3秒恢复效果尚不能代表8秒稳定。下一组仅M3 Kw−.040->−.050（M1/M2−.040），保持80/5及其他全部参数，先5秒自动等同一目标验证。此前全三轴−.050提议从未执行；本轮是M3单轴系数候选。用户原现场条件沿用，无需重复确认。

> 新版立即反馈3秒完成：corner_immediate_kw040_trial3s_01，80/5/−.040、BYAW3、旧参考，maxTilt3.221°、peakRate0.400rad/s，M1最大128/M3最大144rad/s。前450ms输出重建误差：全轮速项RMSE0.0109V、无轮速项0.381V，支持新版已从初期启用完整反馈。用户反馈“有纠偏动作并保持平衡 后续自己倒了 感觉是正常停机 可以延长时间便于观察”，按原无干扰条件记入summary；仍未证明长期稳定。曾提议Kw−.050但**未执行**，用户要求延长观察后，下一轮保持同80/5/−.040，仅时长改为8秒，原保护不变。无需重校准或重复确认，脚本自动等扶到同一目标。源码/烧录版本仍为corner-immediate SHA a0f7e60a...。

> 最新固件修复/待测：旧延迟版本Kw−.04的5秒复测在1.328秒保护（com_kwminus040_full_trial5s_01），此前3秒成功不稳定。用户提出加强起始角加速度。发现单点轮速反馈仍在前500ms为0、1500ms才全量，已改为单点接管首个周期完整反馈；单点入位/倒计时/交接均新增三轴有效、轮速<5rad/s门槛，单边原斜坡保留。生产C回归新增首20ms内轮速项生效、飞轮转快取消倒计时及交接空隙重新入位的验证；控制/UART测试通过。ARMCC38输入0错0警告，新HEX `Cubli-ST/MDK-ARM/CubeMX-corner-immediate/CubeMX.hex` 已烧录校验，SHA256 a0f7e60a18407babbfa501e97dcffb76aa9c967ab37d4bb0ed8e86021c7d4ada，50060数据字节。用户明确新自检“就绪”，corner_immediate_prep_01已完成三轴Pass、映射3/1/2、Cal1/Aligned111/EN000/Fault0。下一步同80/5/−.04、BYAW3/BTRIM0、旧参考、1°/2秒、6V原保护，先3秒自动等入位验证。没有改ACC或提高电压/保护；尚未更新生产上位机默认增益。只读窗口PID21652持续运行，调试脚本自动借用串口。

> 新完整闭环已获3秒自主成功：com_kwminus040_full_trial3s_01恢复80/5，仅Kw−0.030->−0.040三轴，BYAW3、BTRIM0、旧23.4399°/50°参考，1°/2秒、6V、原保护。完整3.000秒，最大倾角1.542°，M1−77.04～7.95、M2−13.67～13.54、M3−30.54～69.83rad/s，无保护。用户明确“这一组效果比较不错 没有外界干扰 平衡状态不错”，已记录hands_off/cable_free。备份corner_kwminus040_verified3s_profile.json。下一步同参数5秒自动等待入位复测；尚未修改生产默认或宣称长期平衡。此段为最新成功记录。

> 当前M1角点脉冲对照完成：+3V80ms末段gyroY约+0.57rad/s，−3V80ms约−0.58rad/s，支持原BDIR1=-1，正反对照见com_m1_corner_paired_direction_review.json。脉冲都有显著X/Z耦合，不能据此得出完整惯量。已纠正Kw0后继续扫PD的路线：电压控制下负Kw兼含反电势补偿及稳定轮速反馈，不能只看加性电压判符号。简化物理推导和限制见《单点轮速反馈与反电势分析_2026-10-16.md》。下一轮恢复完整80/5反馈，将Kw改为−0.040三轴，BYAW3、旧参考、1°/2秒、6V及原保护不变，最多3秒；自动等扶回窗口，不要求重复确认。新值未实测，不能写生产默认。此段为最新接续动作。

> 最新结果/转向识别：80/10/0和120/8/0均约1.062秒保护，80/8/0为2.187秒，全部M1接近−165rad/s且−6V。用户对这三组明确反馈“效果一样烂 直接一边倒 没有外界干扰”，已统一记入三组summary，停止继续扩大增益。探索性角动量拟合的惯量主值违反三角不等式（虽SPD仍不可实现），且留出误差大，已在com_exploratory_momentum_fit_review.json明确拒绝用于调参/参考；其中23.54/49.19不能当新目标。轮速电压拟合仅为观测，见com_wheel_voltage_response_review.json，不能当已标定力矩/电流。下一步用serial_corner_trial.py新增--probe-motor测当前角支撑下实际机体响应：零输出角点倒计时，PG6亮松手后等0.35秒，完全失能并切到选定边沿模式，再BPROBE ±3V80ms；MCU独立限时/限速/角度，主机保留保护。28项模拟诊断测试通过（含正负脉冲、切换前失能、边沿FAST完整gyro、缺样本/错轴使能拒绝及退出STOP），未烧录。试验需--kp0 --kd0 --kw0 0 0 --yaw-damping0 --voltage3 --wheel-bound60 --seconds1，仍原参考/1°/2秒。先M1正脉冲，后负脉冲分别自动等入位，完成后用gyroY及wheel变化对照。沿用既定现场条件，不反复询问相同事项。

> 调参已恢复：用户指出任务不应在修好窗口后结束。已按原授权继续有界试验，不再每轮要求回复就绪；发出本轮参数/PG6松手提示后，固件自动等待扶回同一目标。Kd8/Kw0第一次被脚本重复的“先静止再装载已知参考”门槛挡住，active0（com_kd8_kwzero_trial3s_01）。已修复固定参考路径：保留低轮速/失能/新鲜数据条件，取消重复手扶采集检查，BREF后由MCU按1°/2秒判断入位；主机机体角度/角速度保护仅在接管后生效，允许失能时搬动入位。新增--wait-seconds默认180秒，运行仍有界，24项诊断测试通过。com_kd8_kwzero_trial3s_02用80/8/0/0、BYAW3、旧参考，接管2.187秒后Rate1.919触发保护、M1−6V，最终失能；本轮无新现场反馈，不能把时长差归因为Kd。下一组仅Kd8->10，最多3秒、原参考和保护不变；待自动入位后观察，不能把试验增益写进生产默认。此段为最新进展，下面“停止继续运动试验”为已完成的界面修复阶段背景。

> 2026-10-16界面修复为最新工作：用户要求去掉反复确认/记录及入位提示自行暂停，已停止继续运动试验。零输出1秒数据保存为com_zero_output_trial1s_01*，全部FAST的U1/U2/U3为0、偏差最大1.21°、未触发保护；尚无新的明确无手扶现场反馈，不能记为平衡成功或真实重心。辅助pose_monitor.py现为简洁持续角度窗口：无记录按钮/绘图/采样超时；用`--port COM7 --live-file .codex-debug/20261016-com-validation/live.json`启动。已运行PID21652，持续只读串口；不发任何指令或PING，不能用它替代测试心跳。脚本serial_corner_trial/serial_corner_auto/corner_auto_prep通过SerialMonitorHandoff自动借用串口，退出后窗口自动恢复；后续不再启动serial_passive_pose.py，也不再写capture.json来停采样。测试脚本需继续传同一个--live-state文件。其它需要串口的脚本也应使用handoff，或先正常关闭只读窗口。9项窗口/交接/重连测试及23项原诊断测试通过，实机只读交接及自动恢复刷新已通过，记录pose_monitor_continuous_validation.json。最新设备EN000/Bal0/Fault0/Aligned111/Cal1。临时试验留下LQR各项0、BYAW0，电机失能；后续有意恢复运动时必须由试验脚本完整加载指定参数，不能直接使能。只沿用原支点；用户说“就绪”用于同步开测时机，不能反复核对相同支点、线材、电池和松手条件。以下段落为历史，优先使用本段。

> 最新隔离结果：com_kwzero_trial3s_01中三轴Kw=0仍在1.266秒触发主机角速度保护，守卫帧Tilt7.87°/Rate1.652rad/s，M1U−6V、M2U0.63V、M3U−4.78V；轮速−167/39/−75rad/s，未触发轮速保护。反馈1751Hz/Errors0，最终EN000/Bal0/Fault0。去掉轮速反馈不足以稳定，不能把−0.030直接认定为唯一错误。用户要求不反复确认同样松手/线材条件，但Kw0这一轮尚无新的明确现场观察，hands_off_verified保持false。对比见com_kwzero_comparison_review.json。下一步计划最多1秒零输出自由响应：LQR1/2/3均0/0/0/0，BYAW0、BTRIM0、限压1V；旧参考23.4399°/50°、入位1°、倒计时2秒、主机1.5rad/s及10°/固件20°保护不变。该试验只看实际支点附近重力倾倒趋势，不主动恢复；PG6亮松手，倾倒即接住。需要用户重新扶到目标并确认就绪后才执行。生产固件和上位机默认尚未修改。此段为最新断点。

> 最新对照及排查计划：旧23.4399°/50°参考、1°入位也在1.484秒触发角速度保护（1.613rad/s，倾角6.57°），M1/M3为−6V；最终EN000/Bal0/Fault0。用户答“完全一样 不必重复”，按同样立即松手、无干扰、同侧倾倒、机械未调整记录；后续不要反复询问相同条件。com_reference_comparison_review.json包含新旧失败与历史成功的陀螺积分核对及输出分解。轮速负增益−0.030在u公式里形成+0.030*w，0.5～1.5秒渐入，旧参考1.4秒约给M1增加−5.09V；这只是候选原因，不能仅凭代数判定闭环错误。下一步短测仅将三轴K_w临时置0，保留80/5姿态PD、BYAW3、BTRIM0、旧参考、1°入位、2秒倒计时、6V及原保护，最多3秒。无需烧录、校准结果仍有效时无需重复自检；只读窗口重新扶稳并回复就绪后才启动。不要把Kw0当长期方案或修改生产默认。当前串口采样进程/窗口是否仍运行须核对。

> 用户已确认1°候选试验PG6亮即立即松手、无任何外界干扰、向一侧倾倒。已在summary记录hands_off/cable_free为true，但并未完成5秒。离线轨迹和旧成功基线比较保存在com_candidate_trial5s_cap1_01_review.json。下一步用历史23.4399°/50°参考对照，控制/保护及1°入位不变，先恢复旧目标只读提示、等待用户扶稳后最多5秒试验；不要把旧5秒成功视为长期稳定证明，也不要直接放宽保护或同时调增益。计算候选JSON已记入本轮验证结果。此段为最新反馈及后续动作。

> 最新运动结果：用户同意将本轮入位范围改为1°，仍倒计时2秒。com_candidate_trial5s_cap1_01已接管约1.11秒，角速度1.512rad/s超过主机1.5保护，守卫帧倾角9.75°，三轴U均为−6V；未触发220rad/s轮速保护。反馈约1712Hz、Errors0。最终EN000/Bal0/Fault0，三轴已失能。计算参考尚未验证有效，等待用户确认PG6后是否立即完全松手、是否触碰/线材介入及倾倒或自转现象；不能直接归因为重心误差或更改保护继续试。1°是本轮用户授权参数，软件默认尚未修改。详细原始记录及分析在diagnostics/2026-10-16/com_candidate_trial5s_cap1_01*。此段优先于以下历史。

> 2026-10-16运动验证更新：准备01后在只读入位期间出现完整重启日志，对齐/校准丢失，原因未确认；准备02已重新通过三轴自检与IMU静止校准，映射3/1/2。候选参考24.703°/49.716°的首轮5秒试验未接管：等待60秒内14次倒计时均被打断，最接近时剩595ms，active_samples=0，不能记为平衡失败或成功。结束回读Aligned111/Cal1/EN000/Bal0/Fault0，STOP锁存Trip1。详细记录见diagnostics/2026-10-16/com_candidate_trial5s_01_summary.json。用户明确指出记录按钮只是辅助定位，后续固定参考测试无需点击：只读窗口扶到圆心、回复就绪、PG6亮即松手。2秒/0.5°入位要求保持，未自行放宽；下一步重新等待用户扶稳后同参数5秒验证。以下历史断点优先级低于本段，运行状态须以新鲜回读为准。

> 2026-10-16接续更新：用户已恢复失能静态采样。三个实际挂点计算候选Pitch24.703°/Roll49.716°，RMS几何残差1.185mm，尚未进行电机验证。当前COM7可用，复位后Aligned000/Cal0，旧就绪回复不能替代新运动准备。先读《悬挂重心标定_2026-10-16.md》及diagnostics/2026-10-16/com_threepoint_reference_candidate.json。同点取反/偏移补偿、IMU坐标多点拟合和静态提取工具已实现，几何测试10项通过。以下为早期断点背景。

这是给另一台设备上的Codex的接手入口，无需先读取聊天历史。用户要求把后续工作和断点写入文件；**本次写文件不表示恢复硬件调试**。用户此前明确说“无法静态悬挂，先中断任务等待恢复”。

本文件之前的最新提交为 `84863eb`（MDK产物清理），分支为 `main`。接续时先查看实际Git状态和最新提交。本文件里的路径均相对“无刷闭环联调”目录；换设备后使用实际仓库路径。

## 1. 下一步要完成什么

最终目标是三轴单点长期自主平衡，能自动等待手扶入位、倒计时接管、倒下或持续满速后失能等待；上位机可操作，单电机调试与工作模式分开。三个电机已修复，M1/M2/M3单边已有实机成功记录，单点尚未可靠长期保持。

**下一步优先完成可验证的重心/零重力矩参考识别，停止靠小幅改参考和短时成功来猜重心。** 用户刚提出用数学计算稳定角度，并明确了支撑角和电池位置。静态悬挂当时无法布置，因此恢复时先确认可行测量方法，不要继续重复要求相同的悬挂准备。

待恢复后的顺序：

1. 核对新设备的仓库、依赖、实际串口及失能状态。
2. 与用户确定可行的静态重心测量方法，补齐数据，计算候选重力向量及误差范围。
3. 在失能状态检查候选参考、IMU坐标和支撑角是否一致。
4. 用户确认现场运动测试准备后，重新对齐/静止校准，短时复测，再逐步延长。
5. 若正确参考下仍失稳，识别执行器与惯量，修复动态模型后调整控制器；保持一次只改一个变量。
6. 有充分实测证据后再更新默认配置、上位机说明和自动模式；每完成一个块或有进展提交本地commit。

## 2. 当前暂停状态，不能误当成已就绪

- 所有本会话启动的串口调试进程和只读提示窗口已停止。
- 最近一次有效硬件回读：`EN=000 / Auto=0 / Bal=0 / Fault=0`，来源 `diagnostics/2026-10-15/com_face_m3_up_01_summary.json`。
- 暂停时两次补发STOP后，COM7能打开但没有收到任何RX帧，**没有新的失能确认**。不能声称设备目前仍在线、已供电或当前状态已核实。
- 最后已知板载程序是 `CubeMX-corner-entry2s`。暂停后只清理并重编了文件，没有烧录、没有连接或测试设备。
- 断电/复位会清除电机对齐、映射识别结果和IMU校准；旧的Aligned/Cal状态不能跨设备或跨上电沿用。
- 最近一次实际试验的运行参考是Pitch约23.44°、Roll49.5°，该轮失败。它不是新成功配置，也未写入长期默认配置。
- `review_corner_kwminus04_candidate.json` 只是候选；**−0.040轮速反馈试验尚未下发**。用户随后改为数学标定，再要求暂停。
- 用户早先给出的所有就绪回复均已被暂停指令覆盖，恢复运动前需要新的现场准备确认。

详细机器可读断点：`diagnostics/2026-10-15/geometry_pause_checkpoint.json`。

## 3. 硬件和几何事实

| 项目 | 已知事实 |
| --- | --- |
| 机体 | 约70×70×70mm，3D打印框架 |
| 电机 | 三只2804无刷220KV，7极对，均已修复；之前“M4”就是程序M1 |
| 飞轮 | 已安装锁紧，304不锈钢，厚5mm；外环外径66/内径51mm，中心环外径20/内径16mm（用户描述） |
| CAD差异 | 原DXF中心孔为12mm、螺孔分布圆16mm；不能把未核实的孔径/转子质量当作精确惯量 |
| 质量 | 环体几何估算每轮约59.14g；含辐条的CAD估算约65～68g，均不是实称。框架+主板约50g；电机、整机、电池实称质量未知 |
| 电池 | 所有调试电池均为相同规格3S/约12V、牢固随机体转动。用户最新说明：电池很轻，位于M1旋转轴外侧。不要反复询问是否换规格；精确质量、位置尚未知 |
| 安装 | M1/M2/M3轴互相正交；主板在M2正对面，IMU正面朝外 |
| 支撑角 | M1与M2共有棱、远离M3的那个端点 |
| 线材/限位 | 早期机械限位曾被拆除，不能假定当前存在可靠限位。线材干扰曾实际影响试验，测量/自由平衡时必须不承重 |

### 坐标和符号要区分

- 电机轴对应IMU轴：M1→Y、M2→Z、M3→X，命令 `BAXIS 2 3 1`。
- 已实测机体恢复方向：`BDIR -1 -1 -1`。
- 电机编码器映射：M1→ENC3、M2→ENC1、M3→ENC2；编码器方向均+1，极对数7。以上均需重新自检确认。
- 电机面朝上的静态采样确认：M1面外法向为IMU−Y，M3面外法向为IMU−X。
- M2面采样覆盖了搬动过程，不能用作静态重心数据。主板与M2相对的安装说明已知；M2面的独立静态符号核验尚未完成。
- BDIR是电压到机体恢复作用的符号，编码器方向是读数符号，面外法向是几何符号。三者不能混用。

## 4. 数学路线及未完成部分

以几何中心为原点，以三个电机面朝外的法向e1/e2/e3定义位置投影坐标。此顺序不保证右手系，叉乘动力学需使用正确映射后的IMU坐标；静态距离/直线投影不受该顺序影响。

用户描述的名义支撑点：

```text
P = (35, 35, -35) mm
C = Σ(mi * ci) / Σmi
r = C - P
```

固件的 `attitude.gravity` 实际上是归一化加速度计方向，静止时指向竖直上方。角点零重力矩姿态选择重心在支撑点上方：

```text
g_ref_IMU = B * (C - P) / |C - P|
B = [M1面外法向_IMU, M2面外法向_IMU, M3面外法向_IMU]
Pitch = atan2(gy, sqrt(gx² + gz²))
Roll  = atan2(-gx, gz)
```

如果重心恰在几何中心，位置投影参考为 `(-1,-1,+1)/sqrt(3)`，主板法向与竖直夹角约54.7356°。**这只是均匀几何例，不是当前Cubli的实测参考。** 三套相同重轮安装在三个面上不会自动让重心落到几何中心，主板和外置电池也会移动重心。

### 可行方法优先级

**A. 如果以后可以从实际支撑角悬挂：一次静态测量直接求姿态。**

```text
同一个物理点P悬挂：C = P - λ * g_up_hang
该点作为下方支点平衡：g_ref = -g_up_hang
```

只求角度不需要称重、重心高度或三电机面符号。必须是实际支撑点；系点若有偏移，不能直接取反当成精确参考。该简化关系已推导写入说明，**还没有集成到工具，也没有真实悬挂数据**。

**B. 已知两个以上挂点：求完整重心坐标。**

每次自由静态悬挂满足 `C = Pi - λi * g_up_i`。两条不平行重力线可解C，三次以上可检查误差。离线工具 `diagnostics/corner_com_geometry.py` 已实现最小二乘交点、近乎平行拒绝、残差和重心位于挂点下方的检查；不打开串口。七项合成几何检查通过，仅证明数学实现，没有真实COM结果。

现有输入/输出：`diagnostics/2026-10-15/corner_com_geometry_inputs.json`、`corner_com_geometry_result.json`、`corner_com_geometry_verification.json`。输入中签名面法向仍为null、悬挂观测为空，当前结果明确 `actual_com_reference_available=false`。

**C. 用户暂时无法悬挂：选择可执行的替代测量。**

可考虑测量组件质量和实际重心位置，或通过已知支点/多次支撑称重识别整机重心。设计方法时明确可观测量、支点坐标和误差；不要用未经测量的电机质量、手扶力最小的位置、软桌面站立或有持续飞轮加速时的平均姿态替代重心数据。

### 我原本准备继续做的代码工作

1. 为离线工具补充同角悬挂取反入口，明确“只识别参考方向”与“已求得三维重心坐标”的差别；保留未验证标记。
2. 完善静态数据提取：逐样本重建/平均归一化重力向量，检查姿态散布、角速度、飞轮静止与全程失能。不要直接平均可能跨±180°或接近Pitch±90°的Euler角。
3. 只接受可复核的静态测量，输出候选参考、置信/误差指标和来源文件；不自动改上位机默认值、不自动启动电机。
4. 测量方法可行且数据满足条件后，再做候选参考的有界实机验证。

零重力矩姿态仍是倒立摆的开环不稳定平衡点。正确参考是必要步骤，不能替代控制器稳定性与可用力矩分析。

## 5. 已验证结果与失败记录

所有下表记录在 `diagnostics/2026-10-15/`，原始串口为同名jsonl，结果为同名 `_summary.json`。有现场确认的标记已写回summary，原始串口不改。

| 记录 | 入位/参考 | 结果 |
| --- | --- | --- |
| `review_baseline_battery02_trial5s_01` | 8秒倒计时、2°窗口；23.44°/50°；80/5/−0.030/0 | 确认5秒全程无干预，定时停机后才接住；最大总倾角2.0246°，M1最大绝对轮速157.11rad/s |
| `review_baseline_battery02_trial8s_01` | 同一参考与控制，目标运行8秒 | 约1.312秒角速度保护；用户确认立即松手，主要向一侧倾倒 |
| `review_entry2s_halfdeg_trial8s_01` | 用户要求的新2秒/0.5°入位；50°参考 | 约2.844秒停机；M1−220.41rad/s、Rate1.654rad/s同时越过主机轮速/角速度阈值；短暂保持后倾倒，全程无干预 |
| `review_entry2s_roll49p5_trial8s_01` | 只把Roll参考改为49.5° | 约1.5秒角速度保护；M1/M3输出均达6V限幅；同一支撑角，全程无干预 |

原始成功配置：`diagnostics/2026-10-14/corner_balance_verified5s_profile.json`。审阅后复现配置：`diagnostics/2026-10-15/review_corner_verified5s_profile.json`。只验证有限5秒，不能称为长期稳定；2秒/0.5°新条件尚无8秒成功证据。

旧agent记录的13.7秒不能作为全程自主最长成绩：原始对话有“第五轮失控了，人为纠正的”。`单点长期平衡联调说明.md` 已加更正，原文保留供追溯。

### 已知分析边界

- 最近试验中编码器读取约1790～2220Hz，单次约124～125us，最大间隔约3.1ms，Errors=0。现有记录不支持直接把失败归因为“编码器读取太慢”，但也未覆盖所有高速状态。
- 新条件失败前，姿态接近参考时M1仍从约156升至186rad/s，电压逼近6V，随后失稳。这是记录中的现象，根因还未确定。
- 轮速阈值触发时角速度也已超限，不能靠提高超速阈值宣称问题解决。
- 互补滤波的加速度修正时间常数约0.25秒。可检查动态线加速度、滤波修正与陀螺仪积分的一致性，尚未证实它是根因。
- BLDCMotor的速度前馈用于调速路径；平衡LQR直接输出Uq，修改速度FF不能直接视为单点控制器修复。

## 6. 当前固件、参数和脚本

最后已知板载：`Cubli-ST/MDK-ARM/CubeMX-corner-entry2s/CubeMX.hex`，SHA256：

```text
8d3800e442928edd8708c7e19a85f0d57dcf4c282886c4364263161107270187
```

清理后默认 `Cubli-ST/MDK-ARM/CubeMX/CubeMX.hex` 与它逐字节相同。`CubeMX-quad` 是当前源码的硬件正交编译版，**尚未物理验证，不要把它当成当前板上编码器路径**；当前最后确认 `EncType=0`，使用I2C绝对位置。正交PPR宏默认1024、四倍频4096，实际模块配置仍需实物核对。

新单点默认：2秒倒计时、0.5°总倾角窗口，离开后重走完整倒计时；自动模式先有1秒稳定确认，再开始2秒倒计时。末尾0.5秒低角速度检查保留。BTRIM在固件、上位机、自动与限时脚本默认均为0。

| 参数 | 当前基线/限制 |
| --- | --- |
| 三轴LQR | 80 / 5 / −0.030 / 0 |
| BYAW | 3 |
| U、BU | 6V |
| 有界试验硬轮速L | 240rad/s |
| 有界试验主机阈值 | 轮速220rad/s、总倾角10°、总角速度1.5rad/s |
| 固件倾倒保护 | 20° |
| 自动模式 | L330，满速250rad/s持续3秒保护；L必须大于BFULL，否则BAUTO拒绝 |

0.5°/2秒是用户明确要求，不能为了容易接管而静默放宽。复现旧5秒结果若需要8秒/2°，先明确说明是在做旧基线对照，不能混记成新条件成功。

脚本作用：

- `diagnostics/serial_passive_pose.py`：PING/STOP/状态与失能姿态采样，绝不启动电机；tag不能重复。默认输出目录仍是2026-10-14，采样结束后再移到正确日期归档。
- `diagnostics/corner_auto_prep.py`：三轴TEST会实际转动飞轮，然后静止IMU校准；只在新的现场悬空/静止确认后运行。stdout/stderr已修复为UTF-8，避免启动残片触发GBK日志异常。
- `diagnostics/serial_corner_trial.py`：有界试验，支持 `--countdown 2 --capture-angle 0.5`、固定 `--reference-gravity`、逐轴Kw、独立BYAW；退出必STOP并确认失能。
- `diagnostics/serial_corner_auto.py`：长期自动记录，有自动重入；当前阶段先用有界试验，不要直接启动无限运行。
- `Software/pose_monitor.py`：只读JSON提示窗口，不占串口；窗口启动用pythonw正常显示，之前用隐藏窗口参数导致用户看不到。`live_pose.py` 已支持0.5°提示圈和实时CountMs。
- 每次串口只能由一个程序占用。停止只读采样并关闭端口后，再启动下一脚本。

静止IMU校准不要求水平，只要求机体不动。仅做静态重心识别时不必为了读姿态而运行会转动飞轮的三轴TEST。

## 7. 动态模型：哪些结论已经撤回

`diagnostics/corner_loop_model.py` 的旧实现存在重力坐标项、内部反作用力处理、按最稳定极点反推轮轴符号等问题，增益推荐已撤下；当前命令打印说明并返回2，这是有意行为。原实现可从Git `f7f7733` 查阅。

`analyze_corner_windup.py --settle` 只输出描述性拟合及实验姿态候选；不能从有持续飞轮加速时的平均姿态证明真实重心，更不能承诺“两三轮必然收敛”。旧−0.05试验同时改过Ki，不能拿来否决Ki=0时的独立Kw对照。−0.040仍只是未执行的候选，数学标定优先。

如需重建动力学，先在统一的IMU右手坐标中定义惯量、轮轴符号和重力方向。例如固定支撑点的角动量方程可写为：

```text
Jp * omega_dot + omega × (Jp*omega + Hwheel) + Hwheel_dot
    = -m*g0 * (C-P) × g_up
Hwheel = N * diag(Jwheel) * wheel_speed_relative
```

其中Jp含锁定轮组随机体转动的惯量；内部电磁/摩擦反作用不能只加在轮上，外部空气阻力需区分；支撑点必须实际固定且无手/线材额外力矩。符号来自实测，不能根据希望得到稳定极点而选择。正确的静态参考也不自动保证闭环稳定。

## 8. 新设备环境与验证命令

原仓库位于 `D:\Document\tempPrj\Cubli-F407ZGT6`，项目为其下“无刷闭环联调”。原串口为COM7、115200、旧板USART2的PD5/PD6；新设备必须重新枚举，不得假定仍是COM7。原ST-LINK使用STM32CubeProgrammer CLI、SWD约1MHz；不能假定新设备装好或已连接。

Python原环境为3.10，有pyserial、numpy、PyQt5、pyqtgraph。MSVC用于生产C模拟测试，ARMCC用于固件。构建器可用 `KEIL_ARMCC_BIN` 指定工具目录；Windows中文路径会临时映射ASCII盘符。

下面命令从仓库根目录运行，均为离线检查：

```powershell
python -m serial.tools.list_ports
python -m unittest discover -s "无刷闭环联调/tests" -p "test_corner_diagnostic.py"
python -m unittest discover -s "无刷闭环联调/tests" -p "test_upper_computer.py"
python "无刷闭环联调/tests/run_firmware_tests.py"
python "无刷闭环联调/tests/run_quad_tests.py"
```

本轮已通过生产控制/UART模拟测试、23项单点诊断、38项上位机测试；正交寄存器/计数/PPR模拟检查也通过。只改文档或离线记录不必重复全部测试；控制代码变更要跑相应检查。

从Cubli-ST目录重编：

```powershell
python build_firmware.py --encoder i2c
python build_firmware.py --encoder quad
```

清理后这两个入口均实测38个输入、0错误0警告。**不要删除 `MDK-ARM/CubeMX/CubeMX.lnp` 和 `CubeMX.sct`**，它们是构建依赖。当前MDK只保留8组有价值版本，43个文件、约4.11MiB；索引在 `Cubli-ST/MDK-ARM/README.md`，清单在 `cleanup_manifest.json`。被删旧产物可从清理前 `6bb714b` 恢复，不必恢复整套中间文件。

## 9. 接续约定及应先读的文件

- 每完成一个块或有进展提交本地commit。不要擅自push、给其他聊天/人员发消息或创建后台定时任务。
- 不反复询问相同电池规格；需要询问的是当前连接、机械准备和实际测量信息。
- 用户非常在意不必要的确认；已授权的离线分析/修复继续做。只有新的实际摆放、手离开、三轮悬空等无法从软件判断的条件才询问。
- 不将手扶、限位端点、软桌面、线材承重或保护前后扶回的数据记为自由平衡。短时成功后也记录完整现场反馈。
- 不以扩大保护来掩盖电压饱和/角速度失稳，不盲目翻转已经实测的方向。
- 初始就存在 `主控板原理图审查报告_2026-10-07.md` 的未提交删除，用户内容，不要顺手恢复或纳入其他提交。
- 本机原始全量备份 `无刷闭环联调.7z` 保持不变，但它被Git忽略；新设备不一定有它。接续应以已提交源码、profile、原始日志和本文件为依据。

建议先读：

1. 本文件。
2. `数学建模与暂停断点_2026-10-15.md`、`diagnostics/2026-10-15/geometry_pause_checkpoint.json`。
3. `diagnostics/corner_com_geometry.py` 和对应输入/合成验证JSON。
4. `diagnostics/2026-10-15/review_corner_verified5s_profile.json`，再看上表失败轮的原始日志。
5. `接手审阅_2026-10-15.md`、`Software/单点调试.md`、`Cubli-ST/MDK-ARM/README.md`。

把本文件连同包含本次提交的仓库同步到另一台设备即可；不依赖本机忽略目录 `.codex-debug`、已关闭的窗口或本机zcode历史数据库。
