TDX33029/Cubli-STM32F407-ESP32/Firmware/单点轮速反馈与反电势分析_2026-10-16.md

# 电压控制下的轮速项：本轮调参依据与限制

本轮M1角点正负3V/80ms脉冲分别产生Y正/负响应，支持原BDIR1=-1。代码为`u=-Kp*e-Kd*omega-Kw*w`；负Kw在电压指令里形成正的轮速项，不能仅凭这一项会增加同向电压，就认定符号错误。

在单自由度、固定支点的小角度近似中，定义轮速电压系数`ks=-Kw`，电机近似为`w_dot=a*(u-ke*w)`，机体为`theta_ddot=G*theta+C*w_dot`，其中a、G、C均为正。令`delta=ks-ke`，无积分时特征多项式为：

`lambda^3 + a*(C*Kd-delta)*lambda^2 + (C*a*Kp-G)*lambda + a*delta*G`。

在这个近似模型里，delta为负会使常数项为负，存在正实根；因此把Kw设0之后，继续只调Kp/Kd不能作为长期稳定整定路线。Kw=0短测只能隔离响应，之前沿此状态继续扫增益的路线已停止。三轴角点仍有惯量耦合、自转、饱和与采样误差，这个一维结论不能给出完整三轴稳定性证明。

本轮电压/轮速短窗观测给M1的有效ke约0.028V/(rad/s)，见`diagnostics/2026-10-16/com_wheel_voltage_response_review.json`。它不是精密电机常数或电流/力矩标定，尤其M2激励不足、部分拟合病态；不能据此提高电压或保护阈值。

近似稳态还说明参考偏差的重要性：在实际重力中性点，若参考偏移为`theta_ref`，则`w_eq=-Kp*theta_ref/delta`。例如仅作为量级说明，Kp80、参考误差0.5°、ke0.028时，ks0.030对应约349rad/s，ks0.040对应约58rad/s。小delta会使很小的参考误差要求很高的轮速，电压饱和后恢复力不足。数值不能当作对本机的精确预测。

下一次仅将历史完整闭环80/5/-0.030/0中的轮速项改为-0.040，保留BYAW3、BTRIM0、旧参考23.4399°/50°、1°入位/2秒倒计时、6V及原保护，先最多3秒。新系数是待验证候选，不写进生产默认；失败后应继续识别三轴耦合及参考偏差，而不是无限提高增益。

探索性角动量联合拟合已拒绝用于调参：虽拟合矩阵正定，其主惯量违反三角不等式，且留出误差大。`com_exploratory_momentum_fit_review.json`里的23.54°/49.19°不能当作新平衡参考。本文依据也不是已撤回的`corner_loop_model.py`建议。
