TDX33029/Cubli-STM32F407-ESP32/Firmware/悬挂重心标定_2026-10-16.md

# 悬挂重心标定进度（2026-10-16）

## 后续运动验证更新

候选24.703°/49.716°已进行有界验证：0.5°入位首轮等待超时，没有接管。用户随后授权将本轮入位改为1°，2秒倒计时及80/5/−0.030/0、BYAW3、BTRIM0、6V和保护保持不变。实际接管约1.11秒，用户确认PG6亮立即松手、无其他干扰、向一侧倾倒。角速度1.512rad/s触发主机1.5rad/s保护，守卫帧倾角9.75°，三轴输出均达到−6V；并非轮速保护。最终三轴失能，Fault0。

记录为`diagnostics/2026-10-16/com_candidate_trial5s_cap1_01*`。前0.25秒偏差由0.90°缩小到0.61°，之后扩大，M3/M1约0.907/0.938秒首次达到6V限压。反馈1712Hz、读取Errors0。这些数据不足以单独认定方向、增益或重心误差。1.185mm拟合残差在约59.43mm重心距离上对应约1.14°的长度/角度尺度，**不是角度置信区间或误差上界**。数学候选仍未通过自主平衡验证。

下一步做历史23.4399°/50°参考对照，保持1°入位、2秒倒计时和相同控制/保护，最多5秒；需要用户重新扶到目标后才启动。固定参考试验无需点击记录按钮，只读窗口辅助扶稳并回复就绪即可。以下内容为标定完成时的静态记录与原试验计划。

用户恢复了静态测量；本轮全部电机失能，没有启动电机或平衡，没有烧录。ST-LINK热连接只读核对49940个程序字节，与entry2s固件一致，DHCSR未显示内核暂停；CH340重新插拔后恢复COM7。设备已复位，Aligned=000、Cal=0，不能沿用上一轮对齐结果。

## 挂点与方法

原支撑角为M1/M2共有棱远离M3的一端，定义为IMU坐标原点P。约70mm棱朝M3方向对应IMU−X。M1面外法向−Y、M3面外法向−X有面朝上采样支持；M2外法向−Z结合主板相对面安装说明及本次几何核验，未冒称M2此前有合格的静态面测量。面轴按正交坐标近似。

| 挂点 | 用户确认的实际位置 | 相对P的IMU坐标/mm | 样本数 |
| --- | --- | --- | --- |
| Q1 | M1/M2棱，距原支撑尖端朝M3方向约3mm | [−3,0,0] | 400 |
| Q2 | 同棱靠近M3的尖端，无偏移 | [−70,0,0] | 399 |
| Q3 | 实际是M1/M3共有棱中点，经用户明确纠正 | [−70,0,35] | 400 |

用户确认Q1的20秒没有触碰，机体离地约10mm。Q2/Q3均在就绪后连续20秒采集，结束后明确通知可以触碰。全部遥测EN000、Bal0、Auto0，无驱动故障。

静态分析逐样本归一化原始加速度，再做向量平均；滤波Euler角重建向量作交叉比较。悬挂关系为 `C=Qi−λi*g_up_i`，λi>0。多个重力线在同一坐标系中作最小二乘交点，得到原支撑点到重心的向量；平衡参考为 `(C−P)/|C−P|`。

同点直接取反只有挂点恰好等于支撑点才成立。Q1偏移3mm，不能直接用其取反值作为P的参考。工具已加入偏移检查；非零偏移却没有重心距离或多点测量时拒绝单点计算。

## 结果：候选，尚未实机验证

- P到重心约[−41.186,24.836,34.909]mm（IMU坐标）。
- 归一化参考约[−0.693037404,0.417914491,0.587406703]。
- 对应Pitch约24.703°、Roll约49.716°。
- 名义几何中心到重心偏移约[−6.186,−10.164,−0.091]mm。
- 三条线距拟合交点约1.523/1.355/0.237mm，RMS约1.185mm，条件数约2.293。
- 与原23.4399°/50°参考夹角约1.289°。
- 滤波姿态向量复算约24.820°/49.663°；当前陀螺仪尚未做本次静止校准，因此以原始加速度均值为主。

这不是0.01°精度的标定，也不是长期稳定的证明。尺寸/受力点为人工近似，数据线附加力矩及加速度偏置没有独立消除；拟合残差和统计散布不能作为严格的参考角误差上界。neutral_verified和physical_balance_verified均保持false，尚未改上位机默认参考。

## 错误模型与原始记录

Q3最初被描述成M1/M2棱中点。按错误位置计算，第三重力方向偏离前两方向所在平面30.25°，拟合RMS16.11mm，工具拒绝产生参考。用户确认实际是M1/M3棱后，才改用实际坐标；拒绝记录保存为 `com_initial_wrong_edge_model_rejection.json`。不能为了凑结果静默移动挂点坐标。

更早的com_same_corner_hang_01、com_same_corner_hang_response_01、com_same_corner_hang_settle_01姿态互相不一致，用户说“重新，刚才不对”，已排除，不参与本次计算；日志留在2026-10-15目录。此前27.4°/49.2°临时候选不可继续使用。

本次有效日志在 `diagnostics/2026-10-16/`：com_same_corner_hang_redo_02、com_edge_hang_point2_01、com_edge_hang_midpoint_01，各有jsonl、summary和analysis。计算输入为com_threepoint_inputs.json，候选为com_threepoint_reference_candidate.json。

## 离线复现与下一步

从仓库根目录运行：

```powershell
python 无刷闭环联调/diagnostics/analyze_static_suspension.py --log 无刷闭环联调/diagnostics/2026-10-16/com_same_corner_hang_redo_02.jsonl --output SUMMARY.json
python 无刷闭环联调/diagnostics/corner_com_geometry.py --support-frame-input 无刷闭环联调/diagnostics/2026-10-16/com_threepoint_inputs.json --output RESULT.json
python -m unittest discover -s 无刷闭环联调/tests -p test_corner_com_geometry.py
```

工具及测试不访问串口。10项几何测试通过，包括已知重心恢复、坐标变换、平行不可观测、上下方向、偏移必须补偿、不一致第三点不得产生参考。

下一步：用户将机体放稳、确认三飞轮自由后，重新自检及IMU校准；失能加载数学候选，用2秒倒计时/0.5°入位进行最多5秒单点试验。三轴80/5/−0.030/0、BYAW3、BTRIM0、U/BU6及原保护不变：硬轮速240、主机220rad/s、总倾角10°、角速度1.5rad/s，固件20°。没有执行−0.040候选，不放宽保护。

若仍有持续轮速积累，继续核查挂点/线材误差、加速度偏置、静态候选复现及动态控制；不能直接认定数学角度精确或套用已撤回的模型建议。
