TDX33029/Cubli-STM32F407-ESP32/Firmware/接手审阅_2026-10-15.md

# 单点控制接手审阅（2026-10-15）

## 决定与可恢复性

继续当前工程，选择性恢复已验证控制配置，不全目录覆盖。保留单点BAUTO、三轴入位门控、倒计时、20°/满速保护、上位机按钮、日志及后续提交；不接受未经验证的模型推荐和“长期成功”认定。

原始7z保持不变，已解压到忽略目录 `.codex-debug/20261015-review/backup`。核心文件 `lqr_balance.c`、`main.c`、上位机 `main.py` 除换行格式外与昨晚基线 `d7a2abe` 完全一致。比较散列保存在 `diagnostics/2026-10-15/review_backup_comparison.json`。后续工作原始版本为 `f7f7733`，全部历史均保留。工作区原有原理图报告删除不纳入本次提交。

## 证据

已只读核对本机zcode中“Cubli-F407ZGT6/单点平衡审阅”的对应会话，session为 `sess_3900eae3-95fa-479c-b711-b2846cad4de0`。只提取该会话；导出置于忽略目录，数据库不修改。分享网址是SPA外壳，因此以本机原始对话和磁盘日志为核对依据。

昨晚 `d7a2abe` 有用户明确确认的5秒单点自由平衡。后续记录存在8～13.7秒控制段，但原始对话明确写过“第五轮失控了，人为纠正的”；无法把第五组13.7秒记为干净最长成绩。所有后续summary中的 `hands_off_verified`/`cable_free_verified` 也需结合现场确认，不能用持续时间替代。

接手初始串口COM7回读：三轴失能、Auto=0、Fault=0、Aligned=000、Cal=0；说明本次上电后需重新对齐/静止校准。当前编码器路径为I2C（EncType=0），硬件正交计数尚未进行实物核验。审阅期间没有启用电机或平衡。

## 修正

1. 固件启动、上位机单点配置、自动脚本统一BTRIM=0，保留昨晚三轴80/5/−0.030/0、BYAW=3和23.4399°/50°参考。积分关闭时不积累隐藏状态；显式实验积分的符号跟随机体方向，现有全−1安装的显式开启行为保持原数值符号。
2. 自动脚本即使要求BTRIM=0也必须回读确认，不能忽略“关闭未生效”。日志prep改为独占创建，避免同名覆盖已有试验。
3. 原闭环模型撤下，命令入口打印原因并返回失败码2，不再扫描或推荐增益。原实现保存在Git，不以另一个未经实测的模型替换。
4. 爬坡分析继续输出描述性拟合和实验姿态候选，撤销重心已识别、固定轮次收敛等承诺。串口记录不能单独区分重力偏置、轮速反馈、执行器饱和和人为接触。
5. MSVC测试入口显式设UTF-8代码页，修复vcvars/中文路径导致的头文件查找失败。此前只写mbcs不能保证子进程代码页一致。

## 模型审阅理由

在 `p=g-R`、`gdot=g×ω` 定义下，重力矩的线性方向应为 `g×R = −skew(R)p`（再乘惯量/质量项）；原 `A_GRAV*(I−RRᵀ)*p` 把重力向量扰动直接当成角加速度，混淆坐标。飞轮方程考虑了与转速有关的衰减，机体方程却只取电压力矩；辨识衰减包含反电动势/内部摩擦，必须区分其机体反作用与外部空气阻力。通过挑选最稳定极点反推轮轴符号属于循环论证。还需消除归一化约束及关闭积分器的虚假零模态。

这些是模型结构问题，不能直接归因于“未建模延迟”。需要基于实测极性、惯量和高速电机能力重新建模后，才有资格辅助调参。

## 验证与下一步

软件检查：生产C控制/串口harness通过；正交计数三种有效配置和两种非法PPR检查通过；上位机38项通过；单点诊断19项通过。增加了默认控制律与昨晚公式等价、关闭积分必须确认、实验积分方向的回归检查。FAST物理边界估计246字节，小于现有280字节预留；未发现因新增trim字段必然截帧的问题。

构建、烧录及最终板端回读记录在本文件末尾追加。编译/烧录成功不代表平衡实测成功。

下一轮先确认三只飞轮悬空、机体静止，重新三轴对齐与校准；加载固定基线，先重复5秒无干预试验，再逐步延长。保持参考/增益/电压一次只改一个变量，并记录是否碰触、扶回或线材支撑。先核对飞轮加速度与姿态误差、输出饱和的时间关系，再讨论重心参考或动量回收；不直接照旧模型把Kw改0或正值。接手前设备是否具备限位不能假定，运动前需现场确认。

## 构建和板端核验结果

源码修正提交 `8d66a79`。ARMCC全量编译38个输入、0错误0警告，产物 `Cubli-ST/MDK-ARM/CubeMX-corner-reviewed/CubeMX.hex`。ST-LINK使用SWD约950kHz、复位下连接，写入后显示 `Download verified successfully`。原构建目录和原始HEX未覆盖。

COM7烧录后只下发停机/状态读取，确认 `BTrim=0.0 / TrimTune=1 / BYAW=3 / CornerStart=1 / Auto=0 / Bal=0 / EN=000 / Fault=0`。`Trip=1`来自明确STOP锁存，不是驱动故障；之后关闭串口会使心跳超时保持停机。`Aligned=000 / Cal=0`符合复位清除校准的设计，下一步仍须自检和校准。构建散列、源码提交和完整回读见构建目录 `review_manifest.json`；原始串口数据见2026-10-15的 `review_takeover_postflash*`。

本次没有重新启动平衡，没有新增自由平衡成功结论。已请求现场确认三只飞轮悬空/机体静止，收到就绪后才开始会转动飞轮的自检。

## 现场准备复检

用户确认三轴悬空静止后，COM7逐轴自检成功：M1→ENC3、M2→ENC1、M3→ENC2，方向均+1，极对估计分别6.89/6.91/6.90，配置7。IMU静止校准完成，最终Aligned=111、Cal=1、EN=000、Fault=0。记录见 `diagnostics/2026-10-15/review_baseline_prep_01*`。尚未启动本次平衡试验，正在等待同一支撑角就位。

限时基线脚本也补充了BTRIM=0的显式设置与回读，避免上一实验残留积分影响基线；诊断回归现为21项通过，不涉及固件变动。

换电池复位后已再次自检/静止校准：映射3/1/2、方向均+1、极对估计7.11/7.05/6.93；Aligned=111、Cal=1、EN=000、Fault=0。见 `review_battery_precheck_01*` 与 `review_battery_prep_02*`。用户要求实时入位提示，已启动只读窗口和最长600秒失能姿态采样，候选保存不覆盖固定参考，单点控制仍未启动。

## 换电池后的5秒单点基线复现

记录 `review_baseline_battery02_trial5s_01`，用户明确确认“全程无干预，停机后才接住”。已将对应summary现场核验标志设为true，原始串口jsonl不改。控制参数保持昨晚固定参考23.4399°/50°、三轴80/5/−0.030/0、BYAW3、BTRIM0、U/BU6、硬轮速240、主机220、倾角10°/20°保护；实际5秒按时结束，未触发保护，最终失能。

250个监测样本最大总倾角2.0246°，轮速M1 −157.11～30.21、M2 −35.51～43.21、M3 −33.58～20.56rad/s，最大输出绝对值4.29/1.91/1.54V、角速度模最大0.279rad/s。编码器频率三路2220Hz，最大读间隔约3107us、单次读取约124～125us、Errors=0。这次数据不支持“编码器读取太慢”作为当前单点短时问题的直接解释，尚不能证明高速所有状态均无问题。

M1末尾由峰值157回落至约111rad/s，最后2秒线性斜率约−3.3rad/s²；M2同段约−36.8rad/s²。三轮有动量交换，不能仅凭某一时段斜率就认定恒定重力偏置。下一步同参数8秒观察，不放宽现有保护；仍需重新扶回参考后才启动。此次确认只限5秒，长期自由平衡未验证。

实时窗口最初被隐藏启动参数遮住，已正常显示；保存候选只结束只读采样，不改变固定目标。原始候选与失能采样保存在 `review_battery02_poseguide*`。新成功配置备份为 `review_corner_verified5s_profile.json`，原成功配置保留。

## 首轮8秒延时复测：约1.31秒失稳保护

`review_baseline_battery02_trial8s_01`实际控制约1.312秒即被主机角速度阈值1.5rad/s终止：触发帧Rate=1.877、总倾角约6.63°、M1=−212.90rad/s且U1=−6V，尚未达到220rad/s主机轮速保护；三轴最终已失能。用户确认“立即松手，主要向一侧倾倒”，本轮不记平衡成功，也不归因为运行时长不足或轮速保护太低。

与5秒成功轮相比，控制参数、固定参考、对齐结果未改变；初始FAST姿态由成功轮Pitch23.04°/Roll47.84°变为22.41°/50.06°，起始误差约1.03°却仍快速失败。说明仅看总误差大小不能预测成功。原始分段均值保存在 `review_corner_initial_condition_comparison.json`。这只是起始状态相关性，不能排除支撑位置、手离开过程、执行器或估计误差的影响。

下一轮拟仅调整手扶入位到23.3°/48.5°附近，固件参考仍23.4399°/50°、其他控制/保护不变，最多8秒。提示窗显示的是这次手扶入位建议，不代表新平衡参考。不因这轮失败直接翻转已实测方向、放宽保护或改轮速增益。

## 用户指定接管条件：2秒倒计时与0.5°入位

用户要求将原8秒倒计时改为2秒、2°入位窗口改为0.5°。单点固件模式默认捕获角改0.5°，BSTART/BAUTO支持2～15秒、BCAP支持0.5～10°；单点BAUTO不带时长时默认2秒，单边默认8秒。上位机单点按钮/配置、限时和自动单点脚本均使用BSTART/BAUTO2与BCAP0.5。可选脚本参数允许复现旧入位设置，不改已成功备份的历史profile。

自动入口此前固定3°，现使用配置入位角与3°的较小者，确保0.5°贯穿等待和完整倒计时。若倒计时刚结束、使能前离开窗口，也必须重走完整倒计时，不能再次靠近后直接接管。自动模式原有1秒静止确认保留，之后是2秒倒计时；最终0.5秒角速度检查保留。这次不改固定参考23.4399°/50°、增益、输出限压、倾倒/轮速/角速度保护。

STATE新增CapDeg用于上位机和脚本确认配置。FAST仅在倒计时阶段带CountMs，修复提示窗口此前一直显示0秒的问题，避免增加控制期间持续串口带宽。只读窗口显示并放大0.5°范围，当前提示中心恢复固定平衡目标。

新增生产C状态机用例覆盖0.6°拒绝入位、0.1°入位、精确2秒时长、倒计时中/结束后离位取消及自动入口尊重0.5°；诊断脚本要求CapDeg回读一致，上位机不能在回读仍2°时解锁。后续编译/烧录结果另记；这些软件验证不代表新入位设置已完成实机平衡。

2秒/0.5°源码提交 `80b779f`，ARMCC38个输入0错误0警告，产物 `CubeMX-corner-entry2s/CubeMX.hex`，SWD烧录校验通过。生产控制/串口harness、23项诊断、38项上位机测试通过；另验证提示圈0.5°和FAST剩余时间优先显示。COM7仅失能配置核验确认BMode=4、CapDeg=0.50、BTrim=0、EN=000、Auto=0、Fault=0。新条件下的自由平衡尚未验证；用户随后确认新版校准就绪，正重新执行对齐/静止校准。

新版烧录后第一次准备脚本遇到启动串口残片的U+FFFD，Windows GBK日志输出异常，在开始TEST前退出并执行STOP；已将该脚本stdout/stderr固定UTF-8并替换不可编码字符，避免日志输出破坏流程/清理。第二次真实三轴对齐与校准通过：映射3/1/2、方向均+1、PP估计6.77/6.99/6.89，最终CapDeg=0.50、Aligned=111、Cal=1、EN=000、Fault=0。原始失败与重试记录均保留。正在等待新入位条件下的最多8秒实机复测，新条件尚未记为平衡成功。

## 新2秒/0.5°首次实机接管结果

`review_entry2s_halfdeg_trial8s_01`：首个接管FAST总倾角约0.31°，末次倒计时FAST剩余8ms，新入位逻辑实际执行。用户确认“先短暂保持，随后倾倒，全程无干预”。运行约2.844秒后主机M1轮速保护终止，触发帧M1 −220.41rad/s、U1 −6V、Rate1.654rad/s同时也越过1.5主机角速度阈值，故不能只归因为220rad/s阈值过低。最终三轴失能、Fault0。约2090Hz编码器读取、Errors0。

1.5～2秒平均Tilt0.223°、M1−156.3rad/s、U1−4.56V；2～2.5秒平均Tilt0.407°、M1−186.5rad/s、U1−5.24V。姿态接近目标时仍持续积累轮速，随后电压饱和并失稳。量化记录见同名analysis；这支持继续检查参考/动量控制与可用力矩，不足以确定唯一根因。

下一轮只将Roll参考50°减至49.5°（Pitch不变），其他增益、限压、0.5°入位、2秒倒计时和保护不变，最多8秒。候选保存 `review_corner_roll49p5_candidate.json`；尚未启动、尚未验证，不覆盖已确认5秒的原50°profile。此调整是小步单变量假设检验，不采用旧模型推荐，也不将有持续力矩时的平均姿态冒认为真实重心。

## Roll49.5°候选未显示改善，回到固定参考对照轮速反馈

`review_entry2s_roll49p5_trial8s_01`在首帧0.26°入位后实际控制约1.5秒，以主机角速度保护结束。触发Rate1.569rad/s、M1−195.31/M3−183.56rad/s、U1/U3均−6V；最终失能无驱动故障。用户确认同一支撑角、全程无干预。该单次候选未显示改善，不取代原50°参考，不足以据此定位真实重心或证明参考变动有普遍因果效果。

下一轮恢复原Pitch23.4399°/Roll50°，在同样2秒/0.5°、80/5、Ki0、BYAW3、BTRIM0、U6和原保护下，只将三轴共用轮速反馈Kw从−0.030改为−0.040，最多8秒。比较对象是之前原50°/Kw−0.030的新入位条件轮次，而不是同时改过参考的失败轮。旧−0.05记录同时改了Ki，不能直接当作本次单变量试验的结论。候选只保存为 `review_corner_kwminus04_candidate.json`，不更新默认配置；尚未验证。

用户改为优先数学计算，已记录支撑角P=(35,35,−35)mm、电池在M1轴外侧，完成离线悬挂重心求解器及7项合成校验；M1/M3面方向已测，M2采样运动中不作静态依据，尚无悬挂数据。用户随后要求暂停，已停止辅助进程并补发STOP，但当前串口无回报，最近确认状态为EN000。恢复断点见 `数学建模与暂停断点_2026-10-15.md`。−0.040候选没有执行。
