TDX33029/Cubli-STM32F407-ESP32/Firmware/数学建模与暂停断点_2026-10-15.md

# 数学建模与暂停断点（2026-10-15）

状态：用户明确要求“无法静态悬挂，先中断任务等待恢复”。已暂停，所有本会话启动的调试进程与只读提示窗口已停止，没有新增平衡/电机试验。暂停时已补发STOP，但两次有界串口读取均无回报；不能声称本次已获得新的失能确认。最近一次有效回读为M3面方向采集：EN000、Auto0、Bal0、Fault0。恢复时先核对连接和失能状态。

## 已明确的几何与测量

三个电机面外法向定义投影坐标e1/e2/e3，70mm立方体几何中心为原点。用户确认主板位于M2正对面；原支撑角位于M1/M2共有棱远离M3的一端，因此名义支撑点P=(35,35,-35)mm。电池很轻，位于M1旋转轴外侧，即+e1方向；实际质量/位置没有测量。

静止面采集确认M1面外侧对应IMU−Y、M3面外侧对应IMU−X。M2面采集覆盖搬动过程，不能拿来计算静态重心；原始记录保留，未把不稳定数据冒认为已校准。重心悬挂测量尚未开始。

## 数学关系

整机重心 C=Σ(mi*ci)/Σmi。零重力矩条件为 (C−P)×g_down=0；角点平衡选择C在P上方的分支。固件的归一化加速度向量在静止时指向竖直上方，因此所需参考为 g_ref=(C−P)/|C−P|（转换到实际IMU坐标后）。三个相同电机/飞轮只安装在三个面上，并不意味着重心在几何中心；主板与外置电池也必须计入。

若整机重心恰在几何中心，投影坐标参考为(−1,−1,+1)/√3，主板法向与竖直夹角54.7356°。这是理想几何例，不能直接作为本机已验证角度。IMU Pitch=atan2(gy,sqrt(gx²+gz²))、Roll=atan2(−gx,gz)。没有签名坐标映射或重心测量时，不生成实际新参考。

从已知框架点Pi自由静态悬挂时，C=Pi−λi*g_up_i。两条不平行的重力线可以解C；三条以上可核对一致性。已完成离线工具 `diagnostics/corner_com_geometry.py`：最小二乘交点、病态方向拒绝、线间残差、重心必须在挂点下方的检查；不打开串口、不写固件。输入和输出在 `diagnostics/2026-10-15/corner_com_geometry_*`。七项合成几何校验通过，实际COM仍未测量。

更直接的同角方法：若正好从实际支撑点P悬挂，悬挂时C在P下方，所需平衡方向就是悬挂归一化加速度的反向，即g_ref=−g_up_hang。只求姿态可不测质量/COM高度或电机面正负；实际系点若偏离触地点则不能直接套用，必须补偿挂点位置。这个简化关系已推导并记录，尚未集成到工具，且尚无实测数据。

这只能求出零重力矩姿态。该姿态本身仍是倒立摆，需要经验证的反馈控制维持稳定；不能用几何角度替代惯量、执行器饱和、延迟和动量控制的分析。

## 保存与恢复

原先−0.040轮速反馈候选尚未下发；本轮没有改变默认增益。最近实际试验仍是49.5°参考、80/5/−0.030/0，失败记录已保留；该参考并非新的验证配置。原50°五秒成功profile保留，新入位条件2秒/0.5°也保留。

用户当前无法静态悬挂，恢复后先选择可行测量方法（改善挂点布置，或用已知质量/位置、支撑称重等方法），然后再算实际参考；不得直接依据此前就绪回复启动任何运动。详细暂停状态见 `diagnostics/2026-10-15/geometry_pause_checkpoint.json`。
