TDX33029/Cubli-STM32F407-ESP32/Firmware/Cubli-ST-Statistics/MDK-ARM/当前固件说明.md

# 当前固件输出

2026-10-18 最新默认 `CubeMX/CubeMX.hex` 为 **NTune3 / WPlane1**，已烧录并校验。
SHA256：`347585feec8ead64fa2c10b319b94ef9b7b21698b0e068321af12d70e3d8b259`；数据53396字节，38输入、0错误0警告。

WPlane1将单点的加权轮速反馈投影到倾斜平面，去除竖直分量；BYAW继续独立控制自转阻尼，单边控制不改。旧NTune3初版仍可从592f998提交恢复。

支持 `BNEUTRAL 1 gain rate limit`（总范围2～5°），以及附加 `seedPitch seedRoll` 在失能时恢复学习目标。原始BREF始终保留为总范围与倾倒保护锚点。旧命令仍默认2°，寻点默认关闭。主机用 `--neutral-limit 5` 显式启用5°范围，STOP后用 `--resume-neutral-from` 继续；复位/重新配置后用 `--seed-neutral-from` 恢复，不将学习目标另设为新的BREF。

当前功能已通过生产C保护测试、51项串口模拟测试、12项窗口测试。5°真机长期平衡仍待验证；不能将扩大范围等同于已找到重心。新校验日志为 `CubeMX/flash_neutral5_plane_verified_2026-10-18.log`。

默认目录保持与本次源码同步，`CubeMX-corner-observer` 保存前版NTune2历史镜像。

## 本日此前版本记录（以下hash不是最新版本）

2026-10-18 已将默认 `CubeMX/CubeMX.hex` 从当前源码完整重建并烧录校验。该HEX与已验证的 `CubeMX-corner-observer/CubeMX.hex` 完全一致，SHA256：

`fc2b4c2bd48e200d78c7fb094de2150e3ce23f0787d696df2477db035051adec`

当前版本包括单点接管首周期完整轮速反馈、三轴静止入位门槛、可选有界寻点（NTune2）和可调姿态校正（ATune1）。寻点默认关闭，姿态校正默认0.25秒；这些功能存在不代表长期单点平衡已经验证成功。

从“无刷闭环联调”目录构建默认输出：

```powershell
python Cubli-ST/build_firmware.py --encoder i2c --variant CubeMX
```

每次修改源码后先成功构建，再使用默认 `CubeMX/CubeMX.hex` 烧录。各个 `CubeMX-corner-*` 目录是历史试验备份，部分版本较早，不能按目录名推断为最新。

本次发现板上原镜像与旧默认目录及 `CubeMX-corner-entry2s` 完全相同。只读回传备份和逐字节比对结果保存在 `diagnostics/2026-10-18/initial_flash_readback.bin`、`initial_firmware_identity.json`（相对“无刷闭环联调”目录）。旧entry2s镜像继续保留。

构建/烧录证据见 `CubeMX/review_manifest.json` 与 `flash_verified_2026-10-18.log`。默认目录的 `CubeMX.lnp`、`CubeMX.sct` 是项目链接配置，保留；可再生 `.o` 与独立构建临时链接文件已清理。
