TDX33029/Cubli-STM32F407-ESP32/Firmware/diagnostics/2026-10-16/corner_identification_notes.md

# 继续多轴响应辨识

用户询问为何结束对话后继续工作，长期稳定目标尚未完成。现有自动寻点三轮均在后段限压/角速度保护，先补齐输入与机体三轴响应，不继续靠三次试验结束任务。

已有 M1 正负脉冲的 Y 正/负响应及显著 X/Z 耦合，记录见 com_m1_corner_paired_direction_review.json。计划在相同角点补测 M2/M3 的正负 3V、80ms 有固件限时脉冲，原主机 1.5rad/s、10° 和低轮速保护保留。新增 --probe-delay .15，减少纯零输出等待；原默认 .35 保留，有限诊断脚本自动等待原参考 1°/2秒入位，不添加手动记录或每轮就绪确认。

首次 M2 正脉冲 corner_ident_m2_pos3_01 未发出：进入 probe_prepare 后，一条仍处于角点模式的 FAST 包，其真实 Pitch/Roll 被历史 TELE 平放姿态覆盖，误触发主机倾角保护。已修复为保留包内姿态；仅对没有姿态的边沿 FAST 从最近且不超过 0.2s 的完整姿态包补值。新增队列过渡回归，以及 M2/M3 正负脉冲选轴测试，37 个串口诊断测试通过。该错误只发生在脉冲模式准备/切换路径，此前三轮自动寻点未用该路径。

不改变固件、映射或机械方向；三轴校准仍有效。依据完整正负配对与重复性检查后才判断方向/耦合，不把单次脉冲比值当作准确惯量。若短时物理惯量模型不满足正定、互易性和主惯量三角不等式，需查接触约束/测量，不用不物理的模型推荐增益。

M2 正脉冲第二次 corner_ident_m2_pos3_02 实际发出并记录，但松手到 BPROBE 发出约0.562秒，机体已有自由倾倒，随后角速度保护；此数据不用于惯量拟合。保护后边沿 FAST 的 Bal4 包没有完整陀螺仪，原 finally 路径错误地继续做活动包校验，中断 FAST0 和新 STATE 确认，导致只读窗口收不到姿态而显示自动重连。已独立检查 COM7/主板均正常、EN000/Bal0，恢复 FAST0/TELE1，记录 probe_stream_recovery01.json。

修复收尾路径：finish 阶段忽略残留 FAST 的活动字段要求，仍解析 STATE，保证 STOP/FAST0/U2.5/L15/新失能确认执行。减少脉冲准备延迟：不在松手瞬间插入 FREQ 报告；失能/模式命令按序连续发送，保留新 STATE 失能确认，STATE 请求每0.1秒重试以避免 TX 拥塞丢查询后等下一个周期；确认完成后连续发送 FAST7/BPROBE。保留原限时/传感器/角速度/倾角保护。39 个串口诊断测试通过，含保护残留包清理、过期姿态覆盖防回归、丢失 STATE 重试和三轴选轴。

恢复会话时主板已复位（Aligned000/Cal0/默认编码器映射），corner_ident_m2_pos3_03 正确拒绝启动，未发脉冲。用户重新确认静止自检准备后，corner_ident_after_reset_prep01 完成三轴重新映射3/1/2、方向+1、PP7及IMU校准，最终EN000/Aligned111/Cal1。只读窗口重新启动为PID27020。随后继续优化准备时序的 M2 正向脉冲，不需要重新烧录。

corner_ident_m2_pos3_04 在3分钟内始终平放，未入位也未发脉冲；用户随后确认窗口可见并扶到目标。corner_ident_m2_pos3_05 与 corner_ident_m2_neg3_01 均完成±3V/80ms，最终EN000/Bal0且FAST0/TELE流恢复；从PG6首个遥测到主机脉冲命令分别0.203/0.281秒。按末两个脉冲样本均值与松手前基线求增量：正向轮速+20.575rad/s、机体增量[-0.4923,+0.6045,+0.7533]rad/s；负向轮速-20.763、机体增量[+0.5080,-0.4955,-0.7905]。配对响应约[-0.02420,+0.02661,+0.03735]rad/轮转rad，支持BDIR2=-1，并有明显X/Y耦合。

新增纯离线 corner_probe_review.py：排除未完成脉冲/未确认失能，按正负配对归一化转速响应，按确认轴排列矩阵，再检查互易性、正定性及主惯量三角不等式；通过这些检查也不等于获得精确惯量，不自动改变任何参数。3项数学测试通过（含轴排列/方向翻转恢复与非物理惯量拒绝）。corner_paired_response_review_m1_m2.json 当前仅有M1/M2两对，明确缺少M3，不能声称完整模型已建立。

M3 正负3V/80ms均完成并确认最终失能，记录 corner_ident_m3_pos3_01 / corner_ident_m3_neg3_01。结合旧M1配对和新M2/M3配对，三个候选BDIR仍均为-1，无需翻转。完整响应审阅见 corner_paired_response_review_complete01.json；相对非对称度0.125，响应矩阵正定，但反推主惯量11.67/73.04/214.32（轮惯量单位）违反三角不等式，拒绝据此推荐控制增益。短脉冲还有重力、接触和滤波等偏差。

后续检查融合姿态与FAST陀螺仪逐帧传播的一致性，四条完整控制日志每20ms中位差约0.14～0.21°，校正率与倾斜角加速度的拟合系数约-0.017～-0.026秒；见 corner_observer_acceleration_consistency_review.json。存在可能的动态加速度混入姿态，相关性不能证明根因，也不能把纯陀螺积分当作真值。下一块增加失能时可选的姿态加速度校正时间常数，默认仍0.25秒，先用固定支点运动/传感器仿真验证，再仅将该时间常数调到1秒作短时对照，其余增益/参考/保护保持原值，暂不开自动寻点。
