TDX33029/Cubli-STM32F407-ESP32/Firmware/diagnostics/2026-10-16/neutral_search_plan.md

# 自动平衡点搜索：实施起点

用户观察到前约 4 秒稳定，但一个飞轮持续加速，随后约 5 秒保护停机，要求改为自动寻找合适平衡姿态。当前 Ki=0、BTRIM=0，不能把轮速增长归因于积分项。

最新固定参考、Kd=8 的 8 秒复测实际运行 4.891 秒，触发主机角速度保护：机体角速度 1.617 rad/s，M3 约 -207.59 rad/s、输出 -6 V。没有完成 8 秒稳定验证。记录见同目录 corner_immediate_comref_kd8_kw040_yaw6_trial8s_01*。

下一块实现可显式开关的慢速目标调整：基于飞轮在倾斜平面内的持续转速，排除绕重力方向的自转分量；搜索总范围 2°、最大速度 0.5°/s。快速姿态环和即时轮速反馈保留，Ki/BTRIM 保持 0。大角速度、较大偏差、输出饱和或传感器失效时冻结搜索。原始参考与学习参考均保留倾倒保护，主机轮速/角速度/倾角保护不变。

学习结果只作试验数据，不自动覆盖已验证备份。先通过生产 C 和串口脚本测试，再编译、烧录、自检与静止校准，进行短时实机验证。入位提示窗口持续采样，显示实际动态目标和停机原因，不增加记录按钮或逐轮就绪确认。
