TDX33029/Cubli-STM32F407-ESP32/Firmware/diagnostics/2026-10-14/auto_edge_ui_preview.png

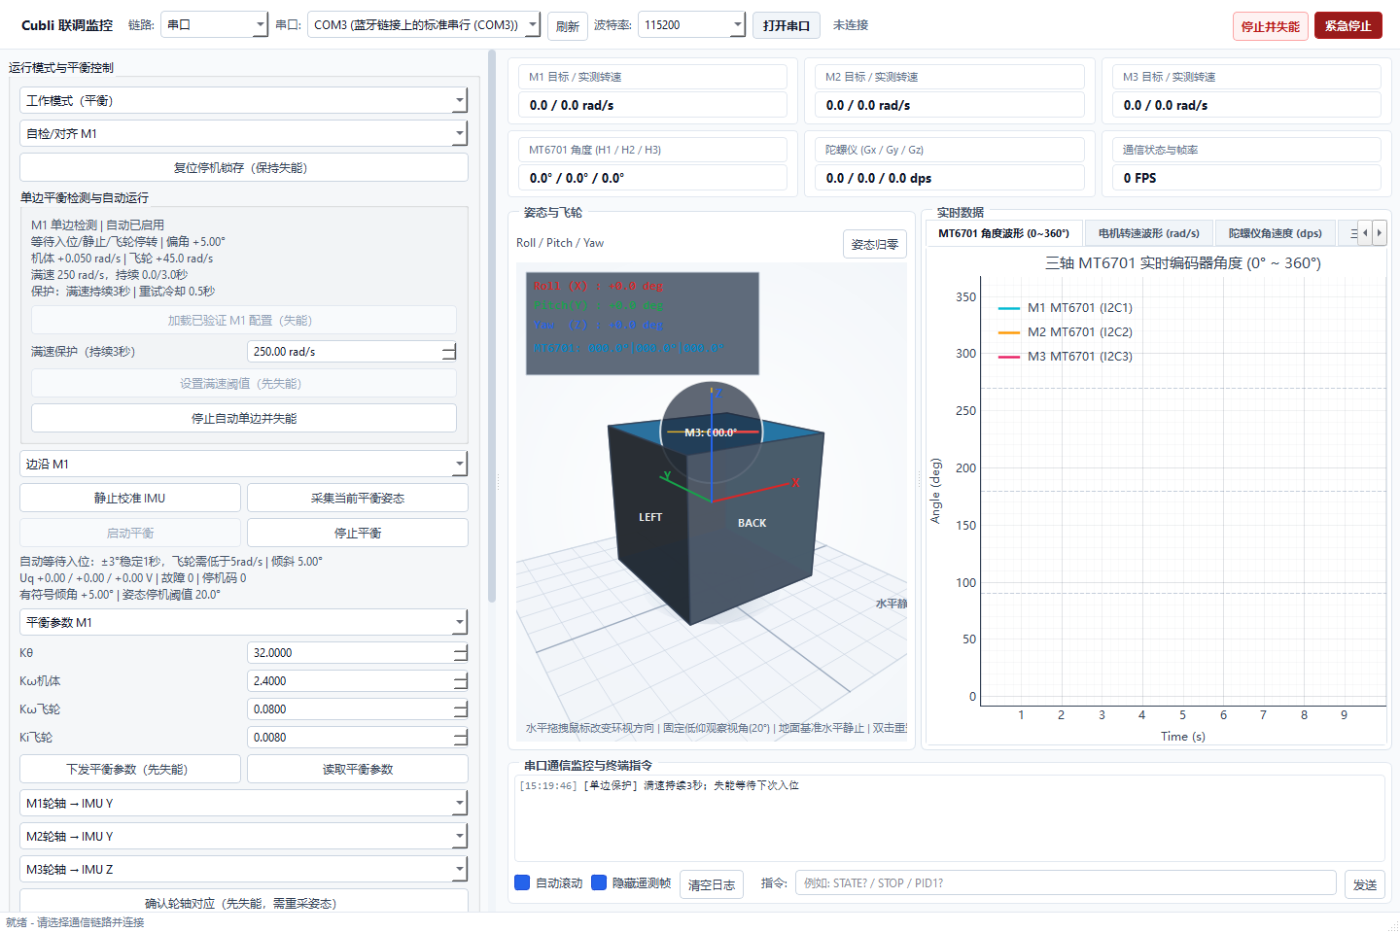
Firmware/diagnostics/2026-10-14/auto_edge_ui_preview.png
