TDX33029/Cubli-STM32F407-ESP32/Firmware/diagnostics/2026-10-14/edge_fixture_response.png

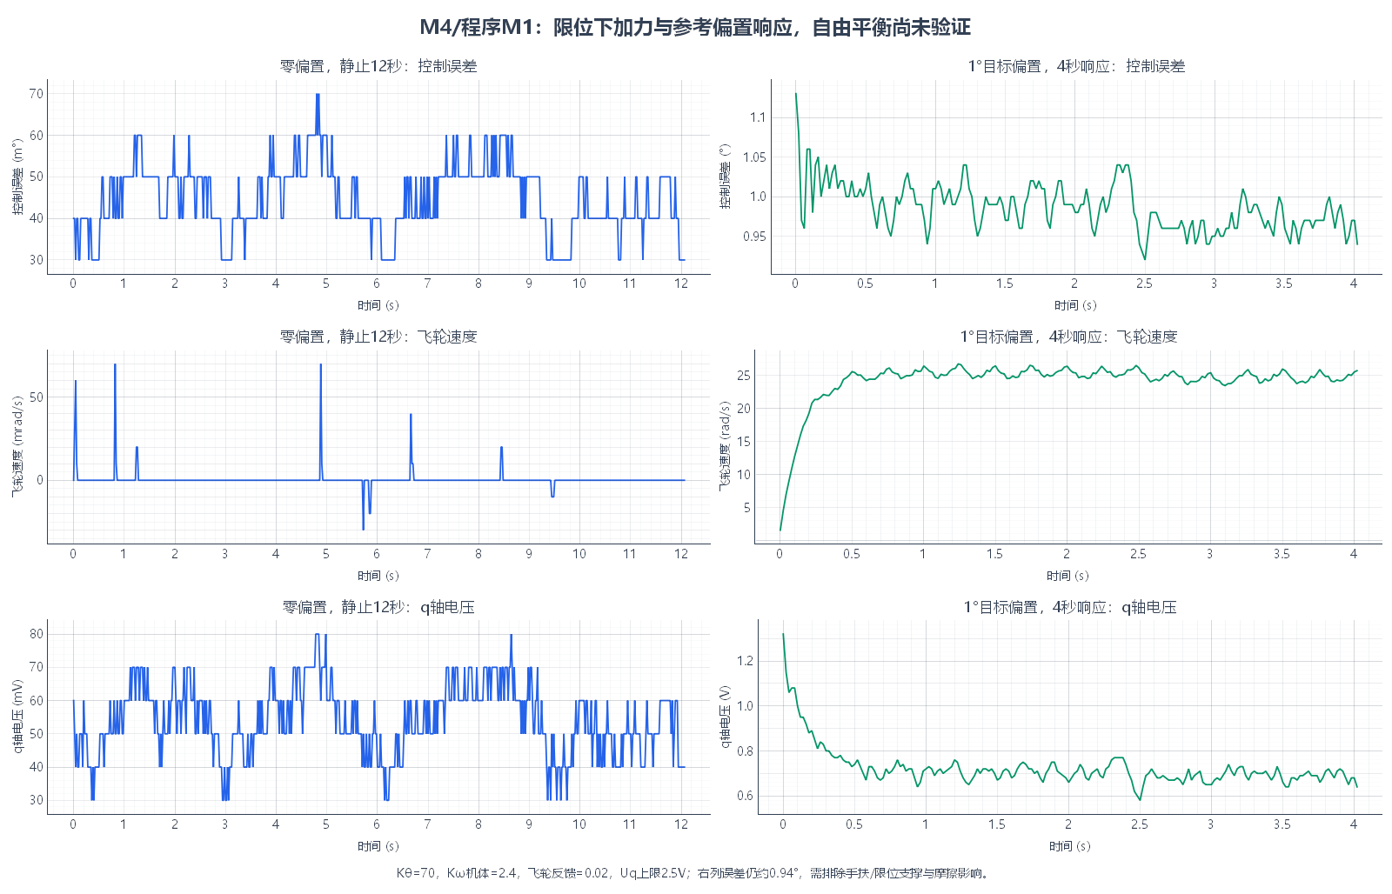
Firmware/diagnostics/2026-10-14/edge_fixture_response.png
