TDX33029/Cubli-STM32F407-ESP32/Firmware/diagnostics/2026-10-14/wheel_cad_and_torque_estimate.png

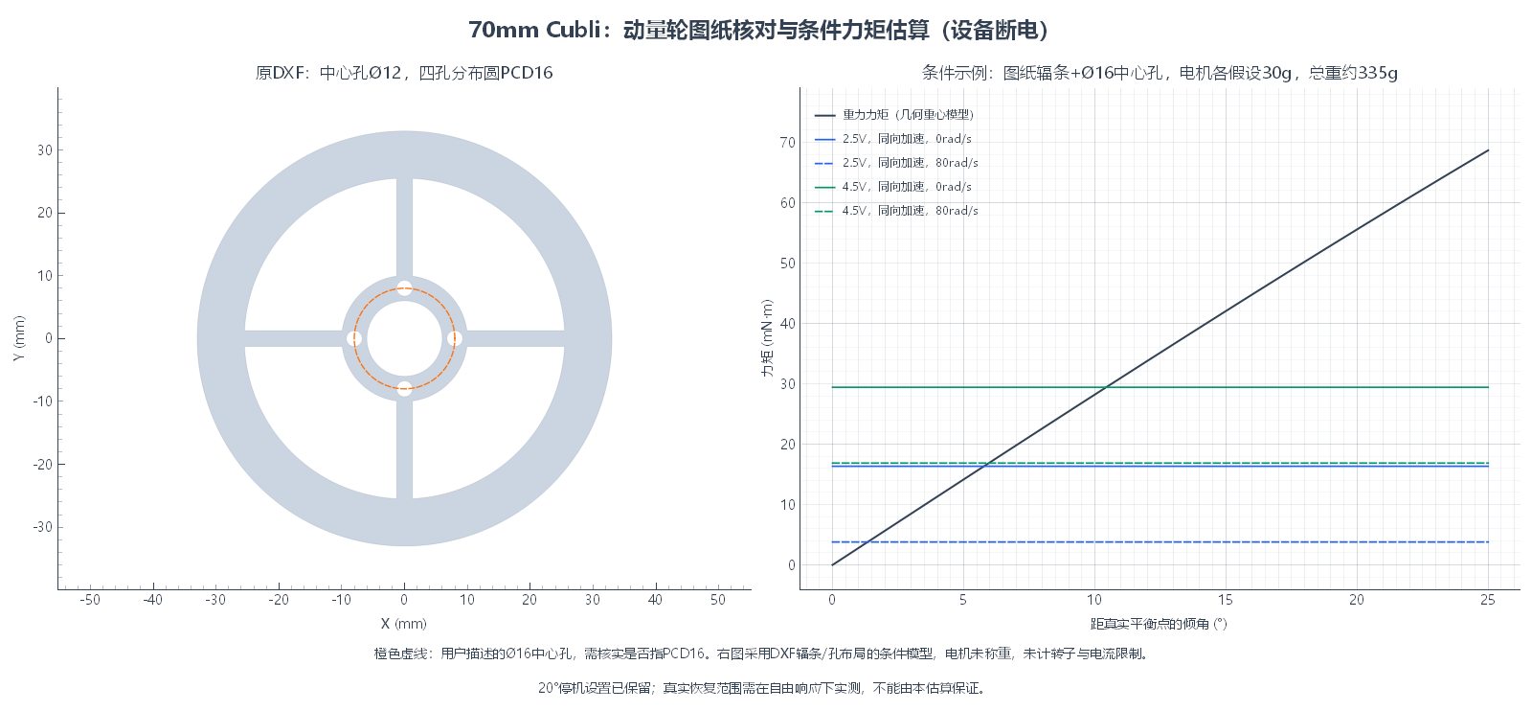
Firmware/diagnostics/2026-10-14/wheel_cad_and_torque_estimate.png
