TDX33029/Cubli-STM32F407-ESP32/Hardware/3DS.PNG

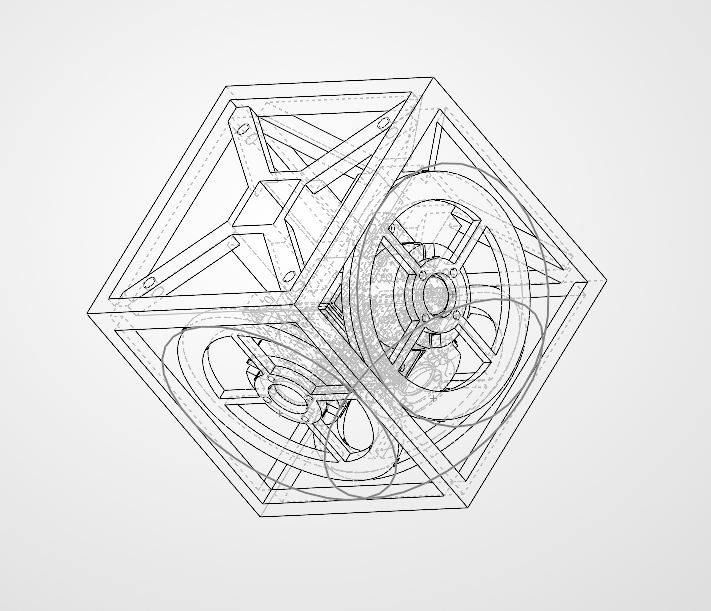
Hardware/3DS.PNG
