TDX33029/Cubli-STM32F407-ESP32/Hardware/MB-3D-BOTTOM.PNG

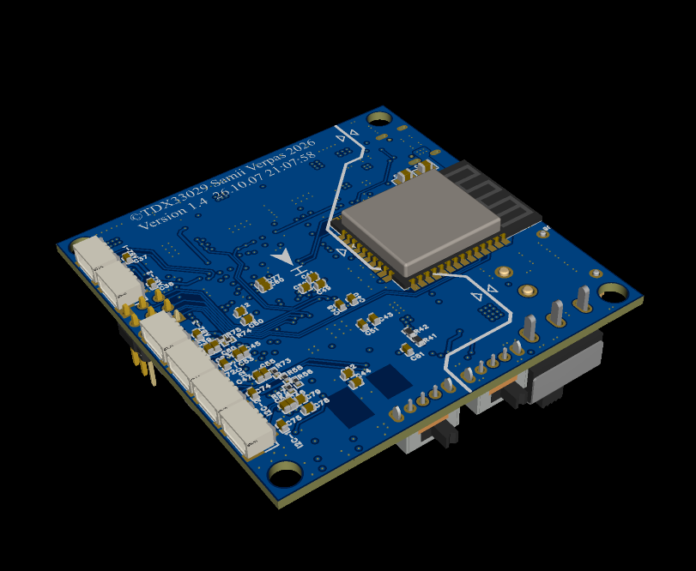
Hardware/MB-3D-BOTTOM.PNG
