TDX33029/Cubli-STM32F407-ESP32/Statistics/01_闭环平衡时序图/balance_attitude_animated.png

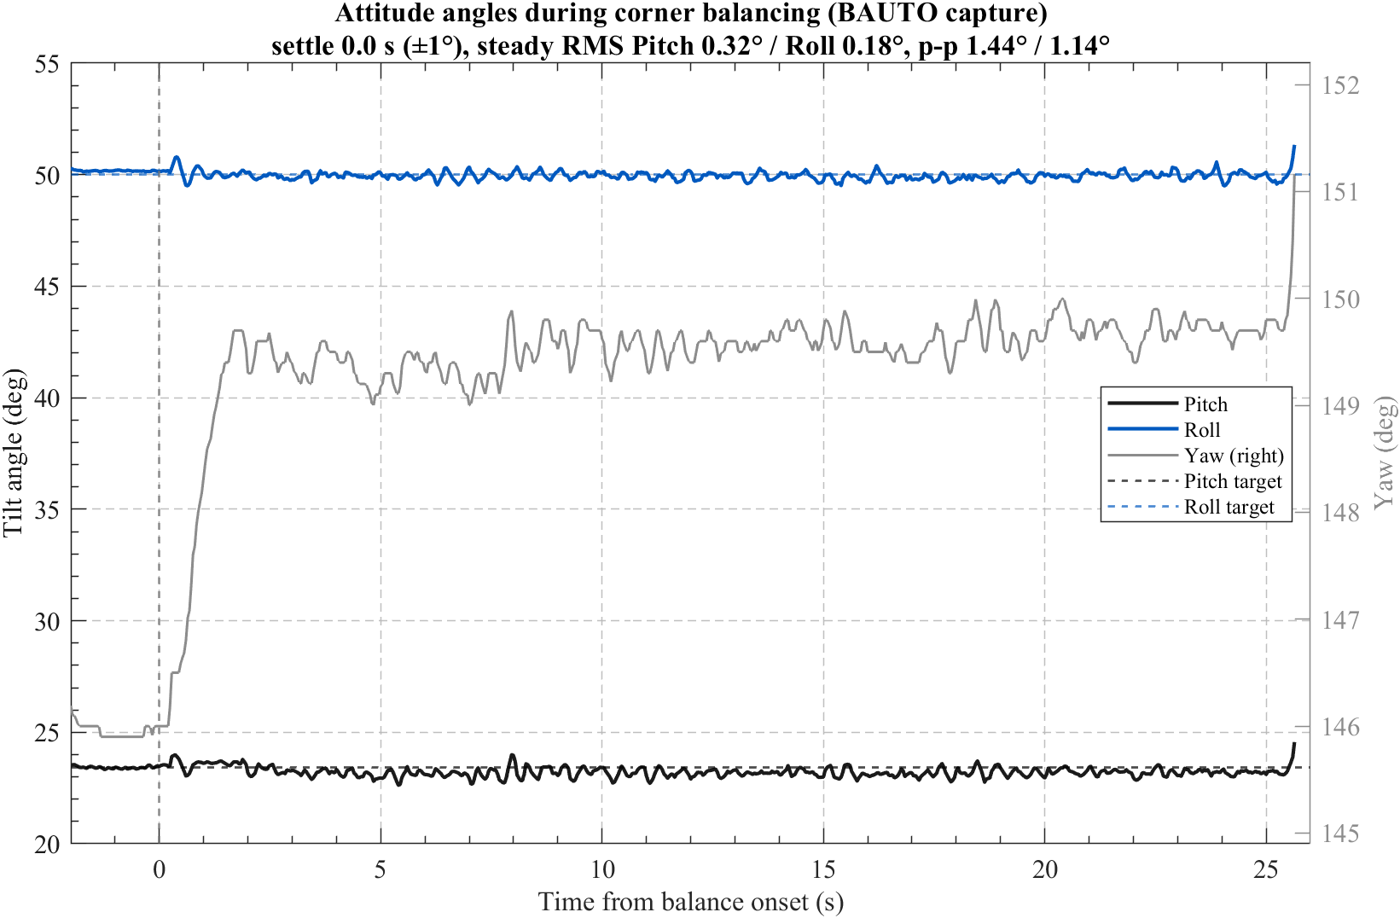
Statistics/01_闭环平衡时序图/balance_attitude_animated.png
