TDX33029/Cubli-STM32F407-ESP32/Statistics/02_相平面图/phase_pitch_animated.png

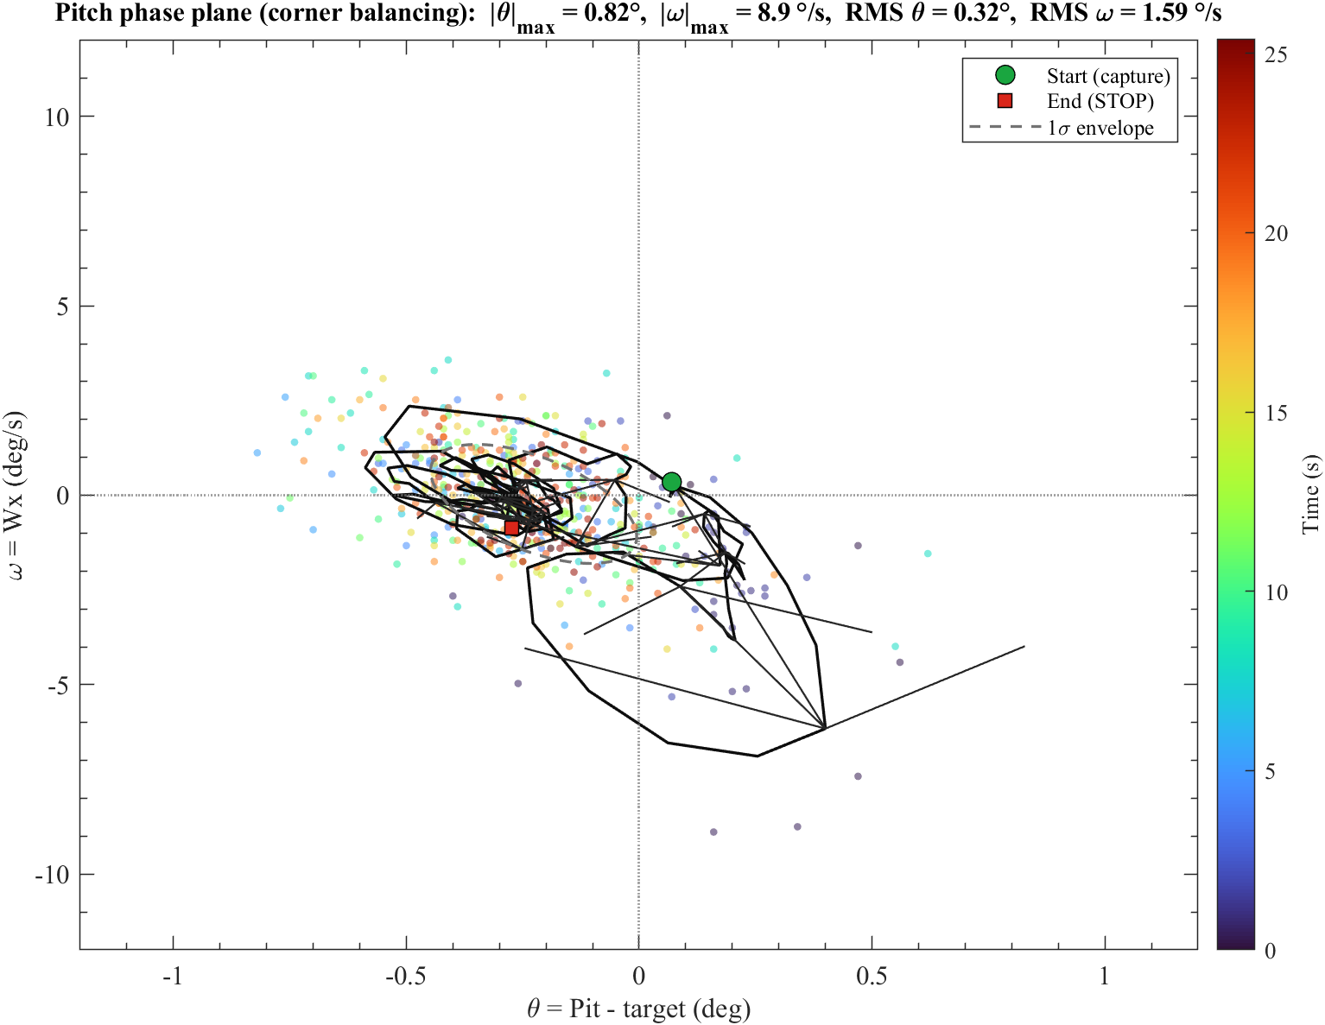
Statistics/02_相平面图/phase_pitch_animated.png
