TDX33029/Cubli-STM32F407-ESP32/Statistics/03_姿态角与飞轮转速关联图/attitude_error_animated.png

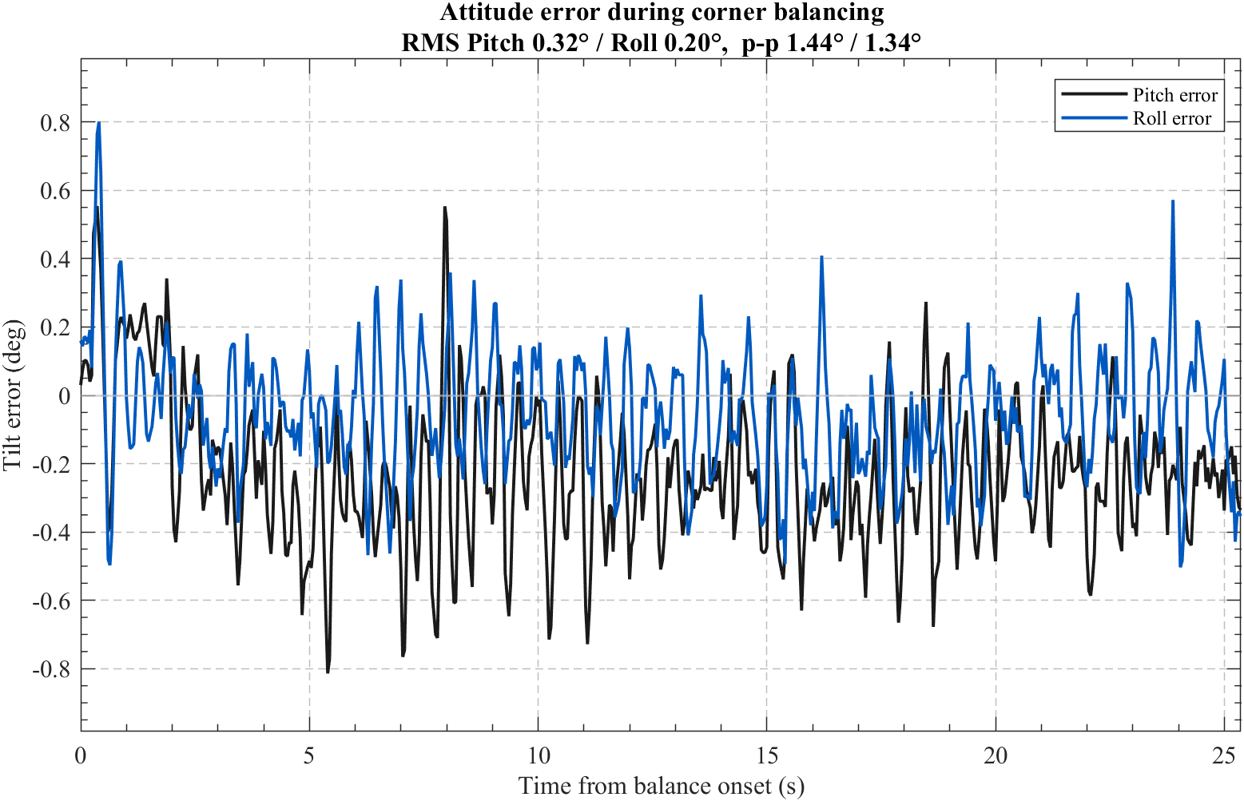
Statistics/03_姿态角与飞轮转速关联图/attitude_error_animated.png
