TDX33029/Cubli-STM32F407-ESP32/Statistics/03_姿态角与飞轮转速关联图/attitude_wheel.png

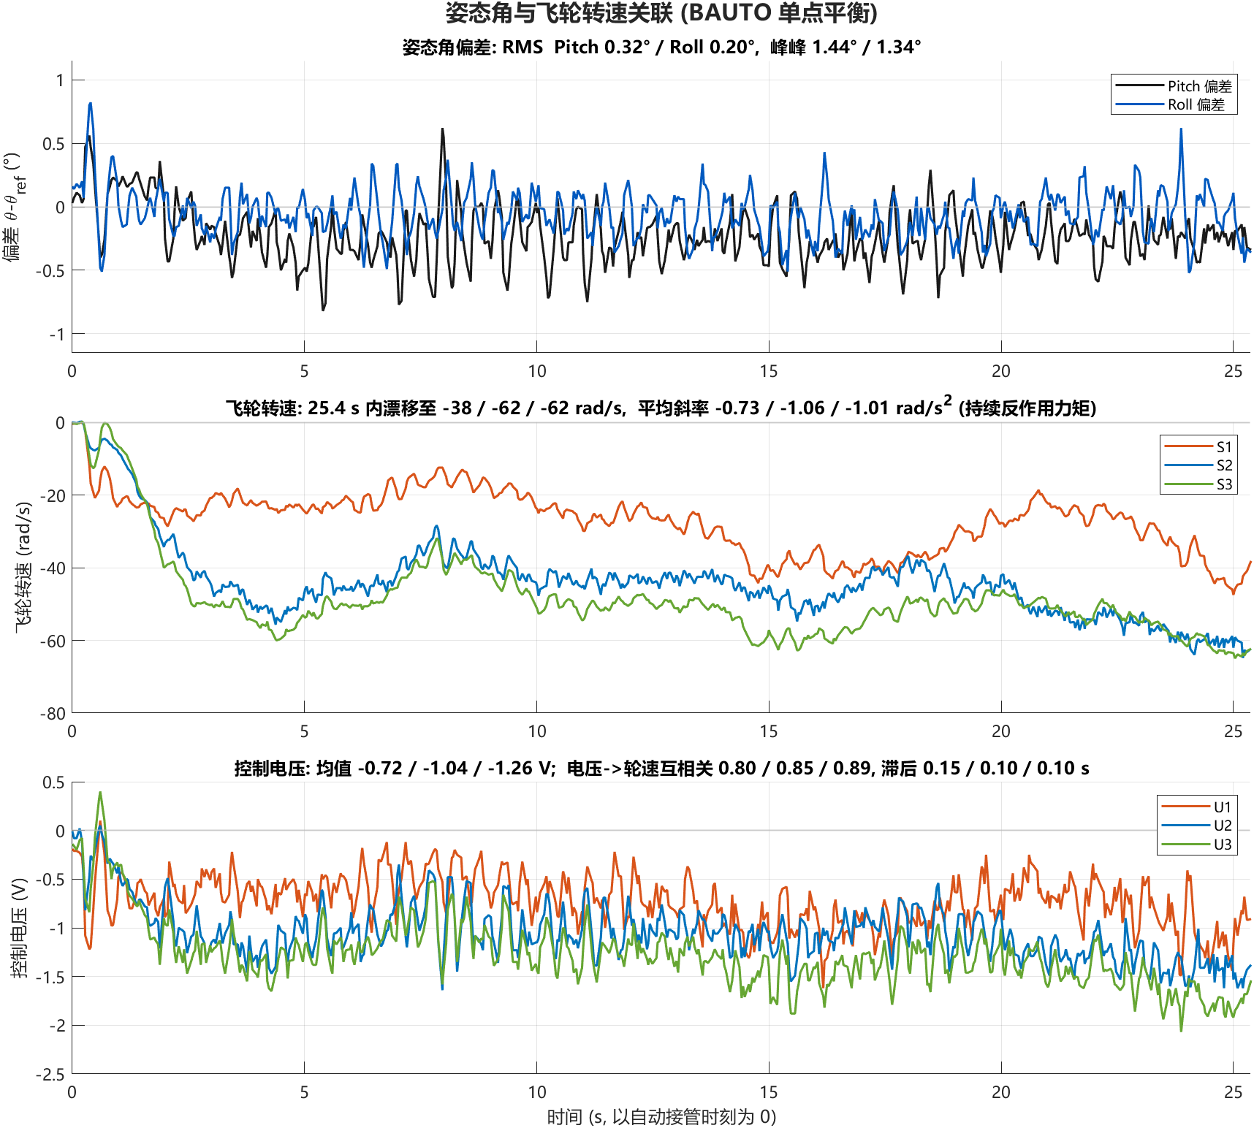
Statistics/03_姿态角与飞轮转速关联图/attitude_wheel.png
