TDX33029/Cubli-STM32F407-ESP32/Statistics/03_姿态角与飞轮转速关联图/control_voltage_animated.gif

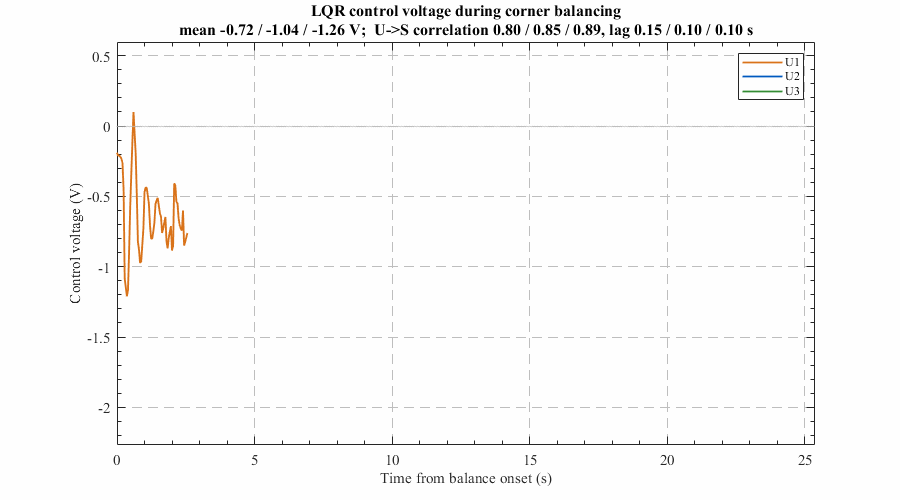
Statistics/03_姿态角与飞轮转速关联图/control_voltage_animated.gif
