TDX33029/Cubli-STM32F407-ESP32/Statistics/04_PID控制输出与姿态误差/ctrl_wterm_animated.gif

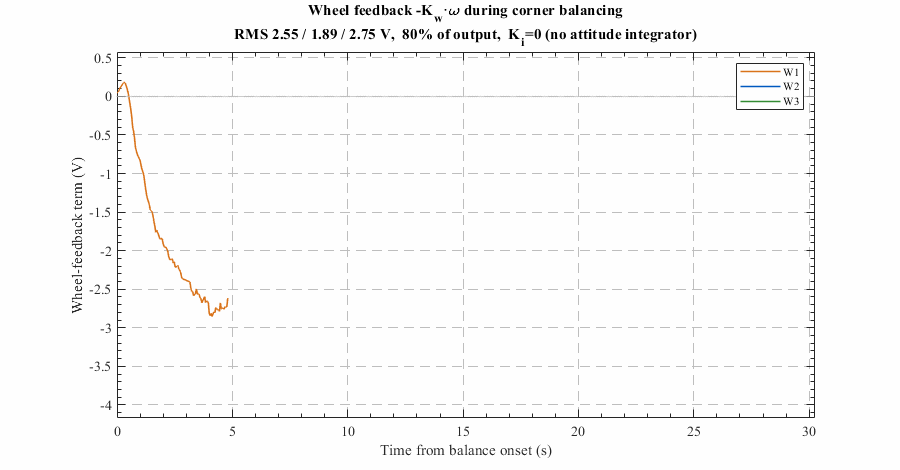
Statistics/04_PID控制输出与姿态误差/ctrl_wterm_animated.gif
