TDX33029/Cubli-STM32F407-ESP32/Statistics/05_扰动恢复能力测试/kick_maxdev_animated.png

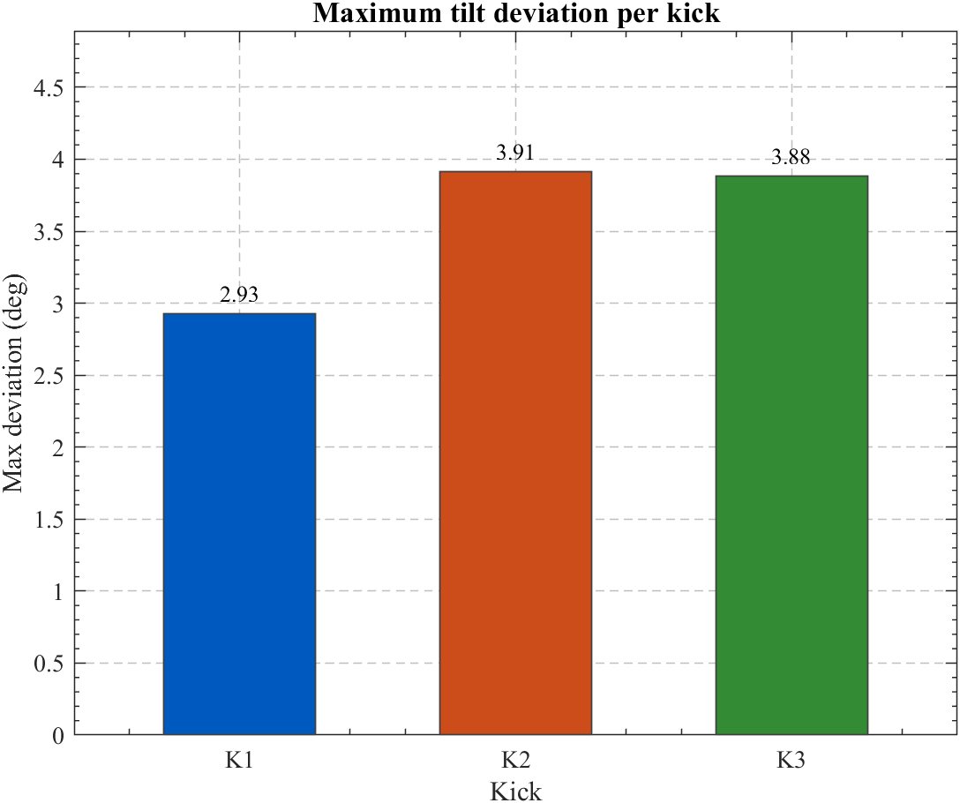
Statistics/05_扰动恢复能力测试/kick_maxdev_animated.png
