TDX33029/Cubli-STM32F407-ESP32/Statistics/06_平衡性能指标对比/compare_recovery_animated.png

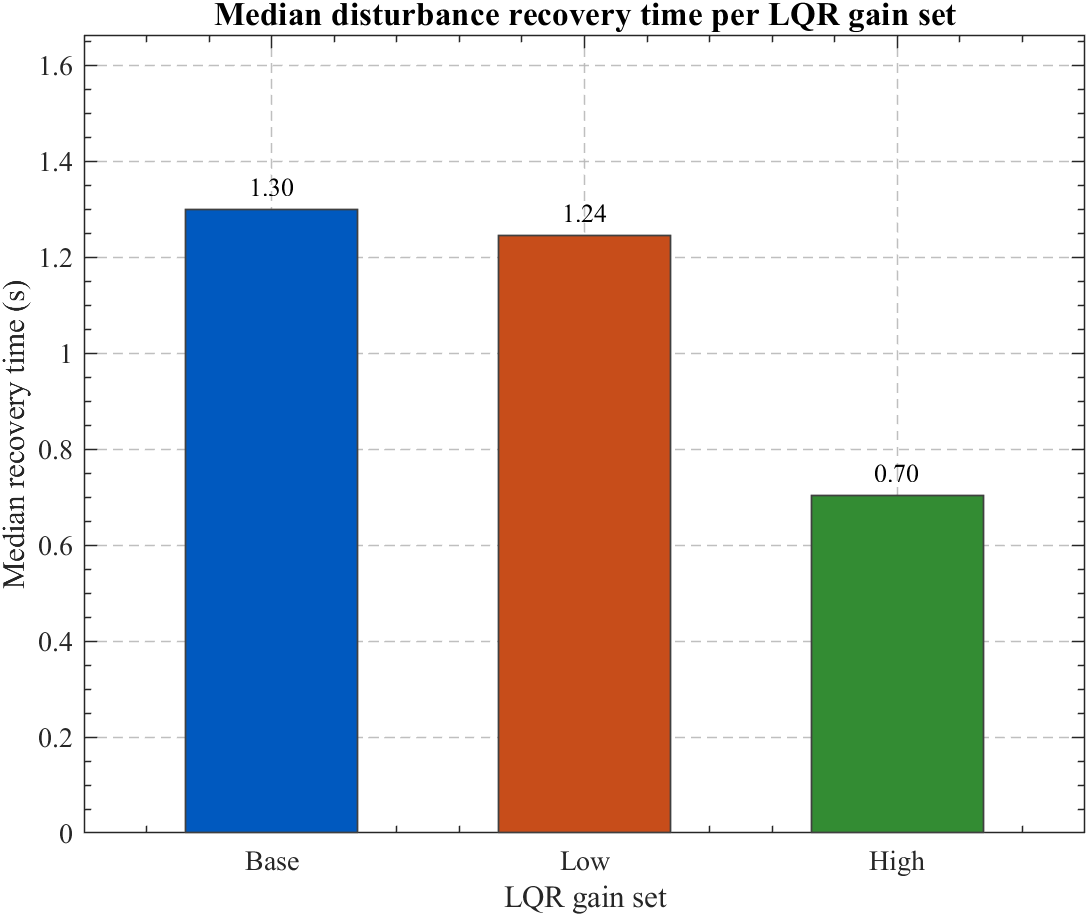
Statistics/06_平衡性能指标对比/compare_recovery_animated.png
