TDX33029/Cubli-STM32F407-ESP32/Statistics/07_电机转速阶跃响应/staircase_response_3motors.png

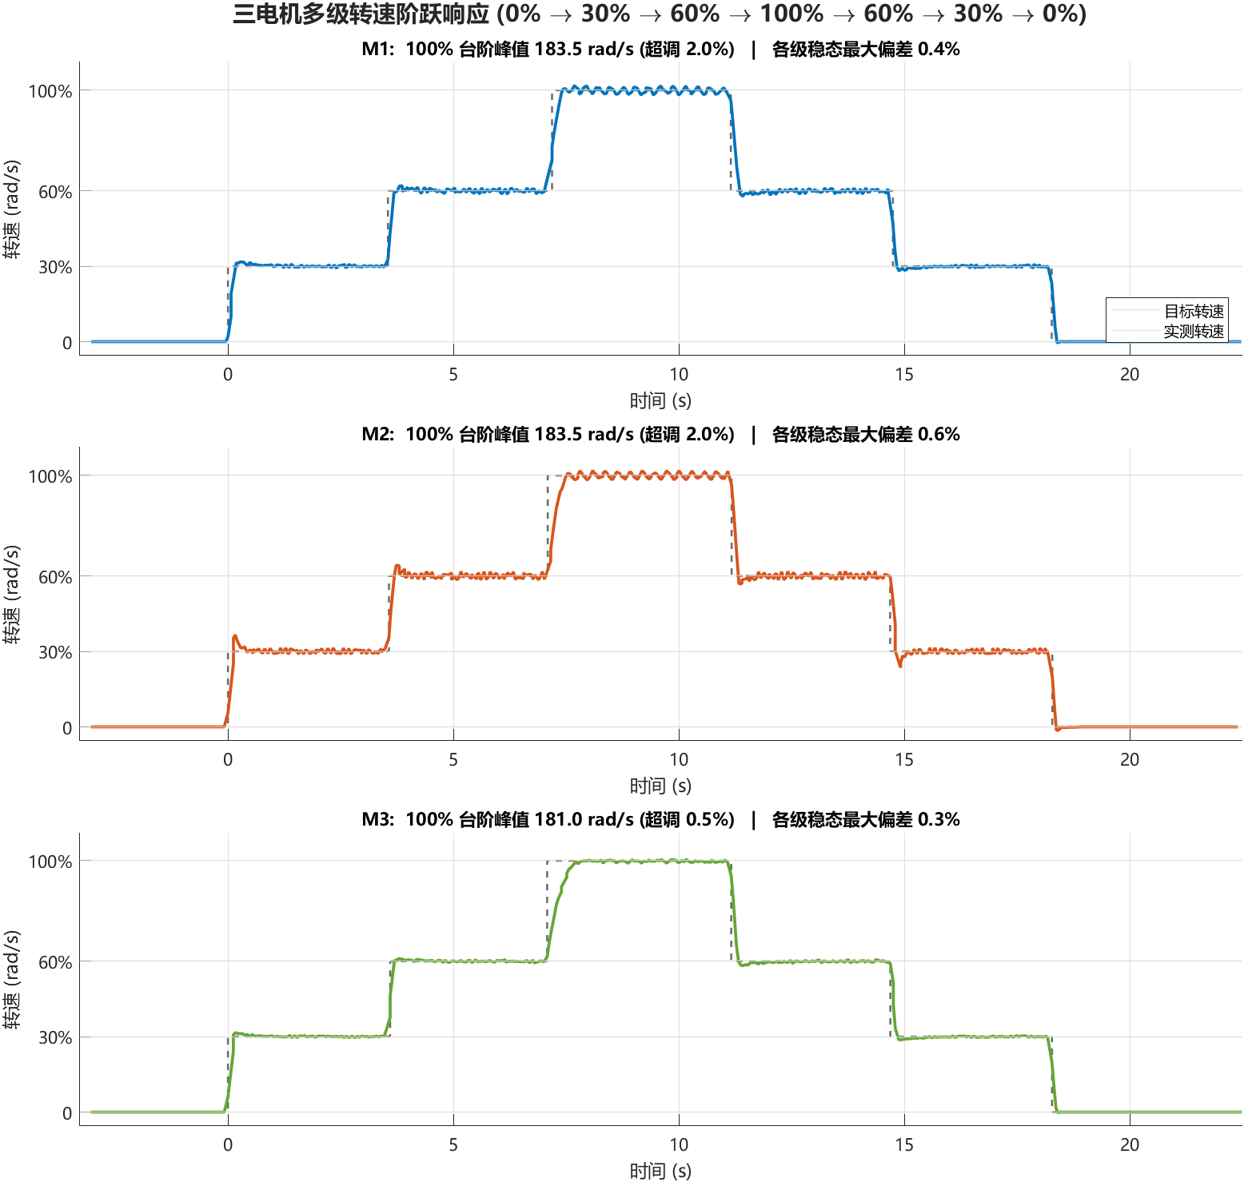
Statistics/07_电机转速阶跃响应/staircase_response_3motors.png
