TDX33029/Cubli-STM32F407-ESP32/Statistics/07_电机转速阶跃响应/staircase_response_compare.png

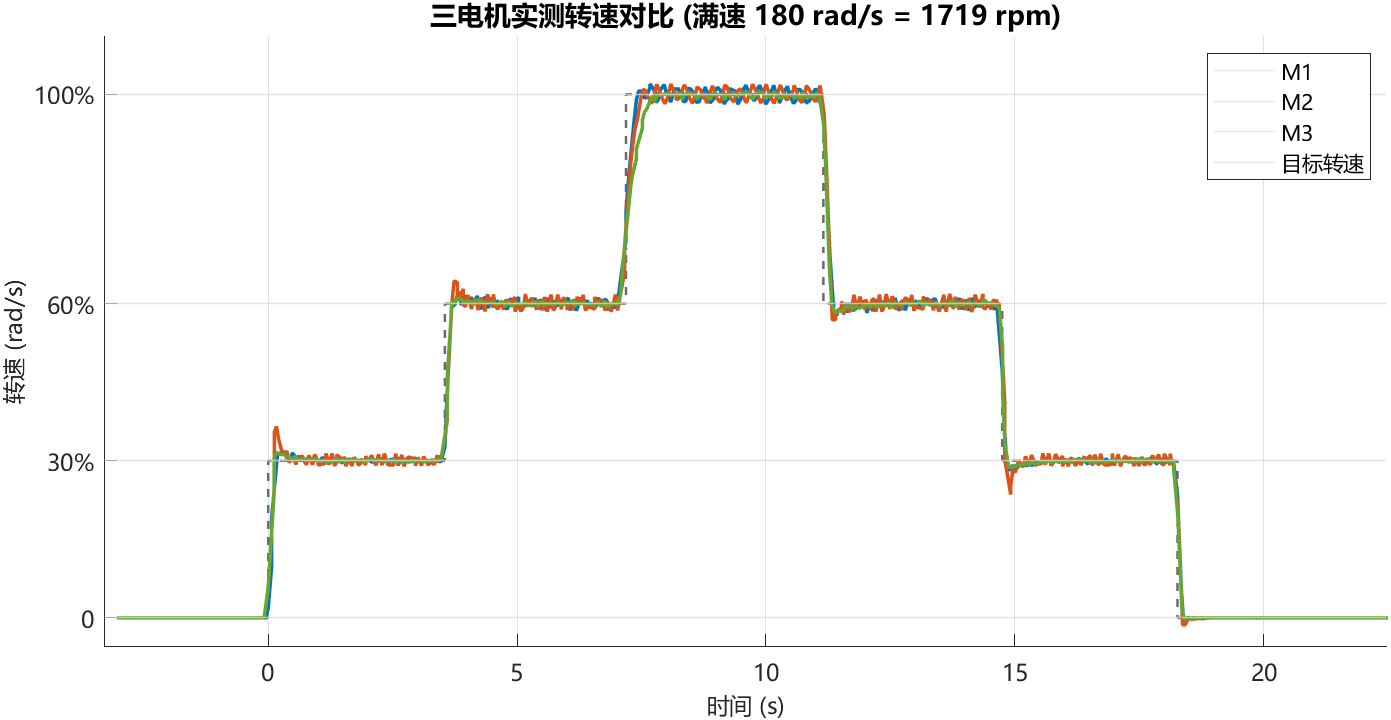
Statistics/07_电机转速阶跃响应/staircase_response_compare.png
