TDX33029/Cubli-STM32F407-ESP32/Statistics/img/02.png

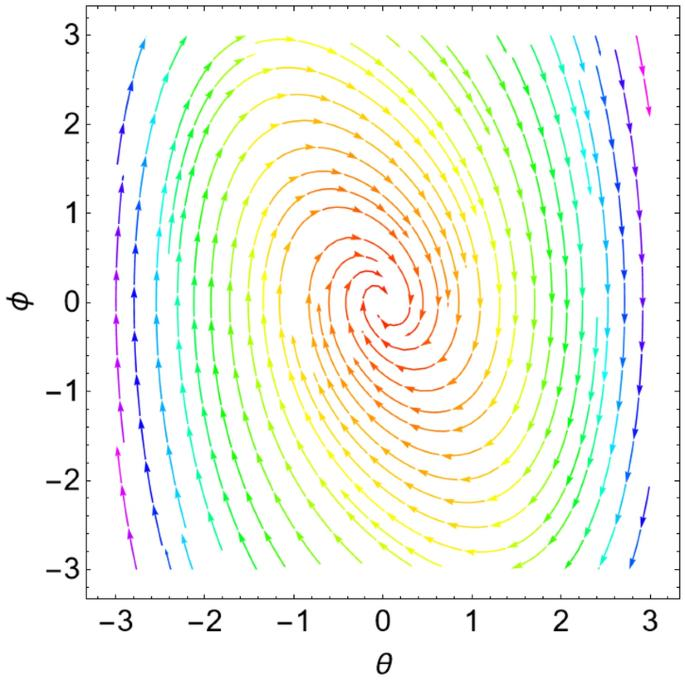
Statistics/img/02.png
