TDX33029/Cubli-STM32F407-ESP32/Statistics/img/05.png

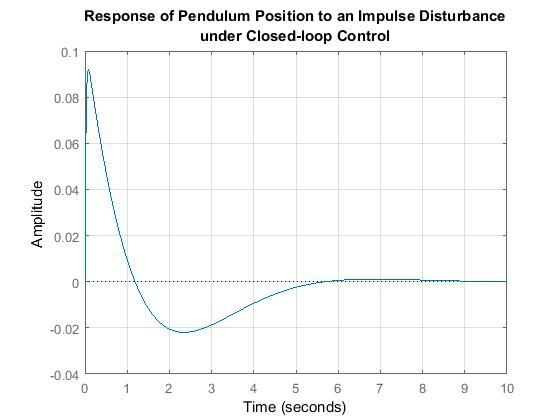
Statistics/img/05.png
