TDX33029/Cubli-STM32F407-ESP32/Statistics/img/06.png

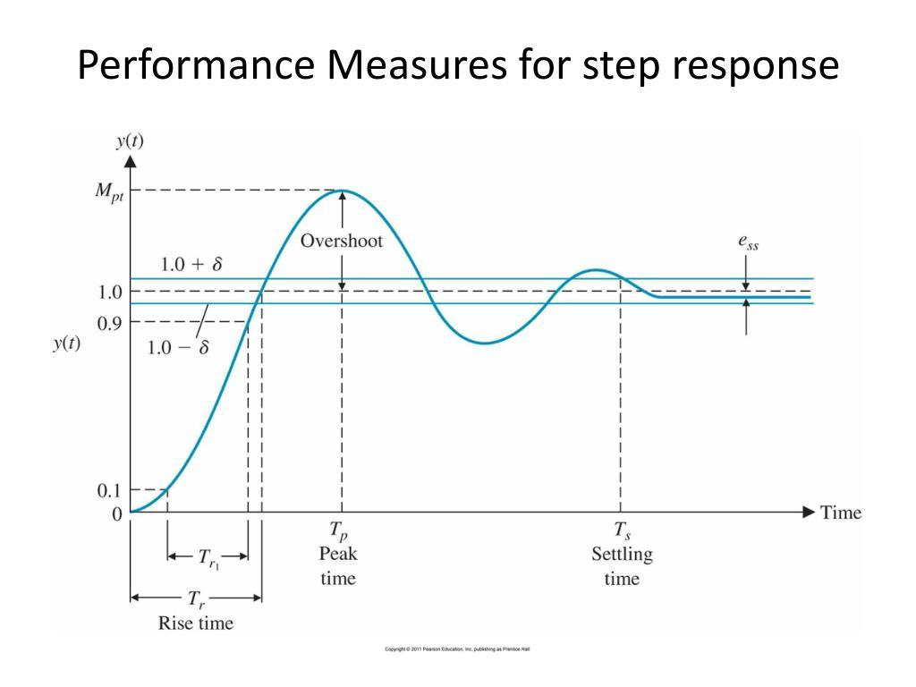
Statistics/img/06.png
