TDX33029/Cubli-STM32F407-ESP32/History/260423完备v1/BOM_Cubli.xlsx

No. | Quantity | Comment | Designator | Footprint | Value | Manufacturer Part | Manufacturer | Supplier Part | Supplier
45 | 4 | 0 | R53,R54,R55,R56 | R0402 | 0
34 | 1 | 0.5 | R28 | R0402 | 0.5
33 | 3 | 10 | R20,R23,R26 | R0402 | 10
32 | 5 | 100 | R19,R22,R25,R51,R52 | R0402 | 100
1 | 55 | 100nF | C1,C2,C4,C6,C7,C9,C11,C12,C14,C17,C18,C19,C20,C21,C22,C23,C24,C25,C26,C27,C28,C37,C39,C40,C41,C42,C43,C44,C45,C46,C47,C48,C49,C50,C51,C52,C53,C54,C55,C56,C57,C58,C61,C62,C63,C67,C72,C73,C74,C75,C77,C78,C79,C80,C81 | C0402 | 100nF
21 | 12 | 10K | NTC,NTC1,NTC2,NTC3,R41,R47,R48,R49,R50,R57,R58,R60 | R0402 | 10K
29 | 1 | 10M | R7 | R0402 | 10M
30 | 2 | 10m | R8,R9 | R1206 | 10m
2 | 3 | 10nF | C3,C8,C13 | C0402 | 10nF
10 | 4 | 10pF | C68,C69,C70,C71 | C0402 | 10pF
3 | 3 | 10uF | C5,C10,C15 | C_Ele_SMD_3x5.4mm | 10uF
4 | 6 | 10uF | C16,C29,C30,C31,C32,C35 | C0402 | 10uF
5 | 2 | 10uF | C33,C34 | C0603 | 10uF
41 | 1 | 14.7K | R39 | R0402 | 14.7K
25 | 11 | 1K | R3,R10,R13,R16,R21,R24,R27,R29,R30,R32,R43 | R0402 | 1K
24 | 5 | 1m | R1,R2,R12,R15,R18 | R0402 | 1m
13 | 1 | 1N5819WS | D1 | SOD-323_L1.8-W1.3-LS2.5-RD |  | 1N5819WS | Hottech(合科泰) | C191023 | LCSC
9 | 3 | 2.2nF | C64,C65,C66 | C0402 | 2.2nF
8 | 2 | 2.2uF | C59,C60 | C0402 | 2.2uF
17 | 1 | 2.2uH | L1 | IND-SMD_L6.0-W6.0_SWPA6045S | 2.2uH | SWPA6045S2R2NT | Sunlord(顺络) | C36500 | LCSC
18 | 1 | 2.2uH | L2 | IND-SMD_L2.0-W1.6 | 2.2uH
44 | 3 | 220Ω | R44,R45,R46 | R0402 | 220Ω | PTFR0402B220RP9 | RESI(开步睿思) | C478868 | LCSC
62 | 1 | 25MHz | X2 | CRYSTAL-SMD_4P-L3.2-W2.5-BL | 25MHz | X322525MOB4SI | YXC(扬兴晶振) | C9006 | LCSC
28 | 2 | 2K | R6,R59 | R0402 | 2K
61 | 1 | 32.768kHz | X1 | CRYSTAL-SMD_L3.2-W1.5-1 | 32.768kHz | XKXGI-SUA-32.768K | YXC(扬兴晶振) | C5213671 | LCSC
40 | 1 | 4.7K | R38 | R0402 | 4.7K
27 | 1 | 47K | R5 | R0402 | 47K
31 | 3 | 47R | R11,R14,R17 | R0402 | 47R
6 | 1 | 47uF | C36 | C0805 | 47uF
7 | 1 | 47uF | C38 | C0402 | 47uF
42 | 1 | 49.9K | R40 | R0402 | 49.9K
37 | 2 | 5.1K | R34,R35 | R0402 | 5.1K
38 | 1 | 50kΩ | R36 | RES-ADJ-SMD_VG039NCH | 50kΩ | VG039NCHXTB503 | HDK(北陆电气) | C145161 | LCSC
39 | 2 | 51K | R37,RNTC | R0402 | 51K
26 | 1 | 6.2K | R4 | R0402 | 6.2K
35 | 2 | 68K | R31,RVST | R0402 | 68K
36 | 1 | 75K | R33 | R0402 | 75K
22 | 6 | AO3400 | Q1,Q2,Q3,Q4,Q5,Q6 | SOT-23_L2.9-W1.3-P1.90-LS2.4-BR |  | AO3400 | GOODWORK(固得沃克) | C2938367 | LCSC
56 | 1 | BAT54C | U15 | SOT-23-3_L2.9-W1.3-P1.90-LS2.8-BR |  | BAT54C | R+O(宏嘉诚) | C22466350 | LCSC
50 | 1 | BM3451UNDC-T28A | U4 | TSSOP-28_L9.7-W4.4-P0.65-LS6.4-BL |  | BM3451UNDC-T28A |  | C94597 | LCSC
15 | 1 | BZT52C16 | D3 | SOD-123_L2.7-W1.6-LS3.7-RD |  | BZT52C16 | R+O(宏嘉诚) | C19077413 | LCSC
49 | 3 | DRV8313PWPR | U1,U2,U3 | HTSSOP-28_L9.8-W4.5-P0.65-LS6.6-BL-EP |  | DRV8313PWPR | TI(德州仪器) | C92482 | LCSC
19 | 1 | GZ1608D601TF 600Ω@100MHz | L3 | L0603 |  | GZ1608D601TF 600Ω@100MHz | Sunlord(顺络) | C1002 | LCSC
16 | 1 | HDR-F_2.54_2x4 | H1 | HDR-TH_8P-P2.54-V-F-R2-C4-S2.54-1 |  |  |  | C92271
12 | 1 | HX25003-4AWB | CN2 | CONN-SMD_4P-P2.50_HX25003-4AWB |  | HX25003-4AWB | HX(红星) | C442363 | LCSC
23 | 1 | HY19P03D | Q7 | TO-252-2_L6.6-W6.1-P4.57-LS9.9-TL-CW |  | HY19P03D | HUAYI(华羿微) | C122492 | LCSC
52 | 3 | HY2213-BB3A | U9,U10,U11 | SOT-23-6_L2.9-W1.6-P0.95-LS2.8-BR |  | HY2213-BB3A | HYCON(宏康) | C113632 | LCSC
53 | 1 | IP2326 | U12 | VQFN-24_L4.0-W4.0-P0.50-BL-EP2.5 |  | IP2326 | INJOINIC(英集芯) | C2832094 | LCSC
20 | 6 | LED_0603-R | LED1,LED2,LED3,LED4,LED5,LED6 | LED_0402
57 | 1 | LSM6DSRTR | U16 | LGA-14_L3.0-W2.5-P0.50-BR |  | LSM6DSRTR | ST(意法半导体) | C784817 | LCSC
58 | 1 | MPU-6050 | U17 | QFN-24_L4.0-W4.0-P0.50-BL-EP2.7 |  | MPU-6050 | TDK InvenSense(应美盛) | C24112 | LCSC
43 | 1 | NC | R42 | R0402 | NC
14 | 1 | PESD3V3L1BA | D2 | SOD-323_L1.7-W1.3-LS2.5-BI |  | PESD3V3L1BA | TECH PUBLIC(台舟) | C2827682 | LCSC
46 | 1 | SK-3296S-01-L1 | SW1 | SW-SMD_3P-P1.50_L2.7-W6.6 |  | SK-3296S-01-L1 | XKB Connection(中国星坤) | C319020 | LCSC
48 | 1 | SS12D10G4 071 | SW3 | SW-TH_SHOU-HAN_SS12D10G4 |  | SS12D10G4 071 | SHOU HAN(首韩) | C2887259 | LCSC
55 | 1 | STM32F407ZGT6 | U14 | LQFP-144_L20.0-W20.0-P0.50-LS22.0-BL |  | STM32F407ZGT6 | ST(意法半导体) | C19156 | LCSC
51 | 4 | TPN2R703NL | U5,U6,U7,U8 | TSON-8_L3.1-W3.1-P0.65-LS3.3-BL-EP |  | TPN2R703NL |  | C2939631 | LCSC
54 | 1 | TPS565201DDCR | U13 | SOT-23-6_L2.9-W1.6-P0.95-LS2.8-BR |  | TPS565201DDCR | TI(德州仪器) | C327676 | LCSC
47 | 1 | TS-1088-AR02016 | SW2 | SW-SMD_L3.9-W3.0-P4.45 |  | TS-1088-AR02016 | XUNPU(讯普) | C720477 | LCSC
60 | 1 | TYPE-C16PIN | USB1 | USB-C-SMD_TYPE-C16PIN |  | TYPE-C16PIN | SHOU HAN(首韩) | C393939 | LCSC
11 | 1 | XT30PW-M30.G.Y | CN1 | CONN-TH_XT30PW-M |  | XT30PW-M30.G.Y | AMASS(艾迈斯) | C431092 | LCSC
59 | 3 | ZX-SH1.0-4PWT | U18,U19,U20 | CONN-SMD_4P-P1.00_MEGASTAR_ZX-SH1.0-4PWT |  | ZX-SH1.0-4PWT | Megastar(兆星) | C7430446 | LCSC
