TDX33029/Cubli-STM32F407-ESP32/Statistics/04_PID控制输出与姿态误差/control_components.png

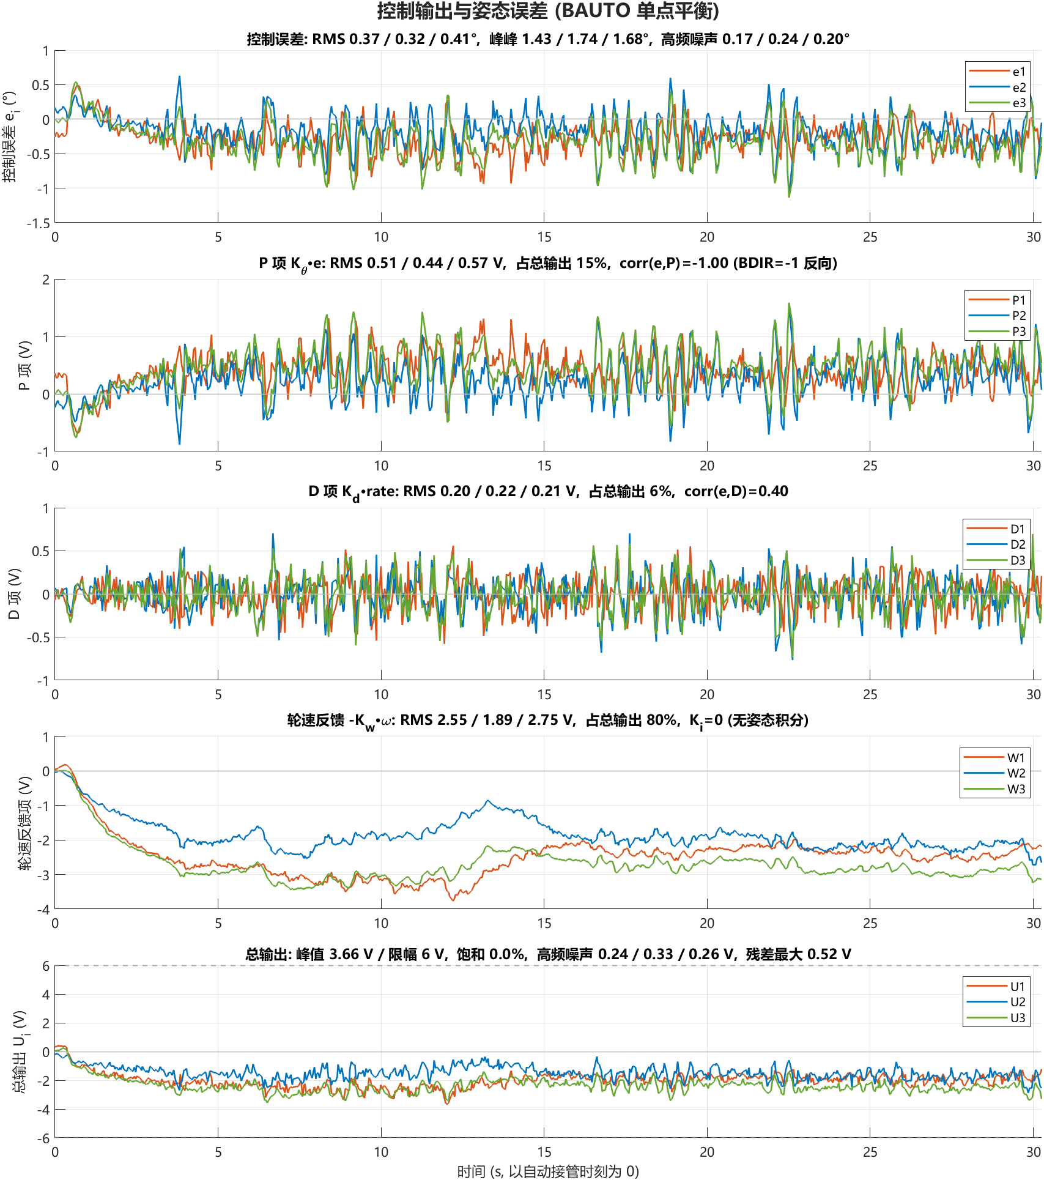
Statistics/04_PID控制输出与姿态误差/control_components.png
