TDX33029/Cubli-STM32F407-ESP32/Mechanical/3D/底座.SLDPRT

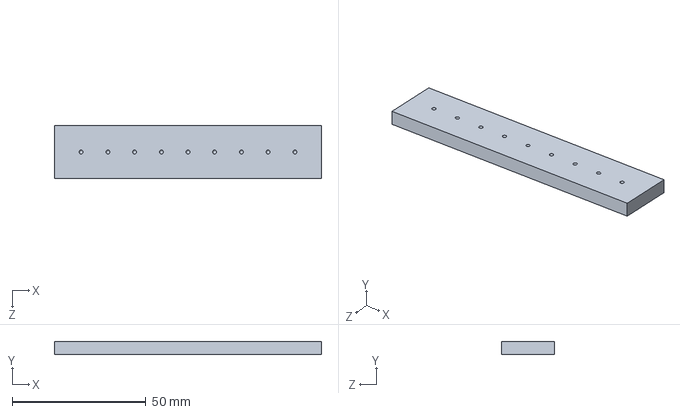
[picture p73: CAD file, 2026-10-19]
Mechanical/3D/底座.SLDPRT
100.0 x 5.00 x 20.0 mm
