TDX33029/Cubli-STM32F407-ESP32/(list of files, cad)

Other CAD files:
Mechanical/STL/底座-261019-1733.STL
