TDX33029/Cubli-STM32F407-ESP32/Statistics/08_IMU校准/imu_calibration_overlay.png

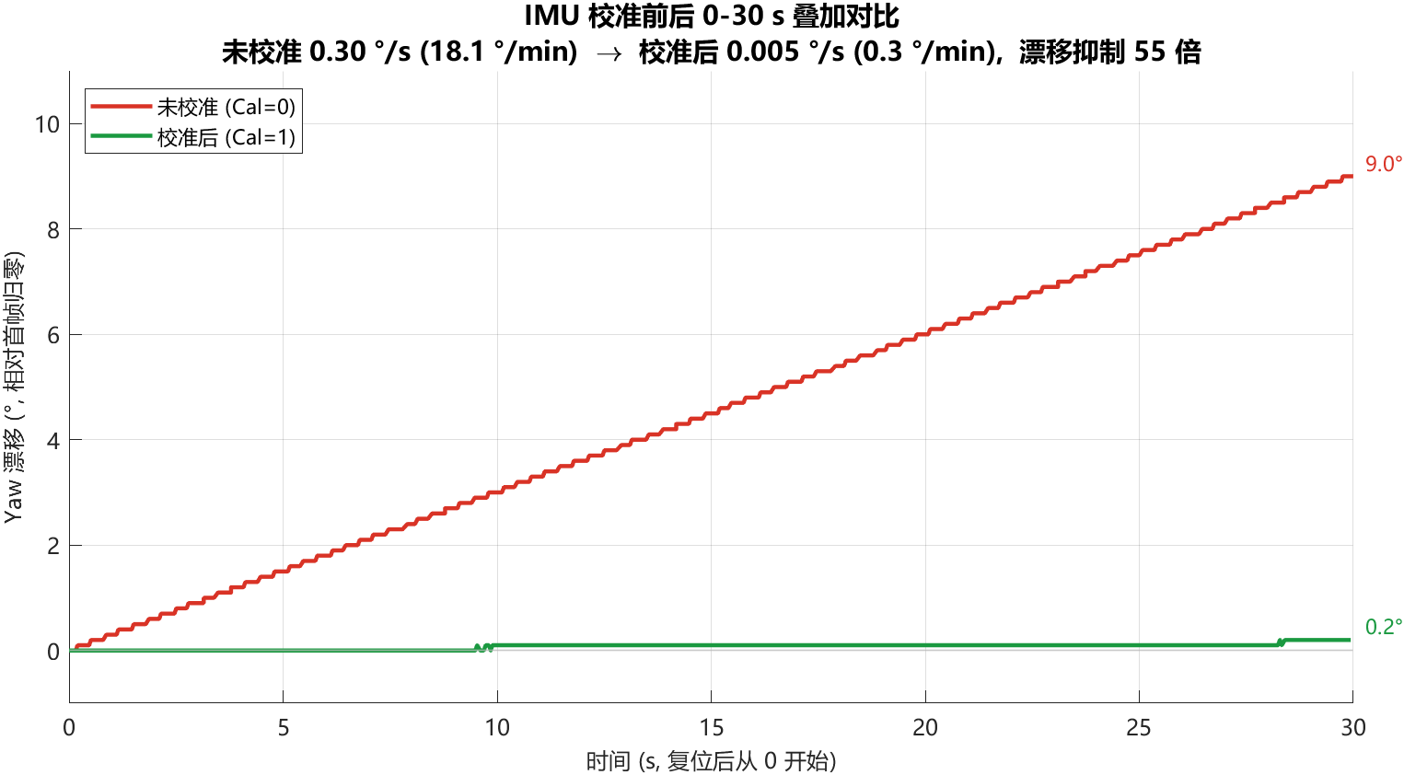
Statistics/08_IMU校准/imu_calibration_overlay.png
