TDX33029/Cubli-STM32F407-ESP32/History/README.md

# Cubli-F407ZGT6 Dialogs

[🇨🇳 简体中文](README.md) | [🇬🇧 English](README_EN.md)

> Cubli STM32F407ZGT6 版本更新日志

## 版本更新日志

- **[260327] Version 0.7**：初版物料选型已完成确定。
- **[260419] Version 0.8**：主板MT6701编码器方案验证通过。
- **[260424] Version 1.1-alpha**：电源保护方案BM3451UNDC存在问题，电机驱动DRV8313存在致命问题。
- **[260424] Version 1.2-alpha**：增添大量调试指示用LED，每个DRV8313配备三颗LED分别用于显示 使能/主机调用/故障 状态，每个主模块配备 LED 指示。
- **[260607] Version 1.2-alpha**：电源管理BM3451UNDC存在无法修复的问题，切换为中颖SH367103x管理方案，版本迭代为Version 1.3-alpha。修改存在的编码器端子不适配问题。
- **[260923] Version 1.4-pre**：电源保护方案验证通过，等待验证航模电池充电功能，规划加入ESP32-WROOM用于无线调试，版本迭代为Version 1.4。
- **[261007] Version 1.4**：Version 1.4版本完成，修复已知的小问题。
- **[261018] Version 1.4-release**：史无前例的单点平衡已经实现，准备迁移到无线串口。
