TDX33029/Cubli-STM32F407-ESP32/History/260424完备v1追加补丁/完备资源分配0424.xlsx

定时器类型 | 编号 | 计数位宽 | 编码器模式 (Encoder) | PWM 通道数 | 备注
高级定时器 | TIM1, TIM8 | 16 位 | 支持 | 4 (加互补输出) | 带死区
通用定时器 | TIM2, TIM5 | 32 位 | 支持 | 4 | NML
通用定时器 | TIM3, TIM4 | 16 位 | 支持 | 4 | STD
通用定时器 | TIM9~TIM14 | 16 位 | 不支持 | 1 或 2 | NML PWM GEN
基本定时器 | TIM6, TIM7 | 16 位 | 不支持 | 0
硬件资源 | 协议 | 资源占用 | 引脚资源占用
MT6701-1 | ABZ | TIM2 | PA5，PB3
MT6701-2 | ABZ | TIM5 | PA0，PA1
MT6701-3 | ABZ | TIM3 | PA6，PA7
DRV8313PWPR-1 | PWM Gen | TIM1 | PA8，PA9，PA10
DRV8313PWPR-2 | PWM Gen | TIM4 | PB6，PB7，PB8
DRV8313PWPR-3 | PWM Gen | TIM8 | PC6，PC7，PC8
MT6701-1 | I2C | I2C1 | PB6 PB7 | 验证
MT6701-2 | I2C | I2C2 | PF0 PF1
MT6701-3 | I2C | I2C3 | PA8 PC9
DRV8313PWPR-1 | PWM Gen | TIM1 | PE9 PE11 PE13 | 验证
DRV8313PWPR-2 | PWM Gen | TIM3 | PA6 PA7 PB0
DRV8313PWPR-3 | PWM Gen | TIM4 | PD12 PD13 PD14
M-EN | - | GPIO | PD0，PD1，PD2
陀螺仪LSM6DSRTR | SPI | SPI2 | PB12，PB13，PB14，PB15
陀螺仪MPU6050 | IIC | IIC2 | PB10，PB11 | IIC冲突
调试串口 | USART | USART2 | PD5-PD7
烧录口 | SWCLK-SWDIO | - | PA13，PA14
LED指示
供电PWR | - | GPIO | -
工作WRK | - | GPIO
警告WRN | - | GPIO
错误ERR | - | GPIO
周期HBT | - | GPIO
停止状态 | - | GPIO
调整状态 | - | GPIO
稳定状态 | - | GPIO
