TDX33029/Cubli-STM32F407-ESP32/History/260327备份提交/资源分配定义0327改.xlsx

定时器类型 | 编号 | 计数位宽 | 编码器模式 (Encoder) | PWM 通道数 | 备注
高级定时器 | TIM1, TIM8 | 16 位 | 支持 | 4 (加互补输出) | 功能最强，带死区控制
通用定时器 | TIM2, TIM5 | 32 位 | 支持 | 4 | 首选用于编码器（不溢出）
通用定时器 | TIM3, TIM4 | 16 位 | 支持 | 4 | 标准通用定时器
通用定时器 | TIM9~TIM14 | 16 位 | 不支持 | 1 或 2 | 资源受限，仅适合简单 PWM
基本定时器 | TIM6, TIM7 | 16 位 | 不支持 | 0 | 仅用于触发 DAC 或简单定时
硬件资源 | 协议 | 资源占用 | 引脚资源占用
MT6701-1 | ABZ | TIM2 | PA5，PB3
MT6701-2 | ABZ | TIM5 | PA0，PA1
MT6701-3 | ABZ | TIM3 | PA6，PA7
DRV8313PWPR-1 | PWM | TIM1 | PA8，PA9，PA10
DRV8313PWPR-2 | PWM | TIM4 | PB6，PB7，PB8
DRV8313PWPR-3 | PWM | TIM8
