TDX33029/Cubli-STM32F407-ESP32/History/260424完备v1追加补丁/VectorICO.png

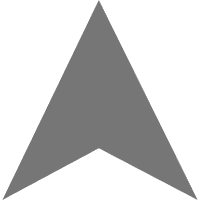
History/260424完备v1追加补丁/VectorICO.png
