TDX33029/Cubli-STM32F407-ESP32/Firmware/Cubli-ST-Statistics/CubeMX.ioc

Mcu.UserName=STM32F407ZGTx
PA0-WKUP.Signal=S_TIM5_CH1
PA1.Signal=S_TIM5_CH2
PA10.Signal=USART1_RX
PA13.Signal=SYS_JTMS-SWDIO
PA14.Signal=SYS_JTCK-SWCLK
PA5.Signal=S_TIM2_CH1_ETR
PA6.Signal=S_TIM3_CH1
PA7.Signal=S_TIM3_CH2
PA8.Signal=I2C3_SCL
PA9.Signal=USART1_TX
PB0.Signal=S_TIM3_CH3
PB10.Signal=GPIO_Output
PB11.Signal=GPIO_Output
PB12.Signal=GPIO_Output
PB13.Signal=SPI2_SCK
PB14.Signal=SPI2_MISO
PB15.Signal=SPI2_MOSI
PB3.Signal=S_TIM2_CH2
PB6.Signal=I2C1_SCL
PB7.Signal=I2C1_SDA
PC6.Signal=S_TIM8_CH1
PC7.Signal=S_TIM8_CH2
PC9.Signal=I2C3_SDA
PD0.Signal=GPIO_Output
PD1.Signal=GPIO_Output
PD12.Signal=S_TIM4_CH1
PD13.Signal=S_TIM4_CH2
PD14.Signal=S_TIM4_CH3
PD2.Signal=GPIO_Output
PD5.Signal=USART2_TX
PD6.Signal=USART2_RX
PD7.Signal=GPIO_Input
PE11.Signal=S_TIM1_CH2
PE13.Signal=S_TIM1_CH3
PE9.Signal=S_TIM1_CH1
PF0.Signal=I2C2_SDA
PF1.Signal=I2C2_SCL
PG0.Signal=GPIO_Output
PG1.Signal=GPIO_Output
PG2.Signal=GPIO_Output
PG3.Signal=GPIO_Output
PG4.Signal=GPIO_Output
PG5.Signal=GPIO_Output
PG6.Signal=GPIO_Output
PG7.Signal=GPIO_Output
PG8.Signal=GPIO_Output
PH0-OSC_IN.Signal=RCC_OSC_IN
PH1-OSC_OUT.Signal=RCC_OSC_OUT
