TDX33029/Cubli-STM32F407-ESP32/(commit log)

2026-10-18 Record calibrated Kp120 trials and verify commanded control output
2026-10-18 Keep corner wheel feedback in tilt plane to avoid yaw momentum growth
2026-10-18 Back up eight-second bounded neutral balance with low wheel speeds
2026-10-18 Record sixty-second neutral balance without wheel-speed runaway
2026-10-18 refactor: restructure repo into Firmware/ and History/ layout
    - move 无刷闭环联调/{Cubli-ST,Cubli-ESP,Software,diagnostics,tests,*.md} -> Firmware/
    - move 历史提交归档/* -> History/
    - drop stray tracked Software/__pycache__/main.cpython-310.pyc
2026-10-18 结构整理 无效文件清理
2026-10-19 Add base CAD exports and refresh demo links
    Add the SolidWorks part and STL export, and update the balancing demo link in both READMEs.
2026-10-23 Add 07 motor multi-level speed step response experiment (data, scripts, static and animated figures)
2026-10-23 Add 08 IMU calibration yaw drift experiment (data, scripts, static and animated figures)
2026-10-23 Add Cubli-ST firmware variant with extended statistics telemetry (Yaw, gyro bias, Cal flag)
2026-10-25 Make the BSTART/BAUTO balance countdown complete without the UART heartbeat
    A balance session armed by BSTART/BAUTO was aborted 1.5s after the serial
    cable was unplugged: Control_SafetyTick tripped on the stale PING heartbeat
    and LQR_Balance_Loop latched FALL_PROTECT, so the device never entered the
    countdown while waiting in pose.
    Add a standalone-session latch set only when BSTART/BAUTO is accepted and
    cleared when the state machine returns to DISABLED or FALL_PROTECT. While
    the latch is set, only the heartbeat checks (safety tick, motor arming,
    PG8 ready LED) are waived; encoder freshness, main-loop liveness, fault
    pins and all LQR protections stay enforced. Debug mode, BAL 1 and BPROBE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
2026-10-26 Document Statistics directory
    Add Statistics to the Chinese and English project directory tables. Simplify its README by removing outdated tool, device-link, calibration, and experiment-numbering notes.
