TDX33029/Cubli-STM32F407-ESP32/(notices)

Notices in the files:
Firmware/Cubli-ST/Core/Src/tim.c:
Copyright (c) 2026 STMicroelectronics.
All rights reserved.
This software is licensed under terms that can be found in the LICENSE file
